vhrdtech/kicad-library/README.md

VHRD KiCad library
---

VHRD's own KiCad parts: the symbols and footprints behind VHRD's boards, three project templates, and `kilib`, a
small CLI that sets up and checks the library. The symbols, footprints and templates are free to reuse (see
"Licence" below); 3D models and third-party parts live outside this repo.

## Layout

Symbols live one per file in `symbols/VHRD_<KiCad library>.kicad_symdir` (KiCad 10's own layout), footprints in
`footprints/VHRD_<KiCad library>.pretty`: each library is named `VHRD_` plus the stock KiCad library it would
belong to, e.g. `VHRD_Connector_Molex` or `VHRD_Package_DFN_QFN`. Every part, whoever drew it first, is sorted the same
way; there is no separate vendor library (the private `VHRD_Vendor` one was folded in on 7 Nov 2026). KiCad's stock
footprints and symbols that a board uses are copied into the `VHRD_*` library of the same name (`VHRD_Resistor_SMD`,
`VHRD_Transistor_BJT`), so a KiCad update never changes them unannounced; `kilib stock diff` shows what upstream
changed since. No symbol of the library names a stock footprint or library: KiCad's stock libraries
need not be installed (`kilib check --only VHRD_`).

## Configuration

The library has two parts, each found through a KiCad path variable:

- `VHRD_LIBRARY_DIR`: this checkout, with `symbols/VHRD_*.kicad_symdir` and `footprints/VHRD_*.pretty`.
- `VHRD_3DMODEL_DIR`: the 3D models, in `own/` and `vendor/`. They are not part of this repo.

`kilib setup --map migrate/2026-11.toml --models-dir DIR` writes the library rows and the variables
into this PC's KiCad config (see below). `KICAD_USER_TEMPLATE_DIR` points at `templates/`, so File, New Project from
Template offers "Vhrd Default", IO30 and Hammond-1455C801. Each template embeds its drawing sheet.

Without `kilib setup`, set the two variables and the library rows by hand: in KiCad's "Configure Paths", point
`VHRD_LIBRARY_DIR` at this checkout and `VHRD_3DMODEL_DIR` at the 3D models' folder. Then add a row per library in "Manage
Symbol Libraries" / "Manage Footprint Libraries": name it after the folder, type KiCad, and point it at
`${VHRD_LIBRARY_DIR}/symbols/<name>.kicad_symdir`, and the
same under `footprints/<name>.pretty` for footprints.

## Checking boards: kilib

`tools/kilib` is a small Rust CLI (MIT) that knows how KiCad finds libraries. `just install` builds it and puts
`kilib` on PATH.

- `kilib check PATH...` reads every `.kicad_sch`, `.kicad_pcb`, `.kicad_sym` and `.kicad_mod` under the paths and
  checks that each symbol (`lib_id`), `Footprint` field, footprint and 3D model resolves on this PC. It uses the
  global `sym-lib-table` and `fp-lib-table` and the "Configure Paths" variables of the KiCad config folder
  (`KICAD_CONFIG_HOME`, else `~/.config/kicad`, the newest version), each project's own tables, `${KIPRJMOD}`, the
  environment (which wins, as in KiCad) and the older `KICAD6..9_3DMODEL_DIR` falling back to the newest set. It exits
  1 with the list of what does not resolve; `--json` gives the same as JSON. `--config-dir`, `--sym-lib-table`,
  `--fp-lib-table` and `--var NAME=VALUE` check against another PC's setup. `--only VHRD_` also fails on anything
  from a library whose name does not start with the prefix: a symbol, footprint or `Footprint` field, a schematic's
  embedded symbols (`lib_symbols`) and the library part of `ki_fp_filters`, so a board that still needs KiCad's stock
  libraries shows.
- `just check-boards` runs it on the hw checkout beside this one (or `VHRD_BOARDS_DIR`) and skips with a note where
  there is none.
- `kilib setup --dry-run` shows what `kilib setup` would write into this PC's KiCad config. The library rows go
  through `${VHRD_LIBRARY_DIR}` (this checkout) and `${VHRD_VENDOR_LIBRARY_DIR}` (the private vendor library,
  `--vendor-dir`). They come from a rename map's `[libraries.symbol]` and `[libraries.footprint]` tables (`--map
  migrate/2026-11.toml`), or else from the library folders found. They replace every `vhrd_*` and `VHRD_*` row. The
  variables are `VHRD_LIBRARY_DIR`, `VHRD_VENDOR_LIBRARY_DIR` and `VHRD_3DMODEL_DIR` (`--models-dir`), each only when
  given, plus `VHRD_TEMPLATE_DIR` and `KICAD_USER_TEMPLATE_DIR` for the drawing sheets. Every other row and setting
  stays as it is. It refuses while KiCad runs.
- `kilib migrate --map migrate/2026-11.toml PATH...` moves boards to a new library layout. It rewrites only the
  strings the map matches, and every other byte stays as it was: symbol ids (`lib_id`, `lib_name` and the schematic's
  `lib_symbols` cache), `Footprint` fields, `ki_fp_filters` entries, footprint ids, `${VHRD_3DMODEL_DIR}` model paths
  (and absolute paths into a `kicad-library/3dmodels` folder), and the old `vhrd_*` rows of a project's
  `sym-lib-table` and `fp-lib-table`, which become the rows of the new libraries. An id is looked up in `[symbol]` /
  `[footprint]` first, then its old library in `[symbol_lib]` / `[footprint_lib]`. `[filter_lib]` renames the library part of
  `ki_fp_filters` patterns (`"Connector*" = "VHRD_Connector*"`). `[per_package."Lib:Generic"]` moves a placed
  generic symbol to its per-package symbol by the footprint it is placed with (below); the schematic's `lib_symbols`
  cache gets a copy of the generic under the new name, with the footprint in `Footprint` and `ki_fp_filters`. It prints a unified diff (`git
  apply` takes it inside the folder given); `--write` applies it and `--stat` shows only the summary. A footprint the
  map dropped (`""`) that a board still uses, or two cached symbols that would get one name, is an error: it exits 1
  and writes nothing. Names the map does not know are listed and left as they are. A second run changes nothing.
- `kilib per-package --map migrate/2026-11-packages.toml [BOARD...]` makes per-package symbols. A generic symbol
  (`VHRD_Device:R`) leaves `Footprint` empty, so what is keyed by the library symbol (a footprint review, a BOM line)
  cannot cover it; each package it is placed with gets a symbol of its own (`VHRD_Device:R_0402`), derived from the
  generic in its library (`extends`), with `Footprint` and `ki_fp_filters` set to the footprint. The map's
  `[per_package]` tables name them. Those the checkout lacks are listed (exit 1) or written with `--write`; those
  there are checked. With boards, it lists the generic symbols their schematics place, by footprint, with the map's
  symbol or "not in the map", and their references. Then `kilib migrate --map migrate/2026-11-packages.toml BOARD`
  moves the board onto them. The generic symbols stay for new designs.
- `kilib restructure --map migrate/2026-11.toml --vendor-dir DIR` moves this checkout's own symbols and footprints
  into the map's new libraries. Each `symbols/<old>.kicad_sym` becomes one `.kicad_sym` per symbol in
  `symbols/<New>.kicad_symdir`, as KiCad 10's own libraries are laid out (a `/` in a name is `{slash}` in the file
  name; a derived symbol goes to its parent's library). Footprints move to `footprints/<New>.pretty`. Libraries under
  `${VHRD_VENDOR_LIBRARY_DIR}` go to `DIR`. The text of each symbol and footprint stays as it was, except what
  `migrate` rewrites in it (model paths, `Footprint` fields). The old files are removed once the new ones are written.
  `--dry-run` lists every move.
- `kilib designators [PATH...]` keeps each footprint's designator on its own layer only (default: this
  checkout's `footprints/`; `kilib fab-designators` is its old name). F.Fab and B.Fab carry the drawing alone
  (outline, pin-1 and polarity marks, inner lines), no text. A real part's designator goes to `Ref.Des.F` (User.23;
  `Ref.Des.B`, User.24, for a bottom-side footprint); test points, net ties (net ties, spark gaps, solder jumpers)
  and mechanical or graphic footprints (mounting holes, fiducials, logos) use their own layers `Ref.Test`, `Ref.Tie`
  and `Ref.Mech`, the class decided from the footprint's library and name and the designator's prefix (TP; NT, E,
  JP; H, FID). The `Reference` property goes there, visible and unlocked (a mechanical one hidden, where it was);
  `${REFERENCE}` texts on the silkscreen, the fab layer and the designator's layer go. The text's ink, measured in
  KiCad's stroke font with its strokes, sits centred on the body: the fab outline, else the courtyard. It may run
  over the pads, since KiCad draws the selected layers on top of them, while text outside the body would run into
  the neighbouring parts. A library footprint is sized for the longest designator of its kind (`R1004`, `C1001`,
  `TP526`, `JP104`, `U1004`). 0.02 mm stays free between the text's strokes and every line of the fab drawing of the
  same side (outline, polarity and pin-1 marks, diode symbols, inner lines), so the two read together. It gets the
  largest size from 1 mm down to 0.2 mm that fits on the centre, level or turned to read top to bottom. Where neither fits, it moves to
  the largest free spot inside the body nearest the centre. The smallest parts (0201, 01005, SOD-523) may go down to
  0.15 mm, and the report lists them as "tiny". Where nothing fits at all it stays on the centre at 0.2 mm, and the
  report lists the footprint as "no clean fit". The text's stroke is 15 % of its size, at least 0.025 mm. Every line
  on F.Fab and B.Fab gets a 0.05 mm stroke. A footprint that already follows these rules is left alone. It lists
  what would change, with how many designators move, get resized and turn, and the sizes given, and exits 1;
  `--write` writes it. Boards take the new footprints through pcbnew's "Update Footprints from Library". A real
  part's `Value` property goes to `Value.F` (User.17; `Value.B`, User.18, on the back), shown and unlocked, centred
  and fitted the same way for the longest typical value of its kind (`100K`, `100nF`, `4.7uH`, `BAS16TW`,
  `TPS54202`). The designator is no obstacle to it: Ref.Des and Value are both centred, so they are separate layers
  shown one at a time. The Value of a test point, net tie or mechanical footprint stays hidden on the fab layer,
  where it was.
- `kilib designators --board BOARD.kicad_pcb` fits each placed footprint's own designator the same way, so `R7`
  gets larger text than `R1004` would, and each real part's Value on `Value.F`/`Value.B` for its own text (`10K`).
  It touches only footprints whose Reference (and Value) is already on its layer (as the library puts it), and of
  those only the two properties' position, angle, size and thickness; the angle is written so the text reads left to right or top to bottom, as the editor shows it from
  its side (0° or 270° on the front, 0° or 90° on the back, a part's rotation included; see "Text direction" below). A `Layout_Critical` or `Layout_Important` note that is set gets the same on `Crit`/`Imp`, fitted to its own
  text beside the body inside the courtyard, along an edge or turned to read top to bottom at an end (see `layout` below), down to 0.05 mm (a short note reads fine much smaller
  than a designator) before it is reported with no clean fit; on a real part a set note that sits elsewhere or
  hidden (Update PCB from Schematic puts a field the footprint lacked hidden on the fab layer) is moved to its
  layer, shown. Each pin number of a part placed at a quarter turn (`Pins.F`/`Pins.B`, written by `lint --rule pins`) is
  turned by a half turn where needed so it reads left to right or top to bottom, its ink where it was, so the library's
  clearances hold; numbers at another angle, and those of parts on the back, are listed and left. `--write` writes the
  board.
- Text direction: every text kilib places (designators on `Ref.Des`/`Ref.Test`/`Ref.Tie`, Values, layout notes, pin
  numbers) reads left to right or top to bottom, never upside down or bottom to top, as the PCB editor shows it from
  the text's side. KiCad stores a text's angle as it is on the board and kilib writes `(unlocked yes)`, so the editor
  does not turn it back upright. On the front a text is at 0° (left to right) or 270° (top to bottom); on the back,
  mirrored, at 0° or 90°, seen with KiCad's default left-to-right board flip. A part's rotation adds to its texts'
  angle, so `kilib designators --board` writes each text's angle as the rotation plus its own, normalised to those
  two. The rule is in `kilib::reading`, used by all of them.
- `kilib layers BOARD.kicad_pcb...` names the user layers the library uses in a board's layer table, front and back
  pairs so KiCad flips a bottom-side footprint's text to the back one: User.9/10 `Ref.Test.F`/`Ref.Test.B` (test
  points), User.11/12 `Ref.Tie.F`/`Ref.Tie.B` (net ties, spark gaps, solder jumpers), User.13/14
  `Ref.Mech.F`/`Ref.Mech.B` (mounting holes, fiducials, logos; designator hidden), User.15/16 `Rooms.F`/`Rooms.B`
  (hand-drawn outlines of the circuit blocks), User.17/18 `Value.F`/`Value.B` (each real part's Value), User.19/20
  `Pins.F`/`Pins.B` (pin numbers), User.21/22 `Centroid.F`/`Centroid.B` (a cross on each placed footprint's origin),
  User.23/24 `Ref.Des.F`/`Ref.Des.B` (the designators of real parts), User.25/26 `Crit.F`/`Crit.B` and User.27/28
  `Imp.F`/`Imp.B` (a real part's layout-priority notes, see "Layout priority"), User.5/6 `Body.F`/`Body.B` (a
  part's full top view, the outline of its 3D model: the table body of the parts `kilib footprint chip` makes, the
  STEP model's top view of the others, drawn by hw's `tools/footprint_tools`; test points, net ties and mechanical
  footprints have none), User.7/8 `Xray.F`/`Xray.B` (every edge of the 3D model seen from above, hidden ones
  included: leads, terminations, bottom and exposed pads under the body, the pin-1 notch; the Pins presets show it,
  so pin numbers read against where the pins are), User.29/30 `Pin1.F`/`Pin1.B` (a dot or, on a polar two-pin part,
  a bar on pin 1's own pad, shown with the body, which has no pin-1 mark of its own; `kilib lint --rule pin1-body`).
  KiCad pairs user layers only by number (User.5 flips to
  User.6, never to User.7), so each pair is an odd number and the next. KiCad's own `Dwgs.User` and `Cmts.User`
  are named `Dimensions` and `Fab.Notes`. Bodies drawn before the Body pair existed (footprint drawings on User.2,
  then named `Body.F`, which KiCad did not flip) move to `Body.F` or `Body.B` by the footprint's side, and User.2
  loses the name; the board's own drawings on User.2 stay. A board still in KiCad 8's layer numbering is refused: open and save it in KiCad 10 first. The
  templates have them; a board made before needs them once, with
  `kilib layers --write` or by hand in Board Setup > Board Editor Layers (add the user layers, name them, set
  their type to front or back). A number the board already uses under another name is left alone and reported.
  Only the layer table and the layer of those old bodies change.
- `kilib presets PROJECT.kicad_pro...` writes the PCB Editor's layer presets of `generate/layer-presets.toml` into
  a project's `board.layer_presets`: `Layout.F`/`B` (F.Cu/B.Cu, F.Fab/B.Fab, Crit, Imp, Ref.Des, Courtyard,
  Edge.Cuts; pads, vias and ratsnest shown), `Floorplan.F`/`B`/`FB` (Courtyard, Ref.Des, Crit, Imp, Body, Pin1, Ref.Test, Ref.Tie, Edge.Cuts), `Assembly.Ref.F`/`B` and `Assembly.Value.F`/`B` (Body, Pin1, Ref.Des or Value, Edge.Cuts; pads shown), `Pins.F`/`B` (Pins, Fab, Xray, Edge.Cuts; pads shown) and `Silk.F`/`B` (SilkS, Mask, Paste, Cu, Edge.Cuts), each `B`
  the back counterpart, viewed from below. A preset already in the project under the same name is replaced; the
  project's other presets are kept, in their place. The sibling board (same name, `.kicad_pcb`) is checked for the
  user layers the presets name; a board that lacks one is told to run `kilib layers --write` first. Only
  `board.layer_presets` changes, byte for byte; the three templates have them. Without `--write` it lists what
  would change and exits 1 when anything would.
- `kilib lint [PATH...]` checks footprints against the library rules (default: this checkout's `footprints/`;
  `--rule` picks some of them) and lists, per footprint, what each fix changes and what is left for a person
  (`--left` only that, `--json` as JSON). It exits 1 while a fix is not written; `--write` writes them. The designator
  belongs to `designators`: run it after `--write`, since a new chamfer or courtyard can move it. The rules:
  - `pin1`: a part with three or more pins, and a polar two-pin part (diode, LED, battery, polarised capacitor; pin 1
    is the cathode or the plus), marks pin 1 on the fab layer, and on the silkscreen where it draws one. The pads
    often fit the part turned half or a quarter round; for each such turn the drawing must show a mark (a dot, a
    filled shape, a chamfered corner, a diode's cathode bar, a `1` or `+`) by pin 1 and not by the pad the turn takes
    it to. A part is never mirrored, so a SOIC's notch counts. The fix chamfers the pin-1 corner of a rectangular
    fab outline (1 mm, at most a quarter of the shorter side) and puts a filled triangle pointing at pin 1 on the
    silkscreen, outside the body and 0.15 mm clear of the pads. Marks that are missing elsewhere, ambiguous or by
    the wrong pad are reported. A part that wants no pin-1 mark loses the ones it has: a three-pin part whose pads
    already tell pin 1 apart (no turn the pads allow lands pin 1 on another pad: SOT-23, SOT-323, SOT-723), a
    footprint tagged `symmetric`, and a part that works the same placed half a turn round. That is one whose pads,
    turned half round about the origin or the pads' centre, each land on a pad of the same kind and size, and where
    every symbol whose `Footprint` field names it keeps its circuit: pins of one name are one node, and so are the
    pins of one group in `generate/connected-pins.toml` (pins a part joins inside that its symbol names apart); the
    turn moves no node, or swaps the only two it moves of a resistor, capacitor, inductor, ferrite bead, crystal,
    fuse or switch (a 4-pad crystal, the PTS815 tact switch, a DPDT slide switch). A footprint no symbol uses keeps
    its marks. The fix takes off each mark with no twin half a turn round or mirrored (dots, filled or small closed
    shapes, a `1` or `+`; a chamfered corner is squared again) on the fab layer and the silkscreen, and the 3D
    model's pin-1 dimple on Xray.F/B (a lone circle up to 0.5 mm). The outline stays. A keyed connector, switch or
    mechanical part (library `Connector*`, `Button_Switch*`, `Mechanical`) wants no mark either: the body fits only
    one way, and the pinout needs the datasheet anyway (a USB-C receptacle, an RJ45 jack, a D-sub). Keyed means no
    quarter, half or three-quarter turn about the origin or the pads' centre lands every pad, mounting pads and
    holes included, on a pad of the same kind, shape, size and side while the fab body stays where it was. On these
    the fix also fills in a notch cut into the fab outline and takes off a short silkscreen line standing alone by
    pin 1 (KiCad's RJ45 marks). The exception is a row that pin 1 helps to count: the pads numbered 1 to N, N at
    least 4, one size (pin 1's shape may differ), evenly pitched in one row numbered in order, or in a straight
    double row (odd and even across, or one row after the other); mounting pads do not count. Such a connector (FFC,
    board-to-board, pin header) keeps its marks and gets the Pin1 dot; a staggered row (RJ45, D-sub) and named pins
    (USB-C's A1 to B12) are no counting row. Any other part whose pads tell pin 1 apart (a DFN, a module) keeps its
    fab and silkscreen marks, which match the chip's own dot.
  - `pin1-body`: a polar two-pin part (diode, LED, battery, polarised capacitor) gets a bar on `Pin1.F` (User.29;
    `Pin1.B`, User.30) across the cathode or plus pad's centre, square to the part's axis, as long as the pad
    reaches across it, 0.15 to 0.25 mm thick (by part size). A part of three or more pins gets a filled dot instead,
    0.3 mm across on a small part up to 0.8 mm on a big one (a tenth of the body's shorter side, under 0.9 times the
    distance to the nearest other pad), centred on pin 1 — unless the pads alone already tell pin 1 apart (no turn
    the pads allow, `pin1`'s own turns, lands pin 1 on another pad: an asymmetric SOT-23, SOT-323, SOT-89, SOT-223)
    or the part works the same turned half round or is a keyed connector (`pin1` above), which gets no mark either
    (a keyed connector with a row that pin 1 helps to count gets the dot); a symmetric part (QFN, QFP, SOIC, SOT-23-6, SOT-363, a connector with a symmetric pad
    row) keeps the dot. Either mark sits exactly on pin 1's pad (its anchor, the same point for every shape of a
    multi-shape pad): no search for a free spot, no check that it clears another pad. No mark on non-polar two-pin
    parts, test points, net ties and mechanical footprints. The fix replaces anything else on the layer.
  - `attrs`: test points, net ties, spark gaps, jumpers, logos and mounting holes are excluded from the BOM and the
    position files, with no SMD or through-hole type (net ties and logos may have no courtyard); fiducials are SMD
    and excluded from the BOM only; a part is SMD when all its copper pads are, through-hole when one is. `board_only`
    is not set, since boards place these from the schematic. Mechanical footprints (screws, spacers, the enclosure,
    panel features) and parts kept out of the BOM are only reported.
  - `courtyard`: on F.CrtYd (B.CrtYd for a bottom-side footprint), closed, at least 0.25 mm from every pad and from
    the fab drawing, 0.1 mm for 0201, 0402 and 0603 passives (IPC-7351 nominal). The fix draws a missing one as a
    rectangle on a 0.01 mm grid, 0.05 mm wide, and grows one that is a single rectangle; other shapes are reported.
  - `models`: every part has a 3D model under `${VHRD_3DMODEL_DIR}` or `${KICAD10_3DMODEL_DIR}`, and the file exists
    (where the variables are set: KiCad's config, the environment, `--var NAME=DIR`; `--no-model-files` skips the
    files). The fix moves stock models from older KiCad variables to `${KICAD10_3DMODEL_DIR}` (`.wrl` to `.step`).
  - `silk`: lines are 0.12 mm (filled marks keep their stroke); no line reaches onto a pad's solder mask opening (the
    pad's mask expansion, else the footprint's, else 0); no text but pin-1 marks. The fix sets the widths and cuts
    lines, and the sides of rectangles and polygons, round the pads. Arcs and curves over a pad, and texts, are
    reported. Logos and other artwork are left alone.
  - `ref-outline`: a test point draws its pad's outline on its designator layer `Ref.Test` (User.9 / User.10): a
    circle 0.05 mm outside a round pad, else a rectangle 0.05 mm round it. A net tie, spark gap or solder jumper draws
    a rectangle 0.05 mm round its pads on `Ref.Tie` (User.11 / User.12). Lines are 0.05 mm, and the drawing replaces
    anything else on that layer. Mechanical footprints draw nothing on `Ref.Mech`. `designators` then fits the
    designator to this drawing as to a fab outline, and puts it beside the drawing (0.3 mm, else 0.2 mm, nearest)
    where nothing fits inside.
  - `pins`: pin numbers on `Pins.F` (User.19; `Pins.B`, User.20, on the back): every pin of a connector; pin 1 and
    every 5th (every 10th past 40 pins) of another part with three or more pins; pin 1 only where the pins are not
    numbered with digits (a BGA's `A1`); none on two-pin parts, test points, net ties, logos and holes, and none for
    a pad on the copper of one already numbered (USB-C's `B12` on `A1`). Each is a stroke text inside the part, at
    its pad's inner end: inside the fab outline (else the courtyard), toward the body's middle, 0.1 mm clear of every
    pad and hole and a glyph's height from the other numbers; a pad wholly outside the body has its number pulled in
    to the body's edge. Text reads left to right, or top to bottom where level does not fit (on the back level only);
    never upside down or bottom to top. Next to a pad in line, a number stands only where it is nearer its own pad
    than the other (a third as near, for the next pin of the row). A number with no room inside, or a footprint with
    neither fab outline nor courtyard, keeps the number beside its pad, outside and level, and is reported
    (`left`). A footprint gets one size for all its numbers, of 0.5 to 0.2 mm the one with the most numbers inside,
    the largest of those; one that fits nowhere is reported. The fix replaces anything else on the layer.
  - `centroid`: a cross on `Centroid.F` (User.21; `Centroid.B`, User.22) at every part's and fiducial's origin, the
    point the position file gives: two 0.5 mm lines, 0.05 mm wide. Show the layer over the board to check the
    placement data. The fix replaces anything else on the layer.
  - `layout`: every real part has the properties `Layout_Critical` on `Crit.F` (User.25; `Crit.B`, User.26, on the
    back) and `Layout_Important` on `Imp.F` (User.27; `Imp.B`, User.28), visible and unlocked, fitted for the note
    `U1001.48` (down to 0.05 mm, a short note reads fine much smaller than a designator) inside the real
    courtyard beside the body: level along a longer edge, or turned to read top to bottom at a shorter one,
    whichever gives the larger text (a passive's long edges are thin, its ends have room); ties keep the longer pair
    (top/bottom for a courtyard at least as wide as tall, else left/right). Critical takes the best placement,
    Important the opposite side where it fits, clear of the designator's own ink and, for Important, of Critical,
    so they never overlap even though both show together on the Floorplan preset. Where the footprint draws no
    courtyard, or the body already fills it, a note falls back to the centre instead, reported. Test points, net
    ties, mechanical and graphic footprints have neither. The fix adds them or puts them back in place and removes
    a stray one; a note set in the library is
    reported, as the note belongs to the schematic.
- `kilib layout-fields [PATH...]` adds the empty, hidden symbol fields `Layout_Critical` and `Layout_Important`
  where a symbol lacks them: to each symbol of a library file (default: this checkout's `symbols/`), and in a
  schematic to each placed symbol and its copy in the schematic's `lib_symbols`. A new field copies a hidden field of
  the same symbol (`Description`, else `Datasheet`, else `Footprint`), so it is written the way that file writes its
  fields. Power symbols and power flags get none. It lists what would change and exits 1; `--write` writes.
- `kilib stock import Lib:Name...` copies KiCad stock footprints to `footprints/VHRD_<Lib>.pretty/<Name>.kicad_mod`:
  the fixes of `kilib lint`, the designator and the Value placed by the `designators` rules, the fab lines at 0.05 mm, the 3D model at the library's copy of KiCad's model, `${VHRD_3DMODEL_DIR}/vendor/VHRD_<Lib>.3dshapes/` (the STEP file is copied there by hand), every other byte as in stock (pads). The stock folder is `--stock-dir`,
  else `KICAD10_FOOTPRINT_DIR` (environment or KiCad's "Configure Paths"), else `/usr/share/kicad/footprints`. A
  footprint the library has already is left alone. It lists what it would copy and exits 1; `--write` copies. `kilib
  stock diff` compares every `VHRD_<Lib>:<Name>` that has a stock `<Lib>:<Name>` with a fresh import of it and prints
  the unified diff (what taking in the stock footprint would change; `--stat` only lists them); it exits 1 when any
  differs. Footprints of our own that share a stock name show up there too. `migrate/2026-11-stock.toml` maps the
  imported stock ids to the copies for `kilib migrate`.
- `kilib stock import --symbols Lib:Name...` does the same for stock symbols, into
  `symbols/VHRD_<Lib>.kicad_symdir/<Name>.kicad_sym`: a derived symbol is made standalone (its parent's pins, units and
  graphics under its own name and fields), the `Footprint` field points at our copy of the footprint where
  `footprints/` has one, library parts of `ki_fp_filters` patterns get `VHRD_`, and an empty `Mpn1` and the empty
  `Layout_Critical` and `Layout_Important` fields are added. The
  stock folder is `--stock-symbol-dir`, else `KICAD10_SYMBOL_DIR`, else `/usr/share/kicad/symbols`. `kilib stock
  diff` compares the symbols too; a copy's fields and flags are ours, laid over the fresh import, so the diff shows
  what stock changed in pins, units and graphics and the fields stock has that the copy has not. A kind whose stock
  folder is not found is skipped with a note.
- `kilib model chip [NAME...]` writes the STEP models of the chip passives and power inductors in `generate/`
  (`chip-passives.toml`: chip R, C and L, body length, width, termination band and the heights each size is made in;
  `power-inductors.toml`: power-inductor bodies, bottom terminations and lands), one per size and height, as
  `${VHRD_3DMODEL_DIR}/generated/VHRD_<Lib>.3dshapes/<footprint>.step` (`--out DIR` for another folder). Each model is
  the body and its terminations as coloured solids on the board, centred on the footprint origin: an MLCC tan with
  nickel-tin ends, a resistor's white alumina with its black overcoat, ferrite or ceramic chip inductors, dark power
  inductors with their bottom electrodes. The STEP file is written by kilib itself (AP214, straight prisms as
  B-rep solids with a colour each), no CAD kernel involved. It lists what it would write and exits 1; `--write`
  writes.
- `kilib footprint chip [NAME...]` makes the footprints of the same tables, one per size and height. A chip part
  (`C_0805_2012Metric_H1.25`) is its size's base footprint (`C_0805_2012Metric`, the checkout's copy, else a fresh
  `stock import` of KiCad's IPC-7351 nominal one from `--stock-dir`) under the new name, its description naming body
  and height, its model the generated one; pads and drawing stay the base's. A power inductor
  (`L_Shielded_4.0x4.0mm_H2.0`) is drawn from its row (the maker's land, the body on the fab layer) and finished with
  the fixes of `kilib lint` and the designator and Value of `kilib designators`. Only new files are written; one
  that differs from what would be made is reported and left. It lists what it would write and exits 1; `--write`
  writes.
- Shell completion: `source <(COMPLETE=bash kilib)` (or `zsh`, `fish`).

### Layout priority

Parts that need care in layout (low-value decoupling, passives on a differential pair or in a feedback path, a
DC-DC converter's inductor) show in the PCB editor on layers of their own, without picking them out of the schematic
by hand. Two levels: critical (`Crit.F`/`Crit.B`, User.25/26) and important (`Imp.F`/`Imp.B`, User.27/28, bulk
decoupling and the like). The schematic sets a short note in the symbol's `Layout_Critical` or `Layout_Important`
field (`U101.5 VDD`, `FB U301`); Update PCB from Schematic carries it to the footprint's property of the same name,
which shows on its layer; an empty field shows nothing. Every library symbol has both fields, empty and hidden, and
every real part's footprint both properties, empty and shown, fitted beside the body inside the courtyard, along an edge or turned to read top to bottom at an end, rather than
the designator's own centre, so the Floorplan preset (courtyard, fab, Ref.Des and Crit/Imp together) reads the two
apart (`kilib layout-fields`, `kilib lint --rule layout`).

How KiCad 10 treats them, and what a board made before needs:

1. Update PCB from Schematic sets only the text of a footprint field the footprint has: its layer, position and size
   stay as the library put them. An empty symbol field empties the footprint's text. This needs "Update footprint
   fields from symbols" ticked (the default).
2. A field the footprint lacks is created hidden on F.Fab (B.Fab on the back) at the footprint's origin, and "Update
   Footprints from Library" with its default options keeps it there. So update the footprints from the library
   before the first Update PCB from Schematic; `kilib designators --board BOARD --write` moves a set note that went
   to the fab layer.
3. A footprint field the symbol lacks is left alone, unless "Remove footprint fields not found in symbols" is
   ticked.
4. DRC `footprint_symbol_field_mismatch` (a warning, also run by `kicad-cli pcb drc --schematic-parity`) reports a
   footprint that lacks a field its symbol has, empty or not, and a text that differs (one per footprint). A
   footprint field the symbol lacks is not reported. `lib_footprint_mismatch` ignores fields.
5. ERC `lib_symbol_mismatch` reports every placed symbol whose copy in the schematic lacks the fields the library
   now has. "Update Symbols from Library" adds them (its defaults keep a note that is set), and so does `kilib
   layout-fields --write SCHEMATIC_DIR`.

So a board made before the fields needs, in this order: Update Symbols from Library (or `kilib layout-fields`), Update
Footprints from Library, then Update PCB from Schematic. Until both sides have them, the parity DRC warns about
`Layout_Critical` on every footprint.

### Migrating an older board

```sh
kilib migrate --map migrate/2026-11.toml path/to/board            # look at the diff
kilib migrate --map migrate/2026-11.toml --write path/to/board    # apply it
kilib check path/to/board                                         # everything resolves
```

## Licence

The symbols, footprints and templates are CC-BY-SA 4.0 with KiCad's library exception — designs that use them stay
yours; see [LICENSE.md](LICENSE.md). `tools/kilib` is MIT; see [tools/kilib/LICENSE](tools/kilib/LICENSE).

## KiKit

Install KiKit for panelization support: [Installation](https://yaqwsx.github.io/KiKit/latest/installation/intro)

Install just to create shortcuts for various commands like: `just panelize`:
[Just](https://github.com/casey/just#installation)

[Panelization Examples](https://yaqwsx.github.io/KiKit/latest/panelization/examples/)
[Panelization Docs](https://yaqwsx.github.io/KiKit/latest/panelization/cli/)

### Arch

`sudo pacman -S python-kikit`
