vhrdtech/kicad-library/templates/Hammond-1455C801/meta/pcb.jpg

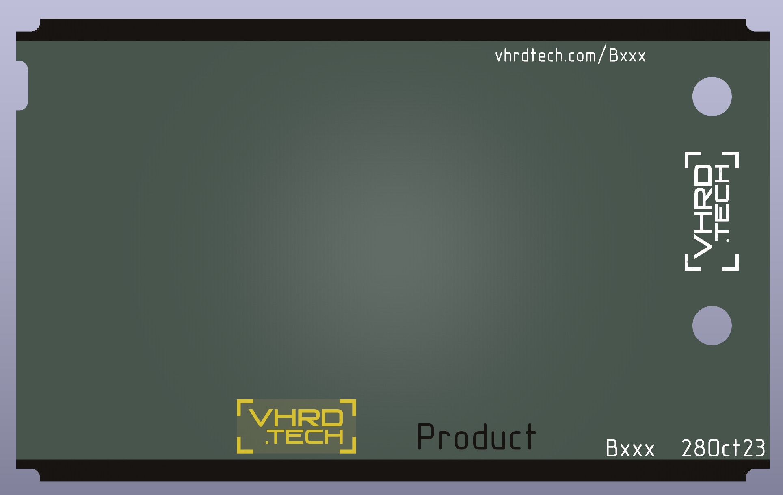
templates/Hammond-1455C801/meta/pcb.jpg
