vhrdtech/kicad-library/3dmodels/boards/vb125c1_button_board.step

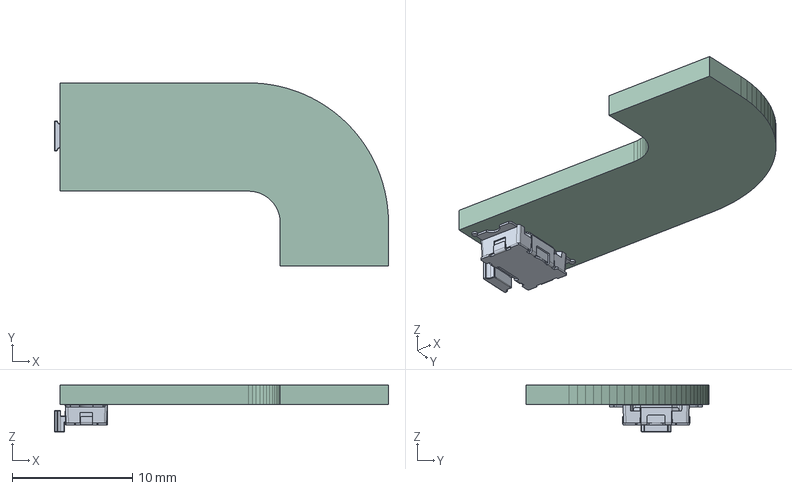
[picture p2: CAD file, 2023-08-31]
3dmodels/boards/vb125c1_button_board.step
27.8 x 15.2 x 3.90 mm
PCB
