vhrdtech/kicad-library/3dmodels/capacitors/CAPC5728.step

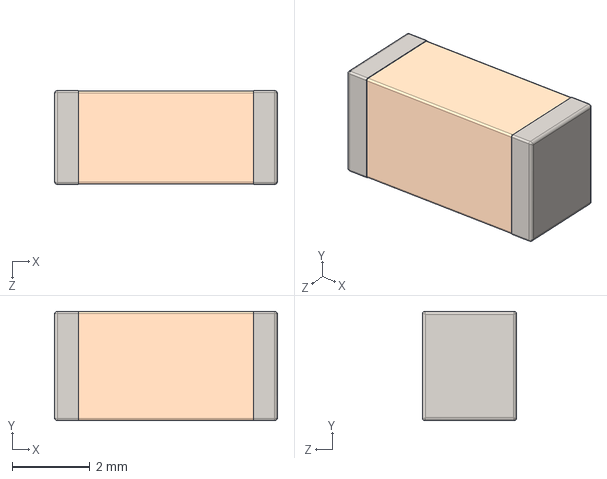
[picture p3: CAD file, 2023-10-09]
3dmodels/capacitors/CAPC5728.step
5.75 x 2.82 x 2.42 mm
