vhrdtech/kicad-library/3dmodels/connectors/amphenol/ID09P33E4GV00LF.STEP

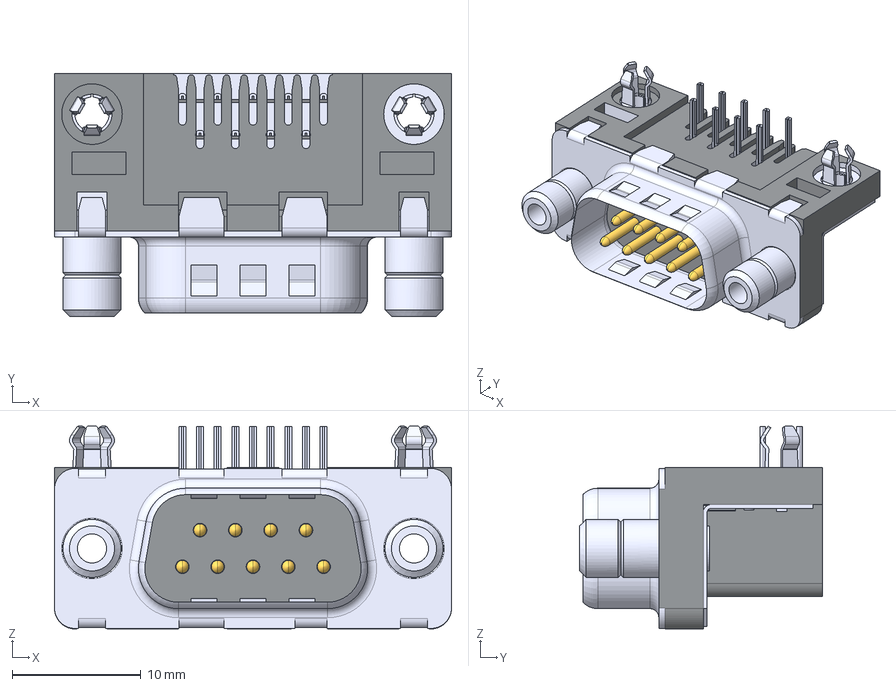
[picture p4: CAD file, 2025-11-09]
3dmodels/connectors/amphenol/ID09P33E4GV00LF.STEP
30.8 x 18.9 x 15.8 mm
