vhrdtech/kicad-library/3dmodels/connectors/battery/CR1632.stp

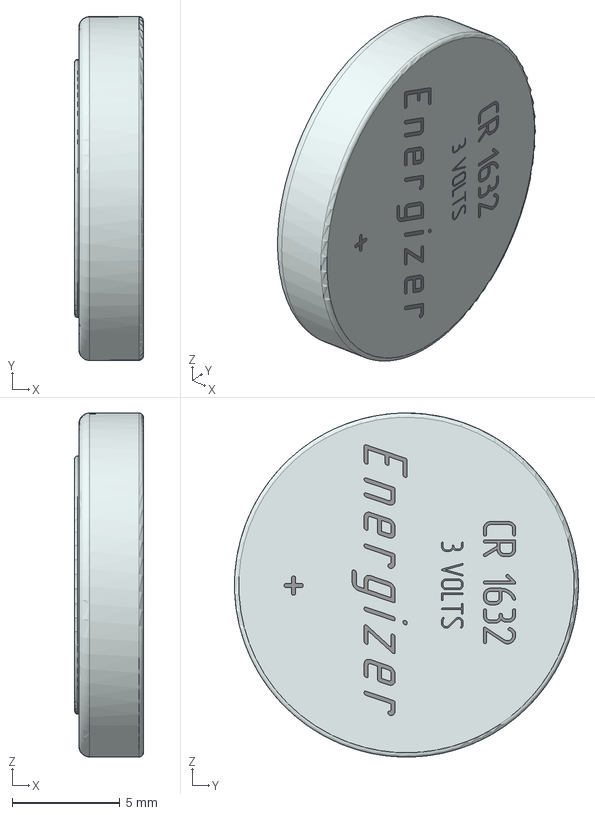
[picture p5: CAD file, 2024-12-04]
3dmodels/connectors/battery/CR1632.stp
3.20 x 16.0 x 16.0 mm
Undefined x 25
