vhrdtech/kicad-library/3dmodels/connectors/DX07P024AJ1R1500.STEP

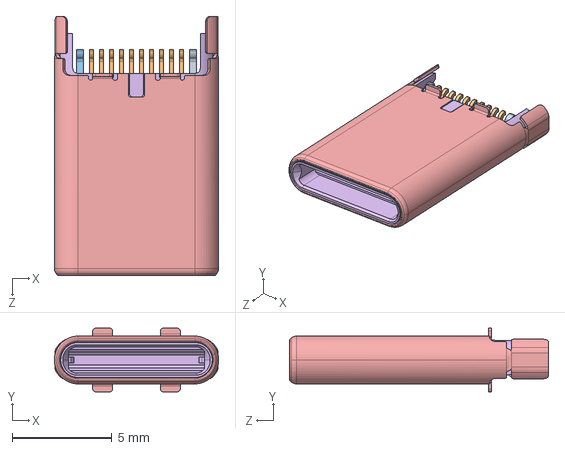
[picture p6: CAD file, 2024-07-14]
3dmodels/connectors/DX07P024AJ1R1500.STEP
8.25 x 3.20 x 13.0 mm
