vhrdtech/kicad-library/3dmodels/connectors/gct/FFC2B35-30-G.step

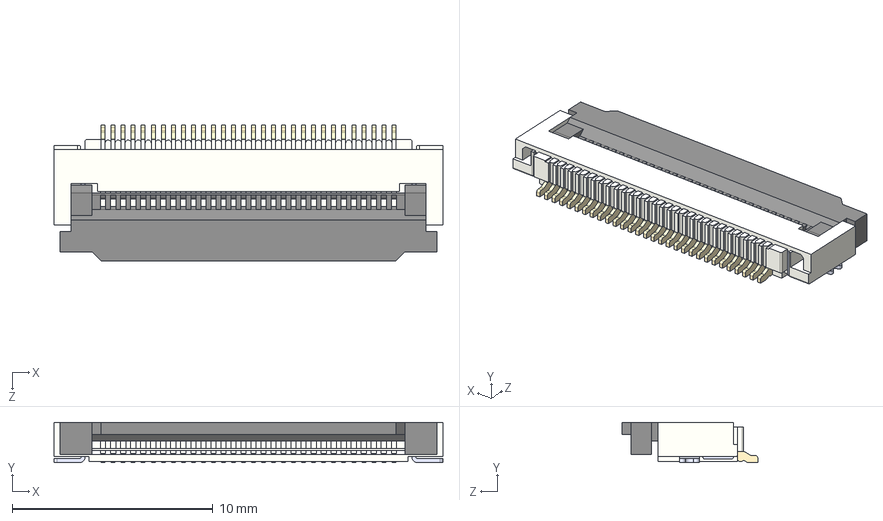
[picture p7: CAD file, 2026-07-28]
3dmodels/connectors/gct/FFC2B35-30-G.step
19.4 x 2.00 x 6.76 mm
