vhrdtech/kicad-library/3dmodels/connectors/globtek/plug-usbc-241smt-th-4bc2ls.stp

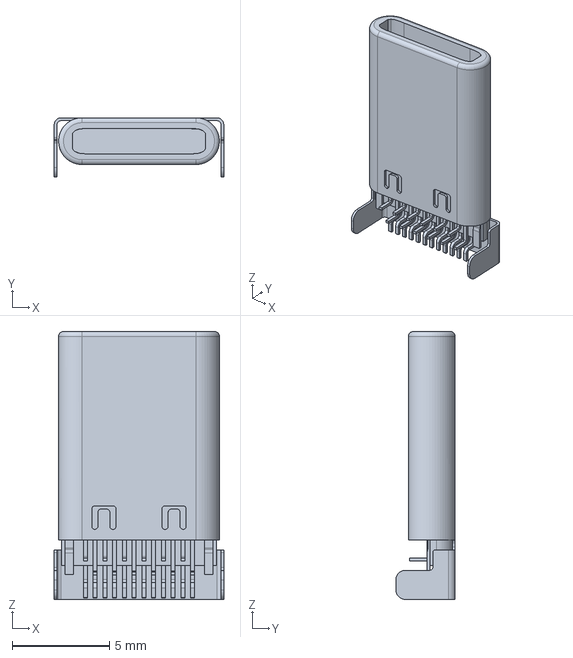
[picture p8: CAD file, 2025-11-09]
3dmodels/connectors/globtek/plug-usbc-241smt-th-4bc2ls.stp
8.70 x 3.05 x 13.8 mm
