vhrdtech/kicad-library/3dmodels/connectors/hirose/FH28K-60S-0.5SH.STEP

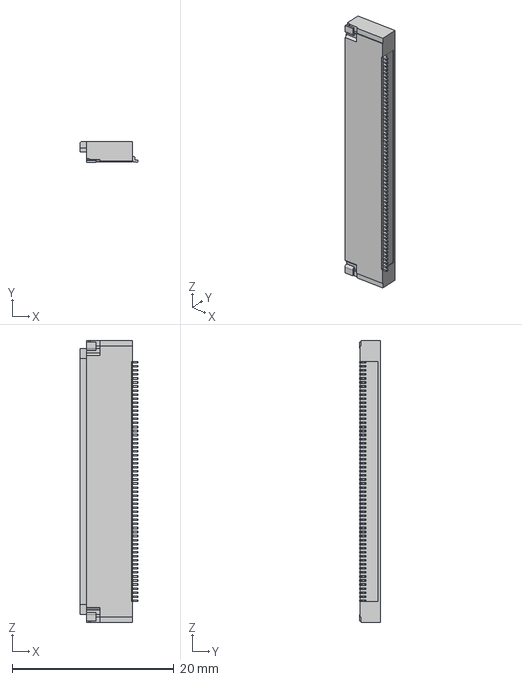
[picture p9: CAD file, 2026-01-28]
3dmodels/connectors/hirose/FH28K-60S-0.5SH.STEP
7.20 x 2.55 x 34.9 mm
