vhrdtech/kicad-library/3dmodels/connectors/mill_max/855-22-006-30-004101.STEP

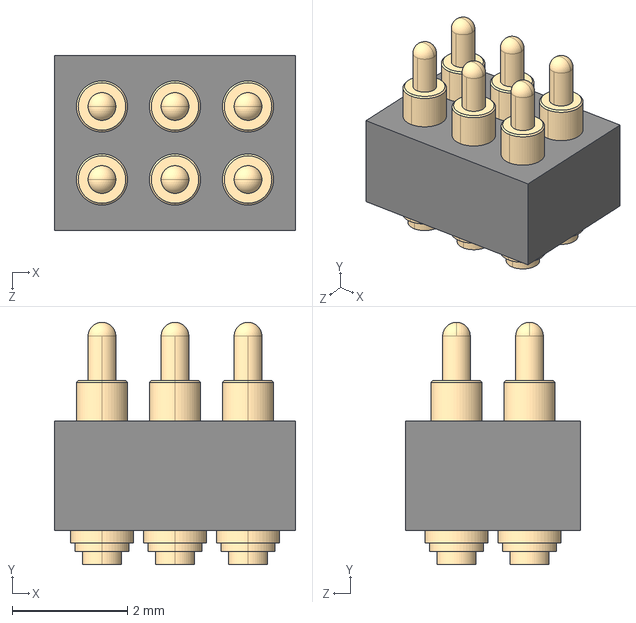
[picture p10: CAD file, 2026-07-24]
3dmodels/connectors/mill_max/855-22-006-30-004101.STEP
4.19 x 4.22 x 3.05 mm
