vhrdtech/kicad-library/3dmodels/connectors/samtec/QTH-030-02-F-D-A.step

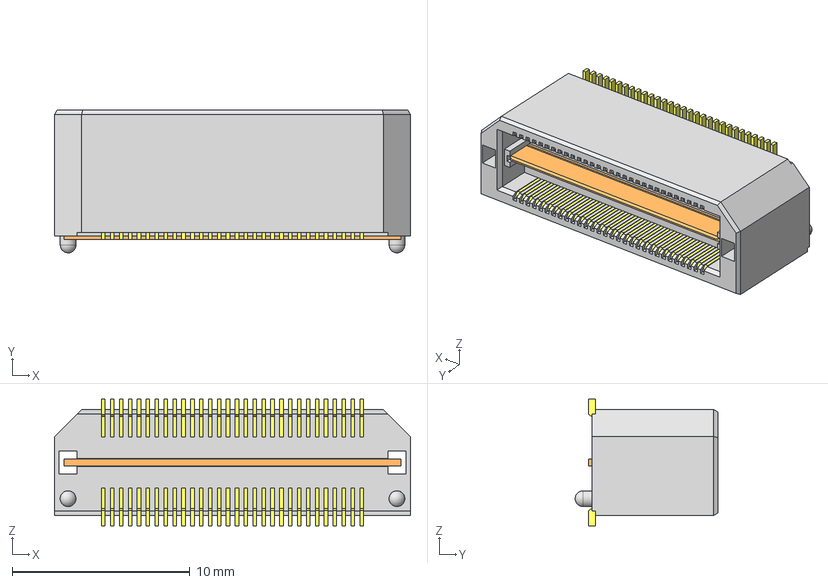
[picture p11: CAD file, 2023-06-01]
3dmodels/connectors/samtec/QTH-030-02-F-D-A.step
20.0 x 8.03 x 7.11 mm
T-1G1-02_imp
T-1S59-02(-030-02-D)_pin
TQTH-030-02-F-D-A_terminal
