vhrdtech/kicad-library/3dmodels/connectors/sullins/PPPC152LJBN-RC.STEP

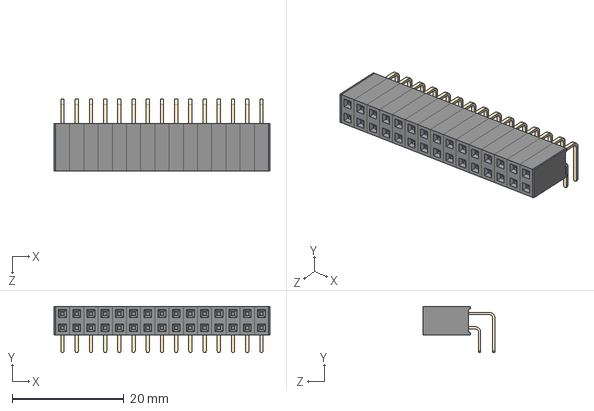
[picture p12: CAD file, 2026-07-27]
3dmodels/connectors/sullins/PPPC152LJBN-RC.STEP
38.6 x 8.23 x 12.8 mm
PPPC022LJBN-RC_C15
Pin - Gold x 15
