vhrdtech/kicad-library/3dmodels/connectors/te/1-1734264-1.step

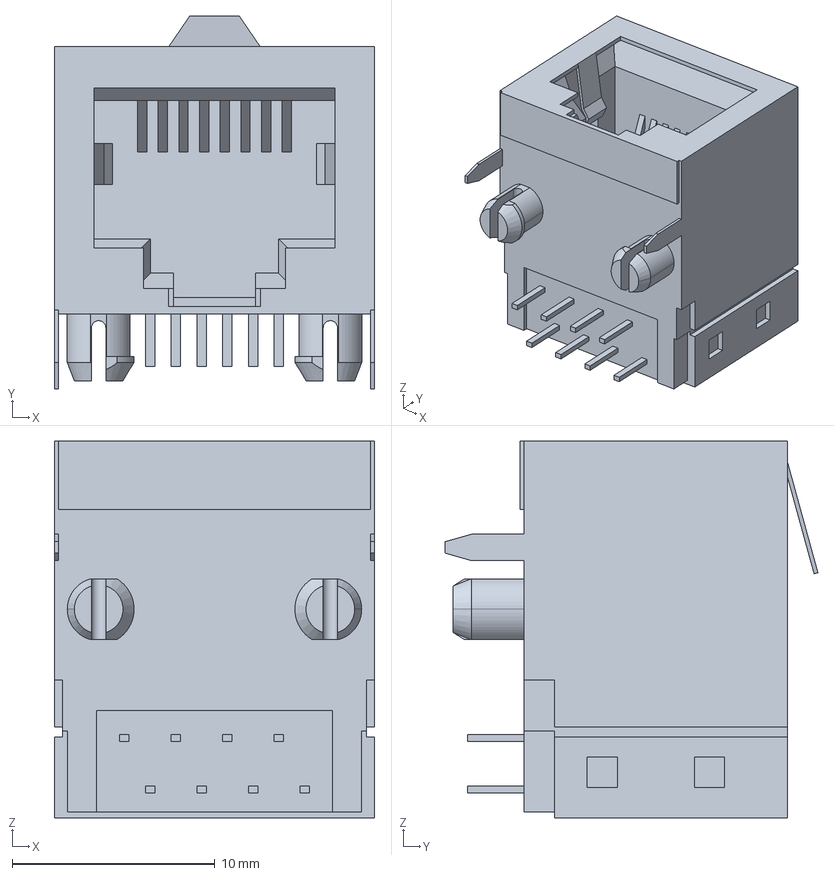
[picture p13: CAD file, 2024-12-04]
3dmodels/connectors/te/1-1734264-1.step
15.8 x 18.4 x 18.6 mm
