vhrdtech/kicad-library/3dmodels/connectors/wurth/Wurth_610112249121.stp

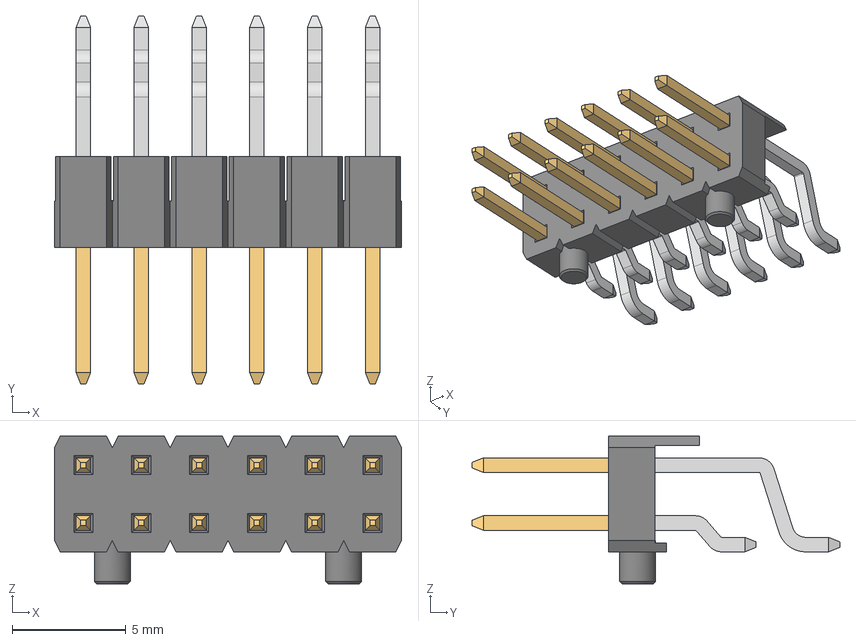
[picture p14: CAD file, 2024-07-14]
3dmodels/connectors/wurth/Wurth_610112249121.stp
15.2 x 16.2 x 6.48 mm
6100xx249121_PIN LONGUE x 6
6100xx249121_PIN COURTE x 6
