vhrdtech/kicad-library/3dmodels/crystal/ASE.STEP

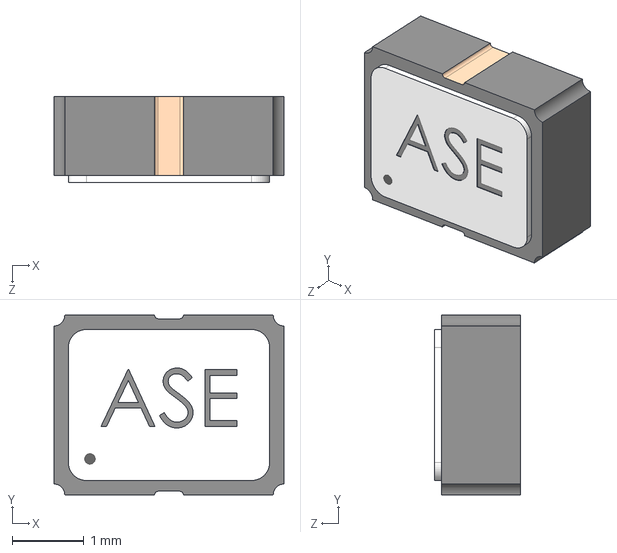
[picture p15: CAD file, 2023-06-16]
3dmodels/crystal/ASE.STEP
3.20 x 2.50 x 1.20 mm
