vhrdtech/kicad-library/3dmodels/displays/DM-OLED042-647.STEP

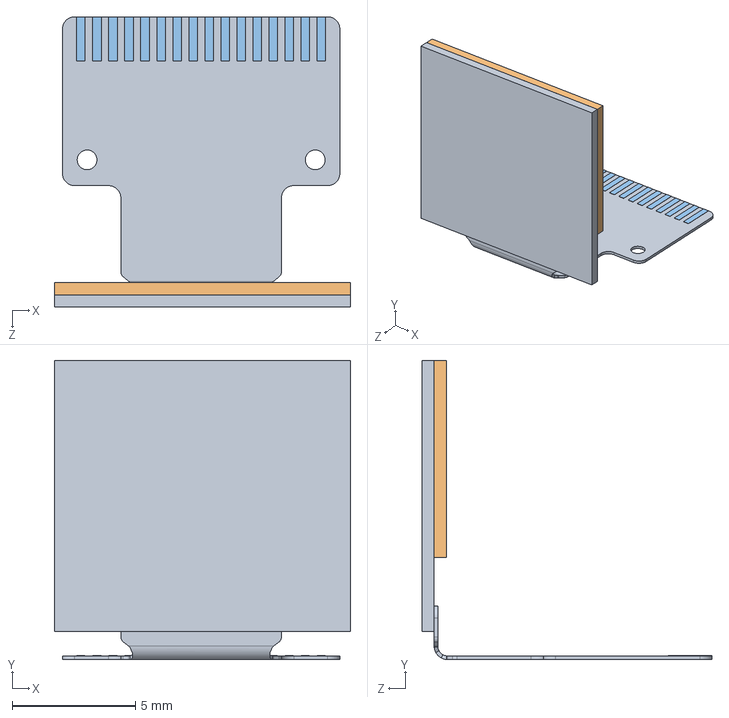
[picture p16: CAD file, 2023-05-22]
3dmodels/displays/DM-OLED042-647.STEP
12.0 x 12.1 x 11.8 mm
