vhrdtech/kicad-library/3dmodels/electromechanical/button/PTS815SJK250.STEP

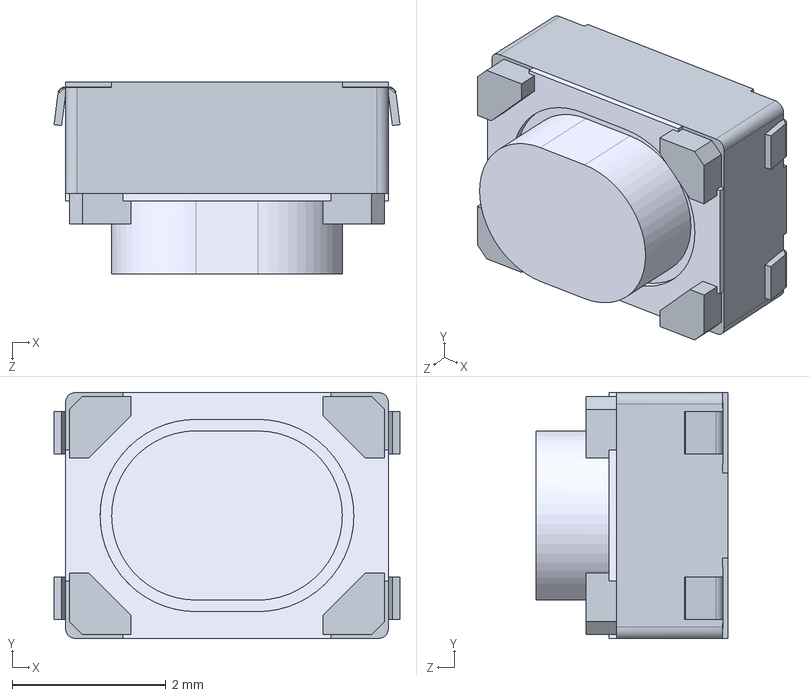
[picture p17: CAD file, 2026-01-14]
3dmodels/electromechanical/button/PTS815SJK250.STEP
4.50 x 3.20 x 2.50 mm
1_PTS815SJK250SMTRLFS(2)_PTS815SJK250SMTRLFS_____ _____________
1-0_PTS815SJK250SMTRLFS(2)_PTS815SJK250SMTRLFS_____ _____________
1-1_PTS815SJK250SMTRLFS(2)_PTS815SJK250SMTRLFS_____ _____________
