vhrdtech/kicad-library/3dmodels/ic/TI RSE0010A UQFN-10.step

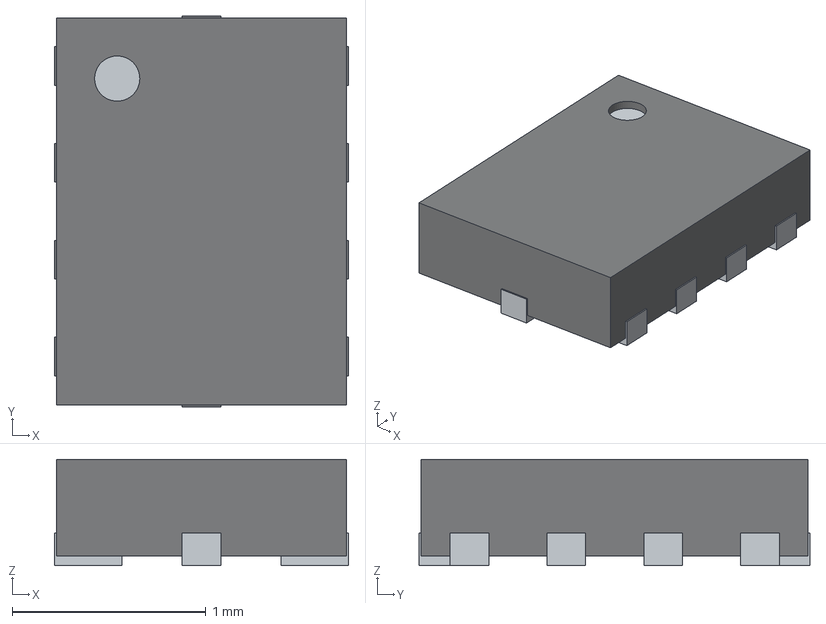
[picture p18: CAD file, 2026-08-12]
3dmodels/ic/TI RSE0010A UQFN-10.step
1.52 x 2.02 x 0.55 mm
