vhrdtech/kicad-library/3dmodels/inductors/IND0806.step

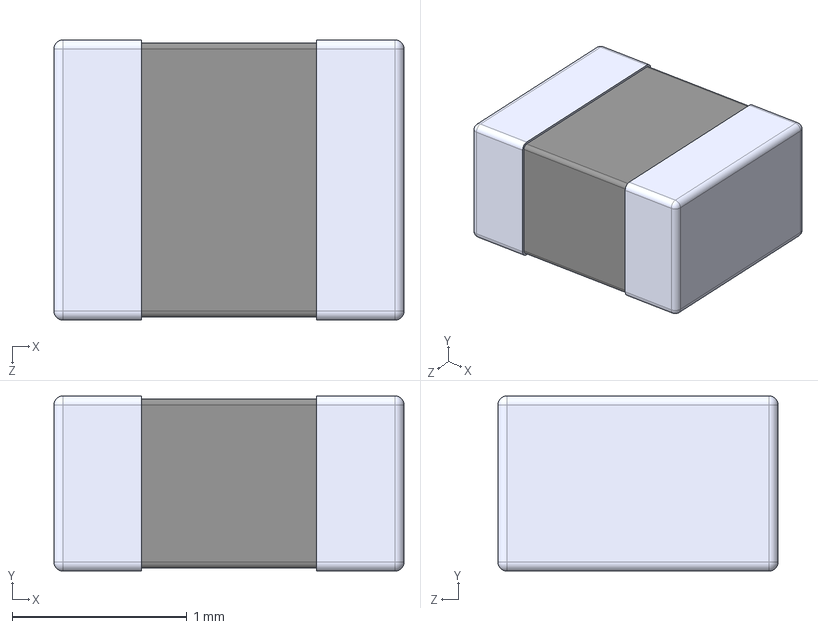
[picture p19: CAD file, 2023-10-09]
3dmodels/inductors/IND0806.step
2.00 x 1.00 x 1.60 mm
