vhrdtech/kicad-library/3dmodels/led/SLP3-200-100-F.step

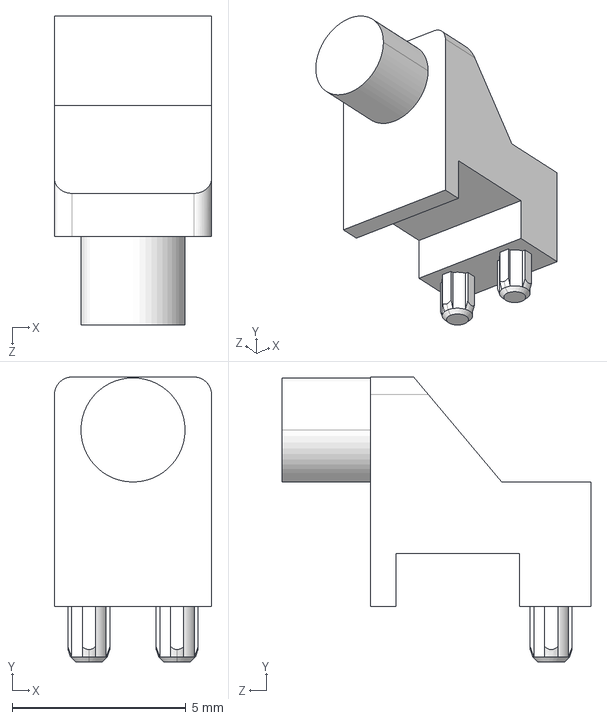
[picture p20: CAD file, 2024-12-04]
3dmodels/led/SLP3-200-100-F.step
4.52 x 8.20 x 8.89 mm
