vhrdtech/kicad-library/3dmodels/mech/Rod 1.0x7.1.step

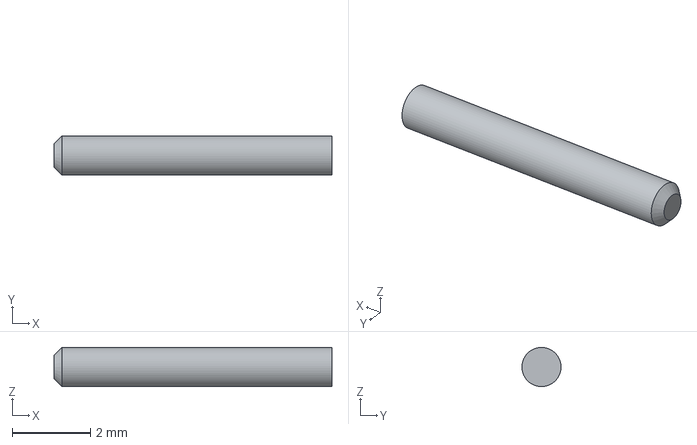
[picture p21: CAD file, 2026-07-24]
3dmodels/mech/Rod 1.0x7.1.step
7.10 x 0.999 x 1 mm
