vhrdtech/kicad-library/3dmodels/modules/power/MIE1W0505BGLVH-3R-Z.STEP

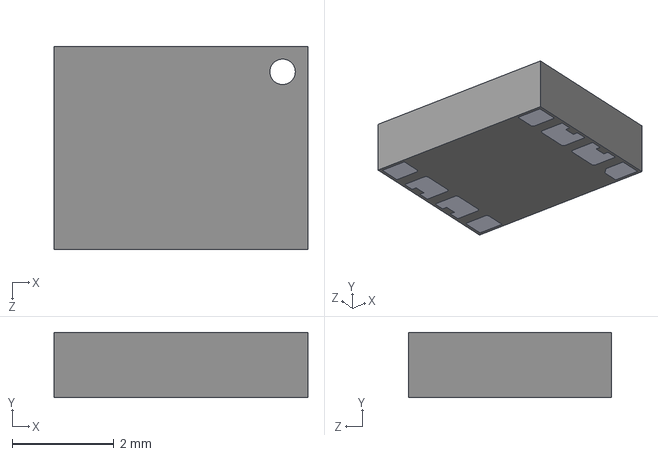
[picture p22: CAD file, 2025-11-09]
3dmodels/modules/power/MIE1W0505BGLVH-3R-Z.STEP
5.00 x 1.28 x 4.00 mm
