vhrdtech/kicad-library/3dmodels/sot/SOT-883.step

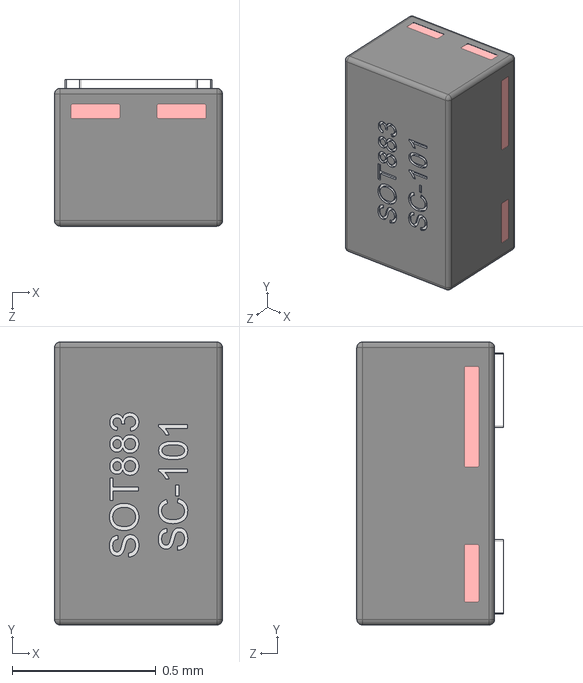
[picture p23: CAD file, 2026-07-17]
3dmodels/sot/SOT-883.step
0.585 x 0.985 x 0.51 mm
