vhrdtech/kicad-library/3dmodels/switches/CHS-02TB.STEP

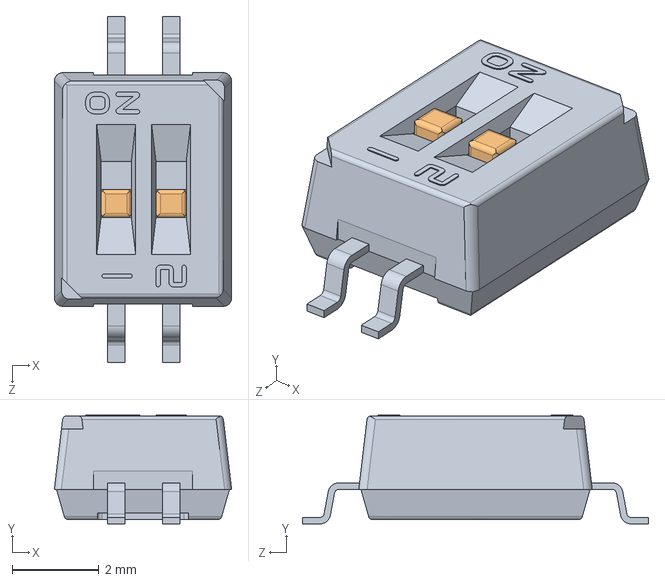
[picture p24: CAD file, 2024-12-04]
3dmodels/switches/CHS-02TB.STEP
4.10 x 2.52 x 8.00 mm
CHS-02-G-body
CHS-slider x 2
