vhrdtech/kicad-library/3dmodels/ti/10UQFN_1_50x2_00x0_5_0_5mm_pitch.STEP

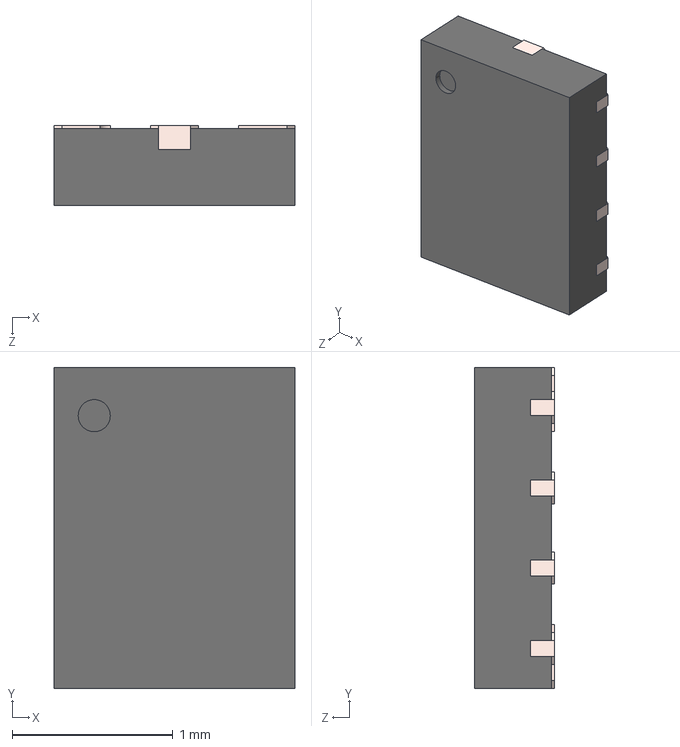
[picture p25: CAD file, 2024-12-04]
3dmodels/ti/10UQFN_1_50x2_00x0_5_0_5mm_pitch.STEP
1.50 x 2.00 x 0.5 mm
