vhrdtech/kicad-library/3dmodels/vhrd_mcu_stm_h7/LQFP-100_STM.STEP

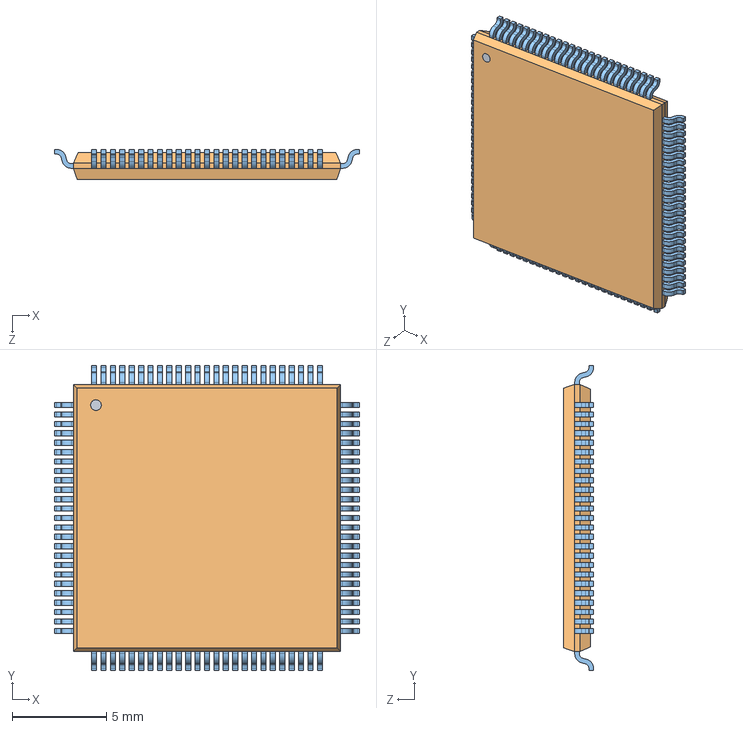
[picture p26: CAD file, 2024-12-04]
3dmodels/vhrd_mcu_stm_h7/LQFP-100_STM.STEP
16.2 x 16.2 x 1.60 mm
