vhrdtech/kicad-library/3dmodels/vhrd_module_power/B0505MT-1WR4.STEP

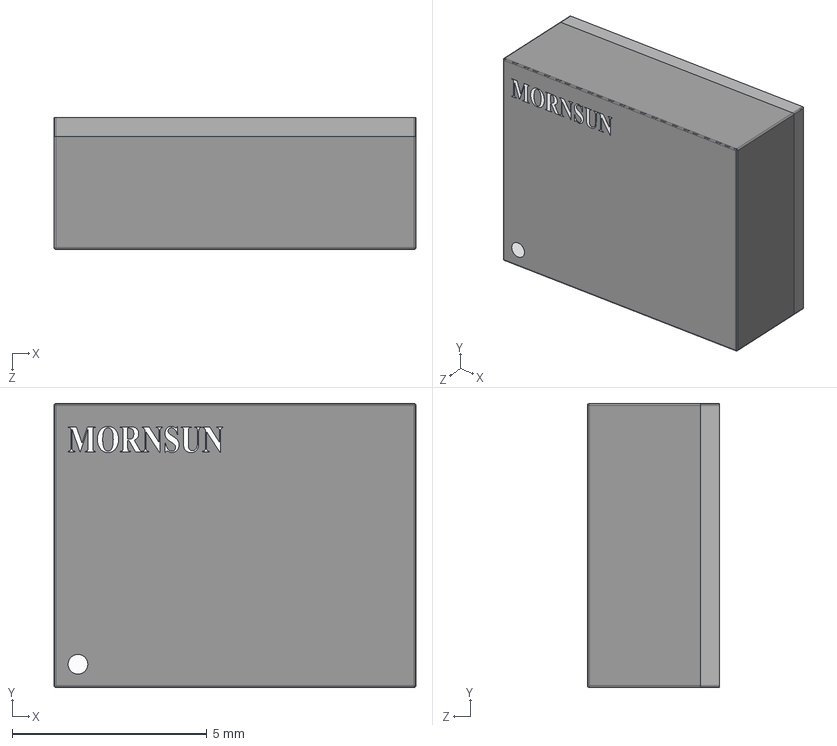
[picture p27: CAD file, 2023-03-29]
3dmodels/vhrd_module_power/B0505MT-1WR4.STEP
9.30 x 7.30 x 3.40 mm
base^IC_MORNSUN_B0505MT-1WR4_eec_Designator3_Copy (3) of PCB1(2)_PCB1
top^IC_MORNSUN_B0505MT-1WR4_eec_Designator3_Copy (3) of PCB1(2)_PCB1
terminal^IC_MORNSUN_B0505MT-1WR4_eec_Designator3_Copy (3) of PCB1(2)_PCB1
logo^IC_MORNSUN_B0505MT-1WR4_eec_Designator3_Copy (3) of PCB1(2)_PCB1
