vhrdtech/kicad-library/3dmodels/vhrd_opto_isolator/SON_1-1-F3-AX_REN.step

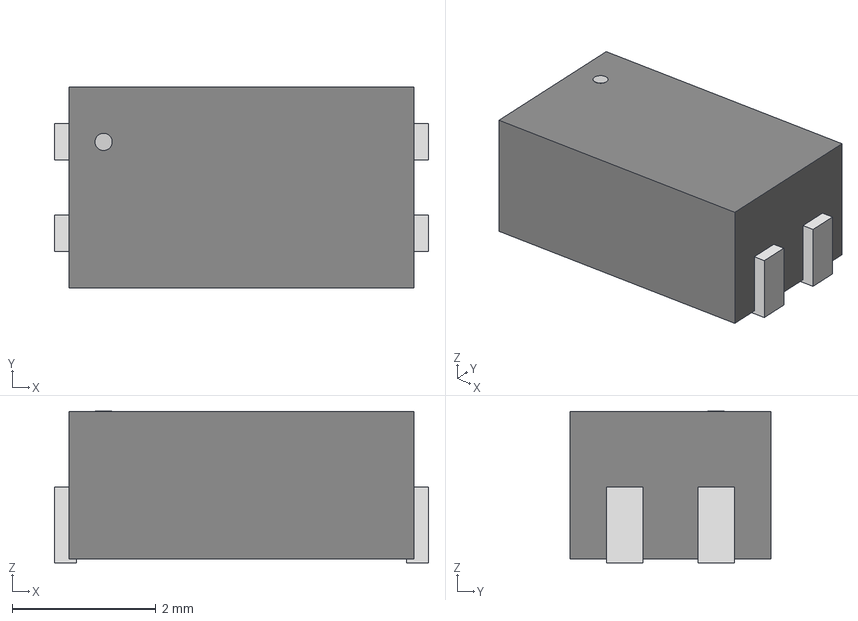
[picture p28: CAD file, 2023-04-13]
3dmodels/vhrd_opto_isolator/SON_1-1-F3-AX_REN.step
5.21 x 2.79 x 2.11 mm
