vhrdtech/kicad-library/3dmodels/vhrd_package_generic/DFN-12-3x3-0.5.step

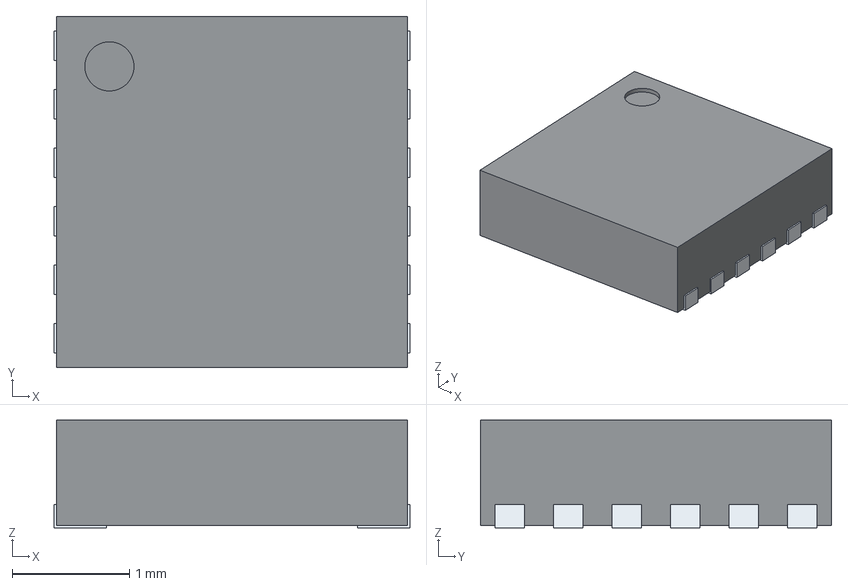
[picture p29: CAD file, 2025-11-09]
3dmodels/vhrd_package_generic/DFN-12-3x3-0.5.step
3.04 x 3.00 x 0.92 mm
