vhrdtech/kicad-library/3dmodels/vhrd_passive_diode/PowerDI-5.STEP

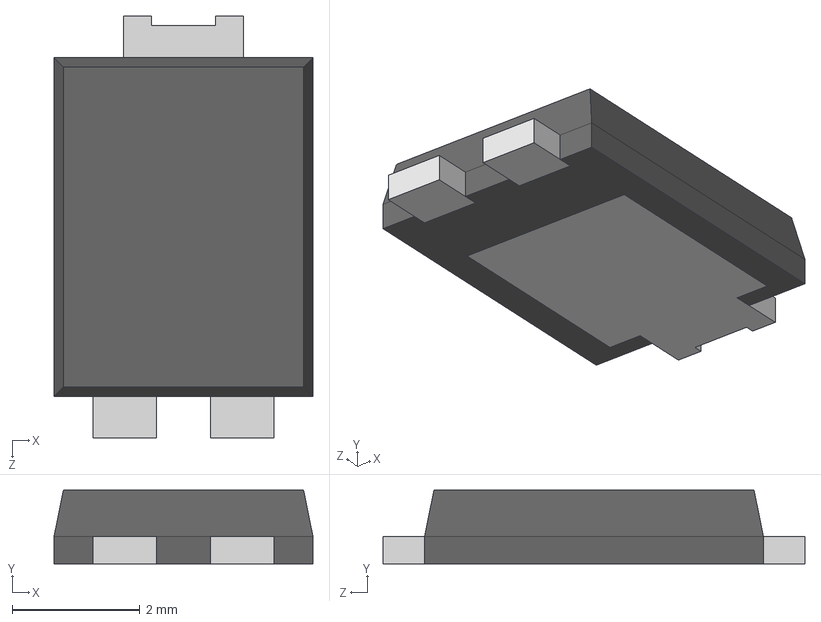
[picture p30: CAD file, 2023-10-11]
3dmodels/vhrd_passive_diode/PowerDI-5.STEP
4.05 x 1.15 x 6.60 mm
