vhrdtech/kicad-library/3dmodels/vhrd_passive_tvs/SC-74.step

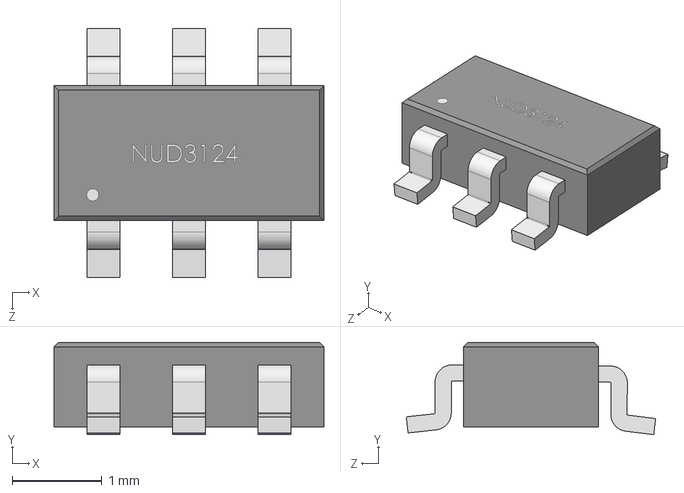
[picture p31: CAD file, 2025-11-09]
3dmodels/vhrd_passive_tvs/SC-74.step
3.00 x 1.03 x 2.77 mm
