vhrdtech/kicad-library/3dmodels/vhrd_relay/CPC1966B_IXYS.step

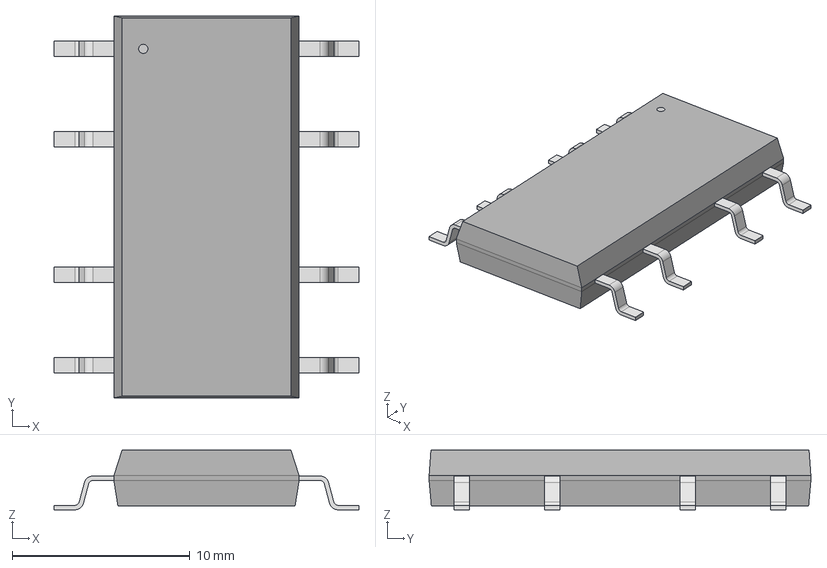
[picture p32: CAD file, 2023-11-05]
3dmodels/vhrd_relay/CPC1966B_IXYS.step
17.1 x 21.5 x 3.35 mm
