vhrdtech/kicad-library/3dmodels/connectors/battery/3013.step

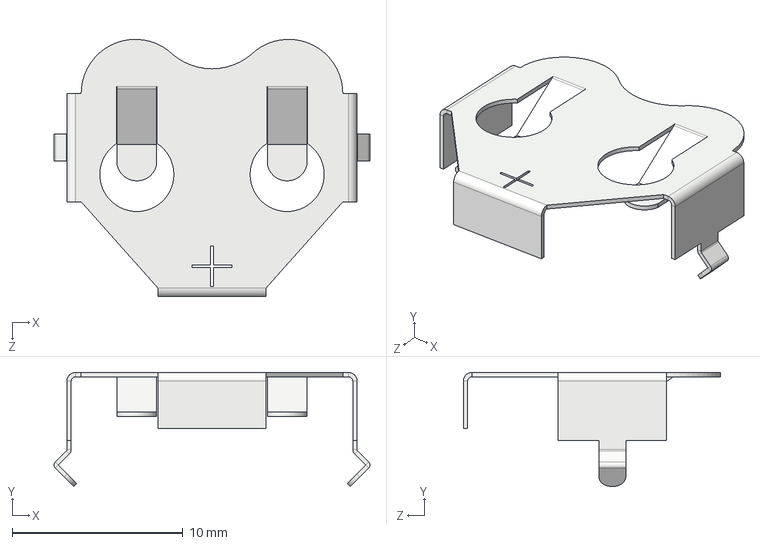
[picture p33: CAD file, 2024-12-04]
3dmodels/connectors/battery/3013.step
18.5 x 6.69 x 15.1 mm
