vhrdtech/kicad-library/3dmodels/connectors/gct/MEM2061-01-188-00-A_REVA.step

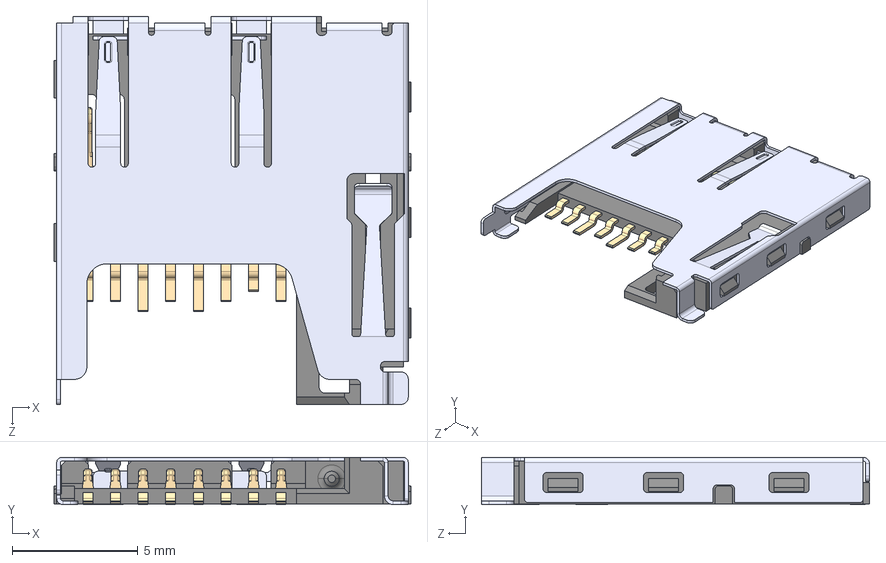
[picture p34: CAD file, 2023-04-18]
3dmodels/connectors/gct/MEM2061-01-188-00-A_REVA.step
14.2 x 1.88 x 15.4 mm
