vhrdtech/kicad-library/3dmodels/connectors/hirose/TF31-16S-0.5SH.stp

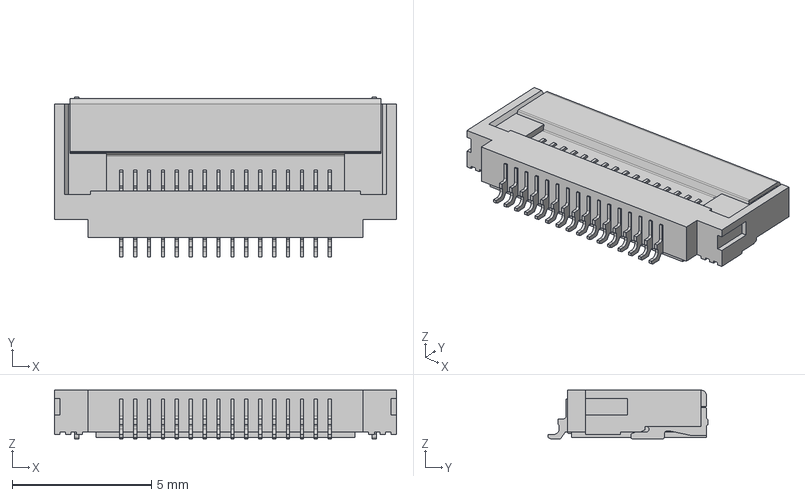
[picture p35: CAD file, 2023-11-30]
3dmodels/connectors/hirose/TF31-16S-0.5SH.stp
12.3 x 5.75 x 1.75 mm
