vhrdtech/kicad-library/3dmodels/connectors/te/c-2337019-1-a2-3d.stp

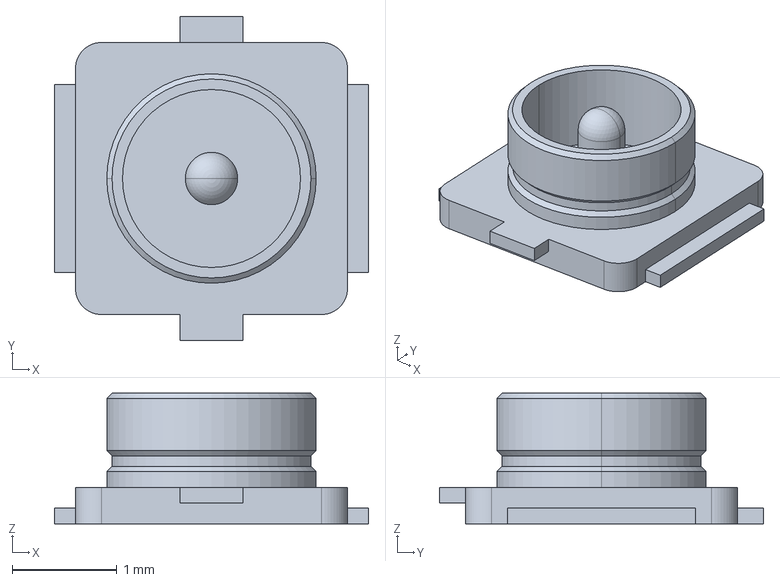
[picture p36: CAD file, 2024-12-04]
3dmodels/connectors/te/c-2337019-1-a2-3d.stp
3.00 x 3.10 x 1.25 mm
