vhrdtech/kicad-library/3dmodels/crystal/ECX-.327-CDX-1293.STEP

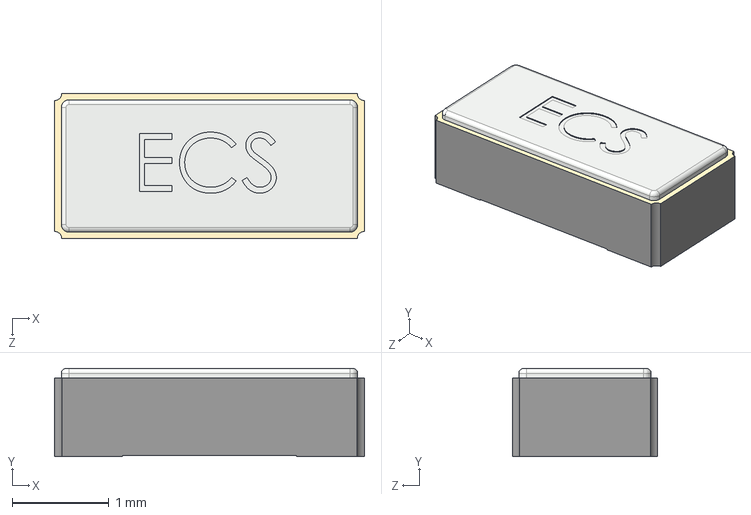
[picture p37: CAD file, 2023-03-29]
3dmodels/crystal/ECX-.327-CDX-1293.STEP
3.20 x 0.91 x 1.50 mm
