vhrdtech/kicad-library/3dmodels/electromechanical/button/CS1102V3.85F100.stp

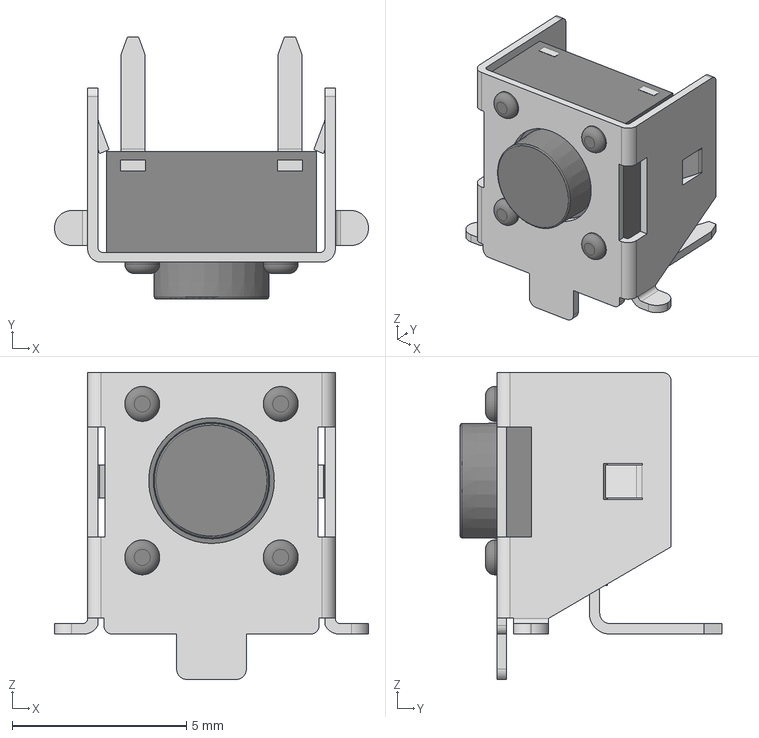
[picture p38: CAD file, 2025-11-09]
3dmodels/electromechanical/button/CS1102V3.85F100.stp
9.00 x 7.50 x 8.80 mm
