vhrdtech/kicad-library/3dmodels/electromechanical/mill-max-0986-0-15-20-76-14-11-0.STEP

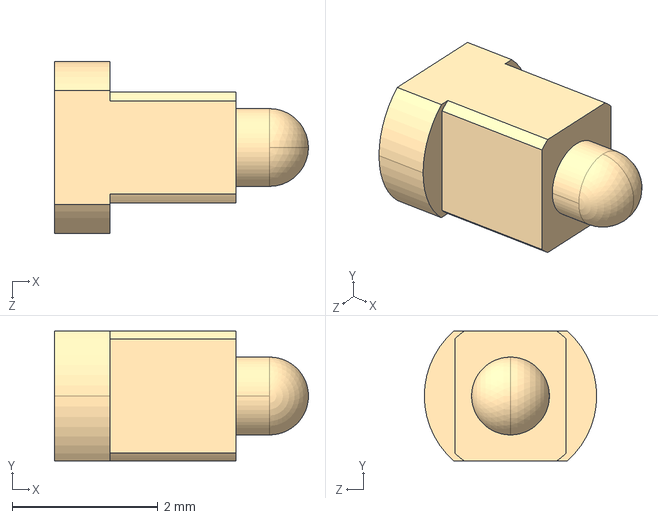
[picture p39: CAD file, 2025-11-09]
3dmodels/electromechanical/mill-max-0986-0-15-20-76-14-11-0.STEP
3.48 x 1.78 x 2.36 mm
