vhrdtech/kicad-library/3dmodels/ic/Diodes QFN2020-12.step

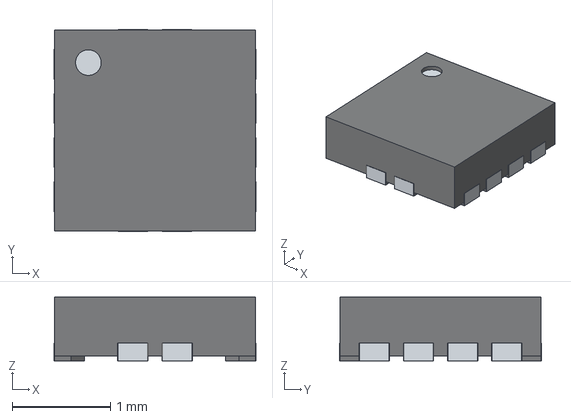
[picture p40: CAD file, 2026-08-12]
3dmodels/ic/Diodes QFN2020-12.step
2.06 x 2.06 x 0.65 mm
