vhrdtech/kicad-library/3dmodels/inductors/L_COUPLED_3225.STEP

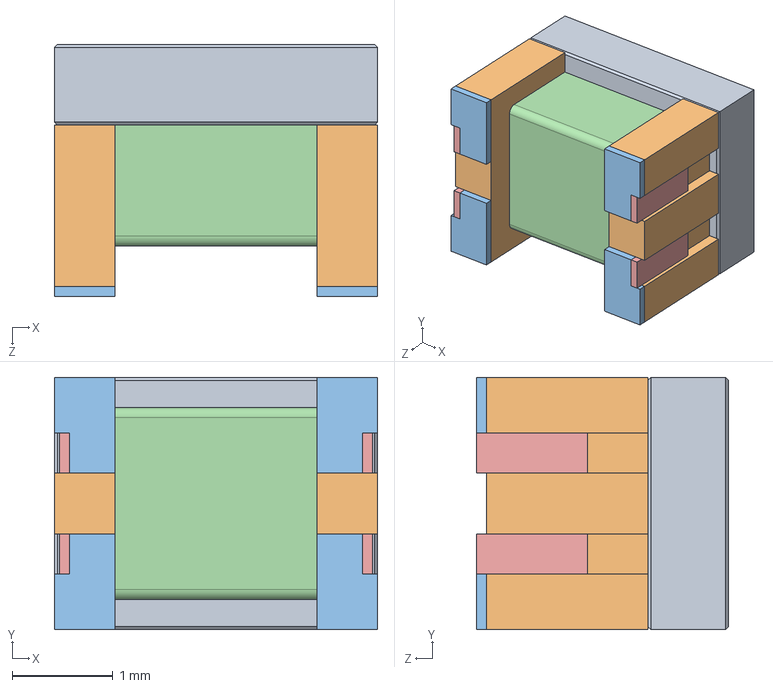
[picture p41: CAD file, 2023-08-31]
3dmodels/inductors/L_COUPLED_3225.STEP
3.20 x 2.50 x 2.50 mm
