vhrdtech/kicad-library/3dmodels/led/B38G3RGB-10D0003H2U1930.step

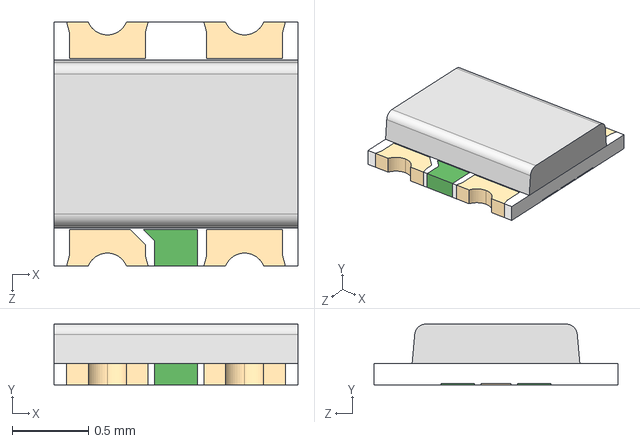
[picture p42: CAD file, 2024-12-04]
3dmodels/led/B38G3RGB-10D0003H2U1930.step
1.60 x 0.4 x 1.60 mm
