vhrdtech/kicad-library/3dmodels/mech/Rod 0.8x7.1.step

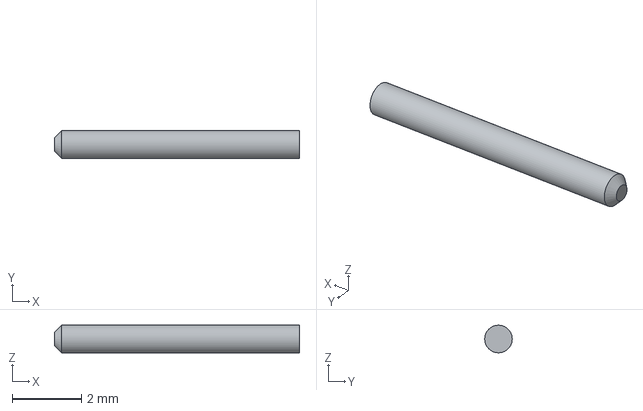
[picture p43: CAD file, 2026-07-24]
3dmodels/mech/Rod 0.8x7.1.step
7.10 x 0.799 x 0.8 mm
