vhrdtech/kicad-library/3dmodels/modules/power/B05xxMT-1WR4.STEP

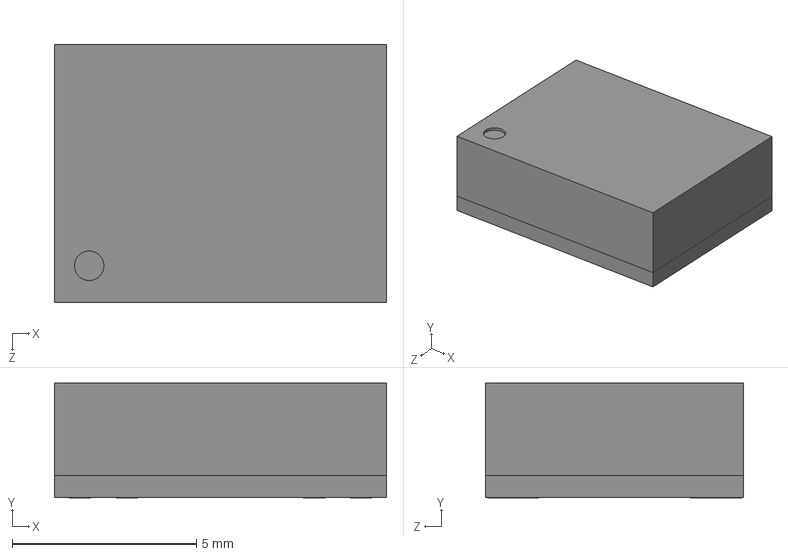
[picture p44: CAD file, 2023-03-22]
3dmodels/modules/power/B05xxMT-1WR4.STEP
9.00 x 3.11 x 7.00 mm
EXTRUDED-21930.stp
PRT0002.stp
USER_LIBRARY-0603_SMD_CAPACITOR.stp
PRT0003.stp
PRT0001.stp
0-1.stp x 8
