vhrdtech/kicad-library/3dmodels/sot/SOT-723-3.step

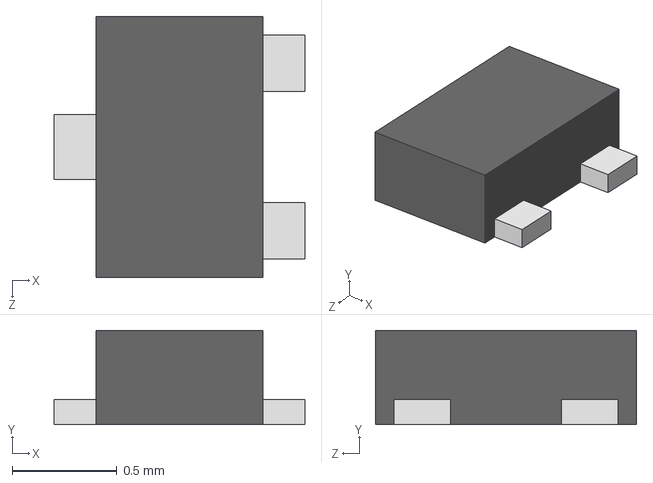
[picture p45: CAD file, 2026-04-30]
3dmodels/sot/SOT-723-3.step
1.20 x 0.45 x 1.25 mm
