vhrdtech/kicad-library/3dmodels/switches/CL-SB-12B-01T.STEP

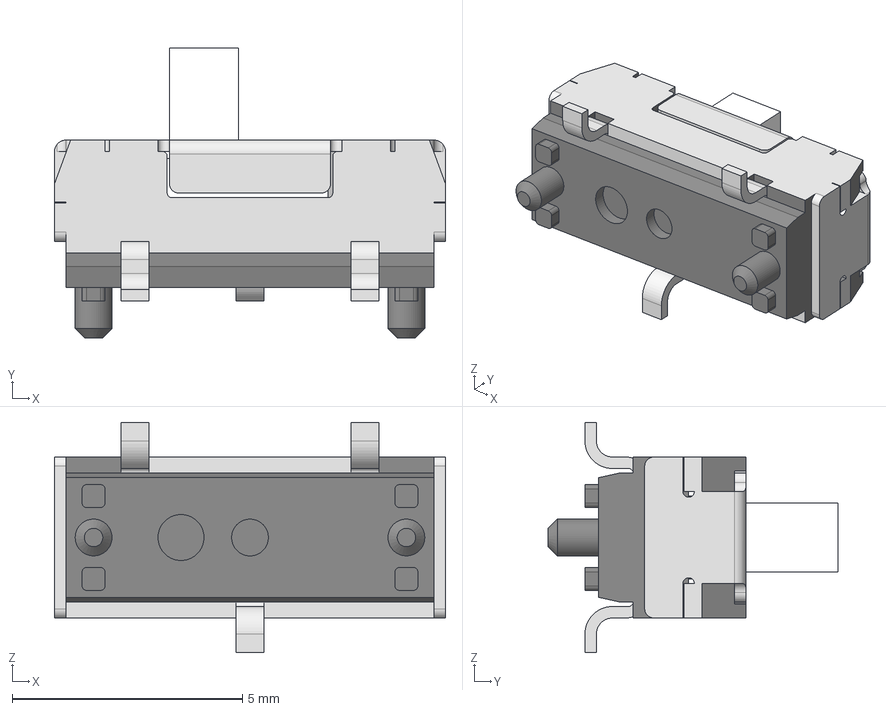
[picture p46: CAD file, 2024-07-14]
3dmodels/switches/CL-SB-12B-01T.STEP
8.50 x 6.30 x 5.00 mm
12B-01_c
2Top setting_s
