vhrdtech/kicad-library/3dmodels/ti/DDF0008A.stp

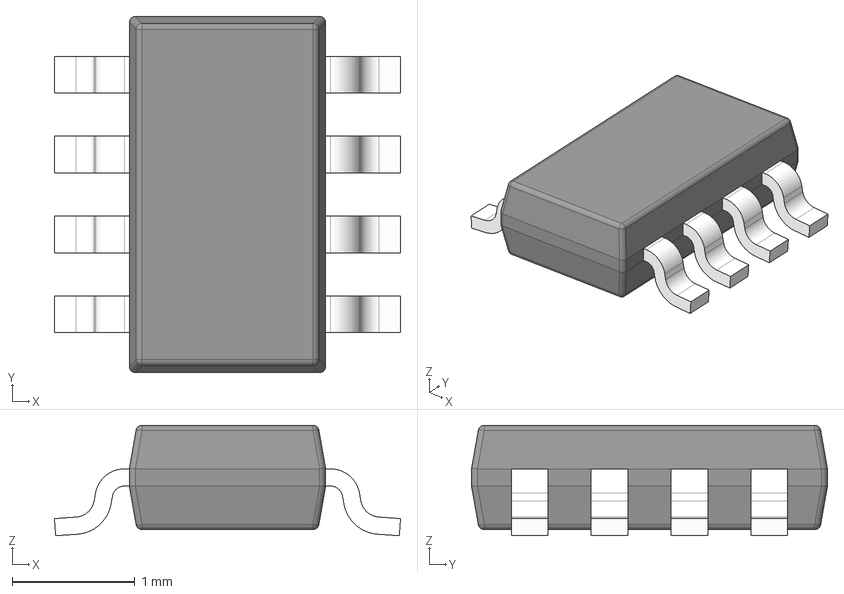
[picture p47: CAD file, 2023-11-30]
3dmodels/ti/DDF0008A.stp
2.82 x 2.90 x 0.9 mm
BODY-SO
LEAD-SO x 8
PIN1-ID
