vhrdtech/kicad-library/3dmodels/vhrd_package_generic/DFN-10-3x3-0.5.STEP

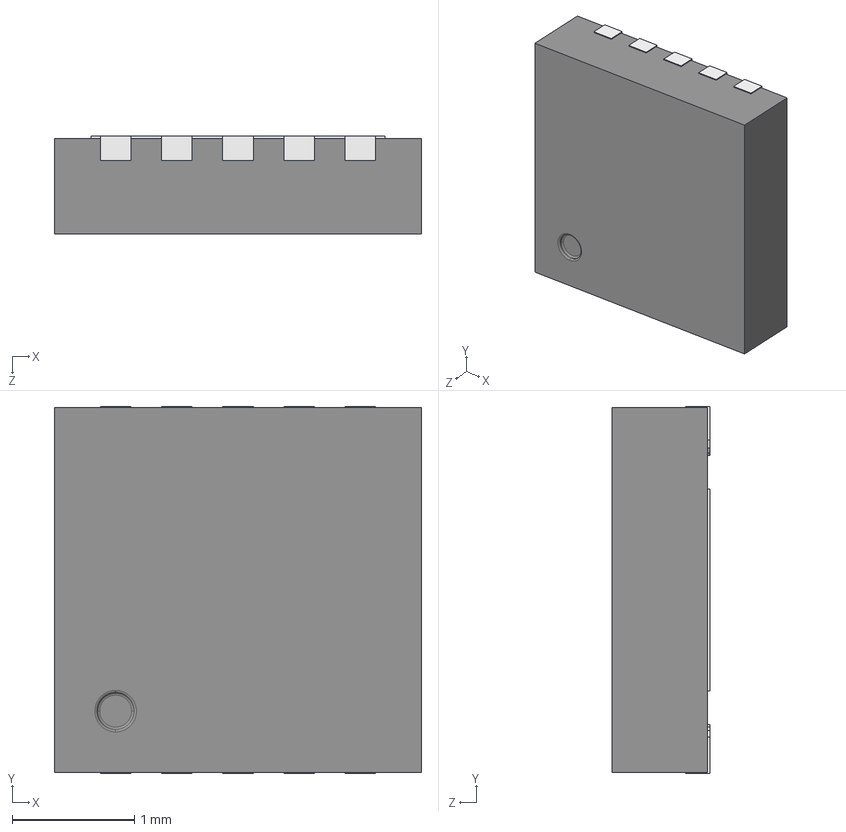
[picture p48: CAD file, 2025-11-09]
3dmodels/vhrd_package_generic/DFN-10-3x3-0.5.STEP
3.00 x 3.00 x 0.8 mm
DFN_10011
