vhrdtech/kicad-library/3dmodels/vhrd_passive_diode/DFN1110D-3_(SOT8015).step

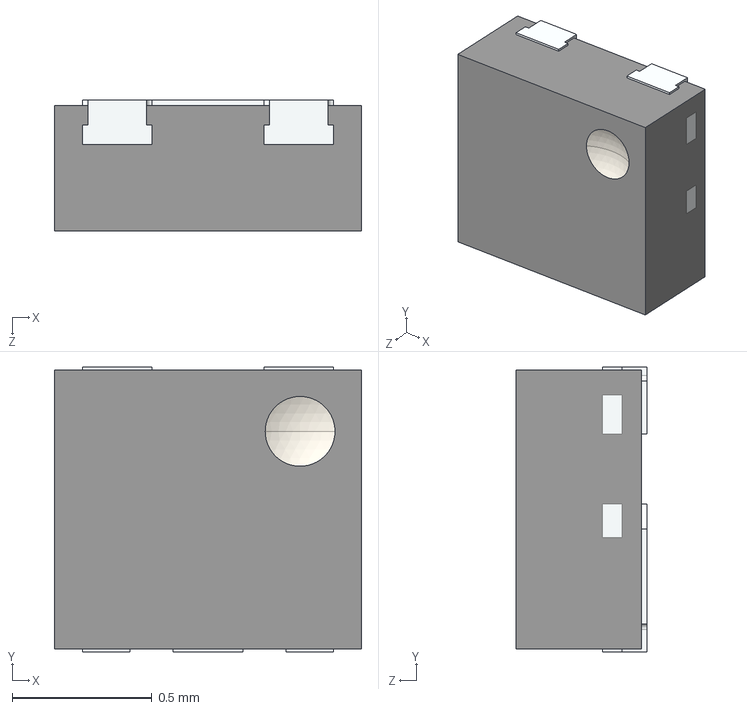
[picture p49: CAD file, 2023-10-09]
3dmodels/vhrd_passive_diode/DFN1110D-3_(SOT8015).step
1.10 x 1.02 x 0.47 mm
