vhrdtech/kicad-library/3dmodels/vhrd_passive_tvs/D5V0P4UR6SO-7.step

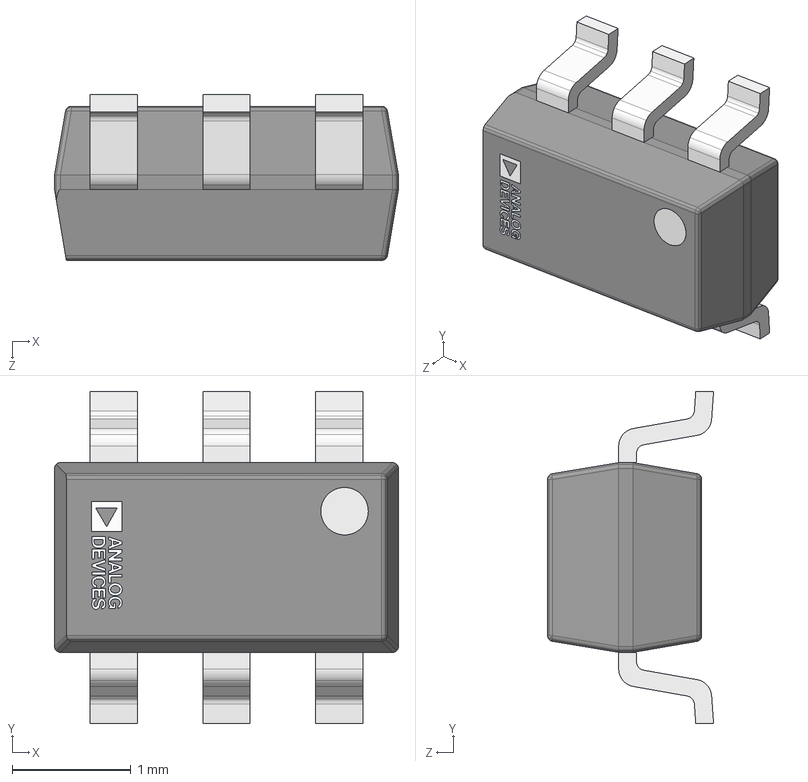
[picture p50: CAD file, 2023-03-29]
3dmodels/vhrd_passive_tvs/D5V0P4UR6SO-7.step
2.90 x 2.80 x 1.40 mm
IC_BODY^Diode_Diodes_Inc_D5V0P4UR6SO-7_eec_Designator5_D5V0P4UR6SO-7(2)_D5V0P4UR6SO-7
IC_LEG^Diode_Diodes_Inc_D5V0P4UR6SO-7_eec_Designator5_D5V0P4UR6SO-7(2)_D5V0P4UR6SO-7 x 3
circle^Diode_Diodes_Inc_D5V0P4UR6SO-7_eec_Designator5_D5V0P4UR6SO-7(2)_D5V0P4UR6SO-7
Analog Devices^Diode_Diodes_Inc_D5V0P4UR6SO-7_eec_Designator5_D5V0P4UR6SO-7(2)_D5V0P4UR6SO-7
IC_LEG_MIR2^Diode_Diodes_Inc_D5V0P4UR6SO-7_eec_Designator5_D5V0P4UR6SO-7(2)_D5V0P4UR6SO-7 x 3
