vhrdtech/kicad-library/3dmodels/vhrd_relay/EE2-4.5TNUH-L.step

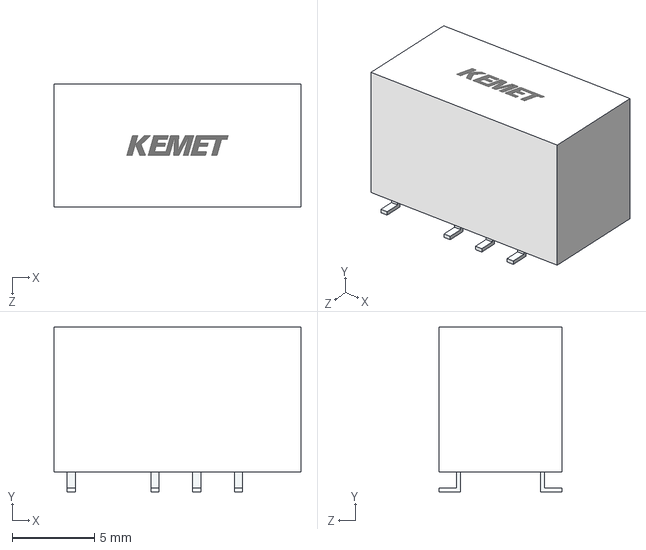
[picture p51: CAD file, 2023-04-16]
3dmodels/vhrd_relay/EE2-4.5TNUH-L.step
15.0 x 10.0 x 7.50 mm
