vhrdtech/kicad-library/3dmodels/vhrd_transformer/EP10 - PA1134NL.STEP

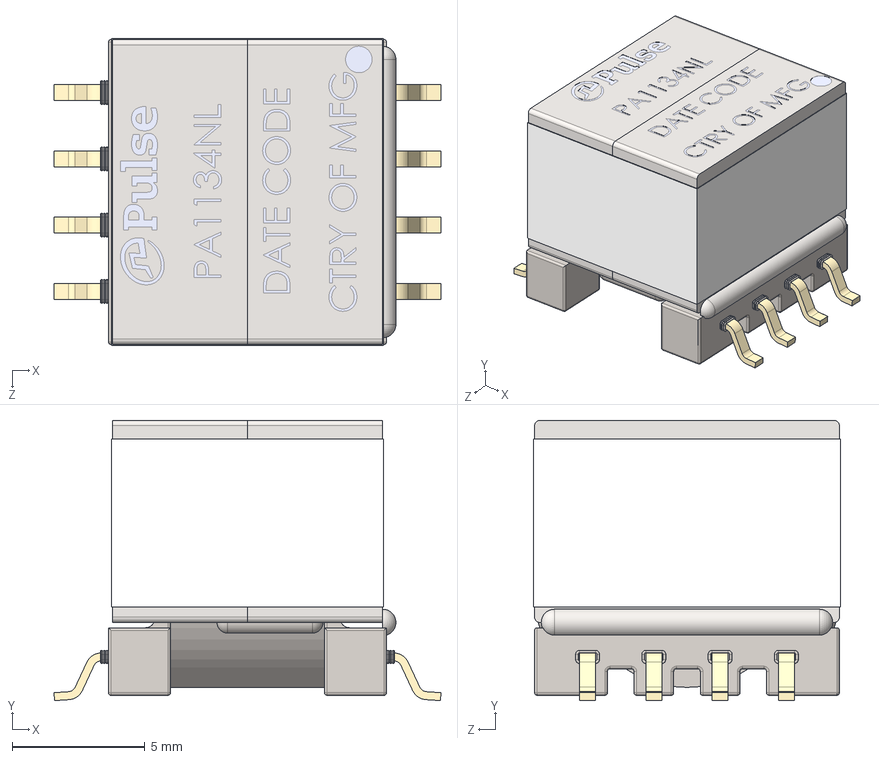
[picture p52: CAD file, 2023-04-13]
3dmodels/vhrd_transformer/EP10 - PA1134NL.STEP
14.6 x 10.6 x 11.6 mm
042-2006.XXX EP10SM 8P^EP10 - PA1134NL.STEP
032-3183.XXX EP10CORE_Part Number^EP10 - PA1134NL.STEP
032-3183.XXX EP10CORE_CTRY AND DATE CODE^EP10 - PA1134NL.STEP
EP10 Bobbin Wire_Wire^EP10 - PA1134NL.STEP
EP10 Core Tape^EP10 - PA1134NL.STEP
EP10 Core to Bobbin Epoxy_Core to Core^EP10 - PA1134NL.STEP
Terminal Wire_30AWG 0.30 X 0.60.STEP x 24
EP10 Core to Bobbin Epoxy_EP10 Core to Core^EP10 - PA1134NL.STEP x 2
