vhrdtech/kicad-library/3dmodels/connectors/amphenol/L77SDE09SA4CH.step

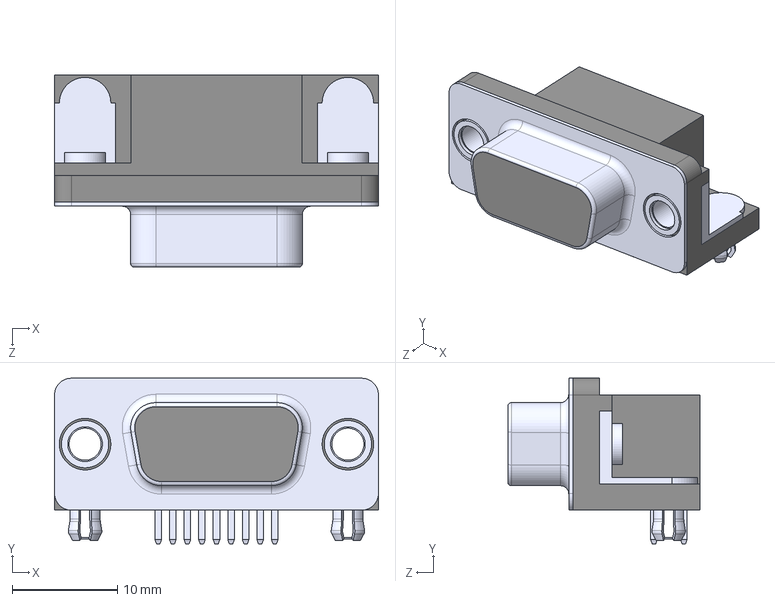
[picture p53: CAD file, 2024-12-04]
3dmodels/connectors/amphenol/L77SDE09SA4CH.step
30.8 x 15.8 x 18.3 mm
