vhrdtech/kicad-library/3dmodels/connectors/battery/BAT-HLD-001-THM.STEP

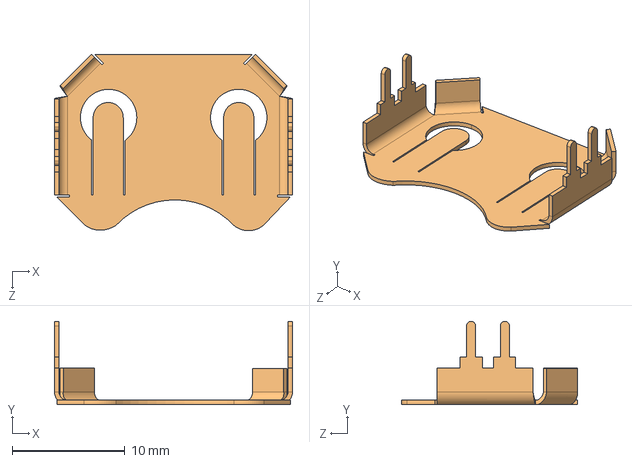
[picture p54: CAD file, 2023-03-29]
3dmodels/connectors/battery/BAT-HLD-001-THM.STEP
21.1 x 7.39 x 15.6 mm
