vhrdtech/kicad-library/3dmodels/connectors/te/1-1775333-6.STEP

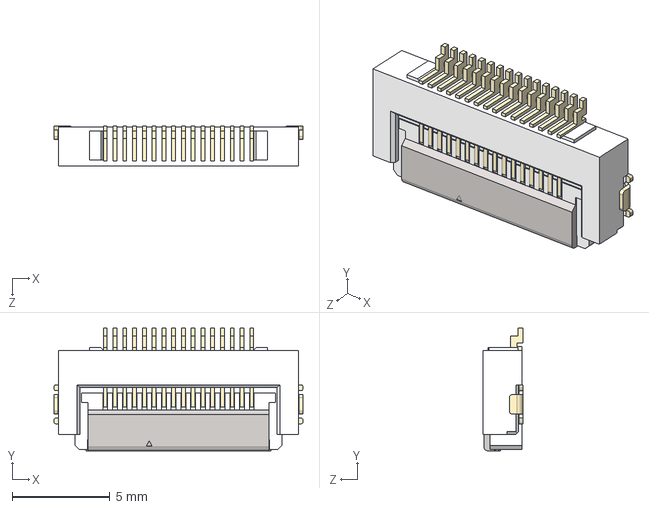
[picture p56: CAD file, 2023-06-01]
3dmodels/connectors/te/1-1775333-6.STEP
12.8 x 6.28 x 2.05 mm
