vhrdtech/kicad-library/3dmodels/electromechanical/button/CS1102V5.85F260.stp

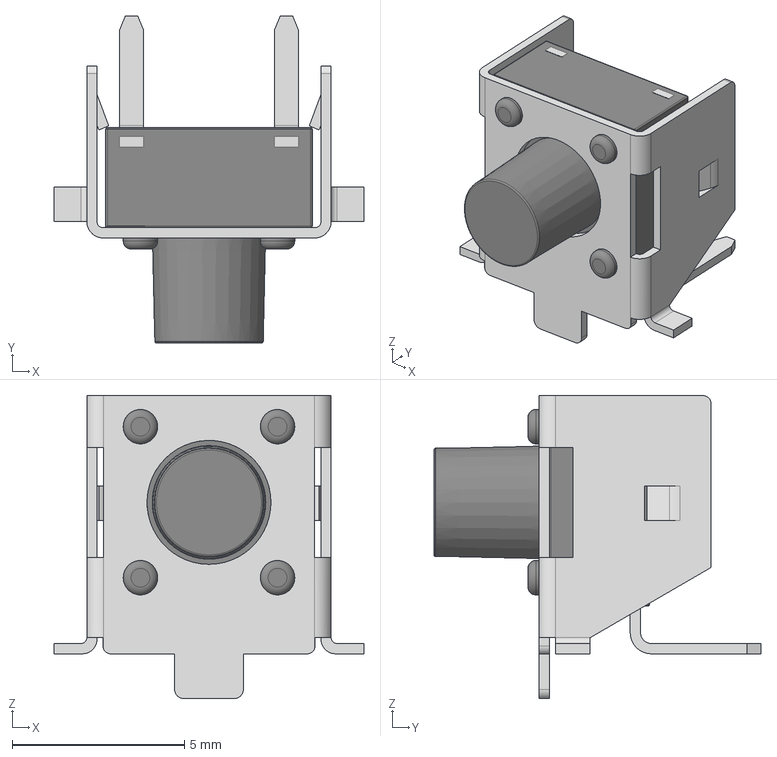
[picture p57: CAD file, 2025-11-09]
3dmodels/electromechanical/button/CS1102V5.85F260.stp
9.00 x 9.50 x 8.81 mm
