vhrdtech/kicad-library/3dmodels/electromechanical/mill-max-0986-1-15-20-75-14-11-0.STEP

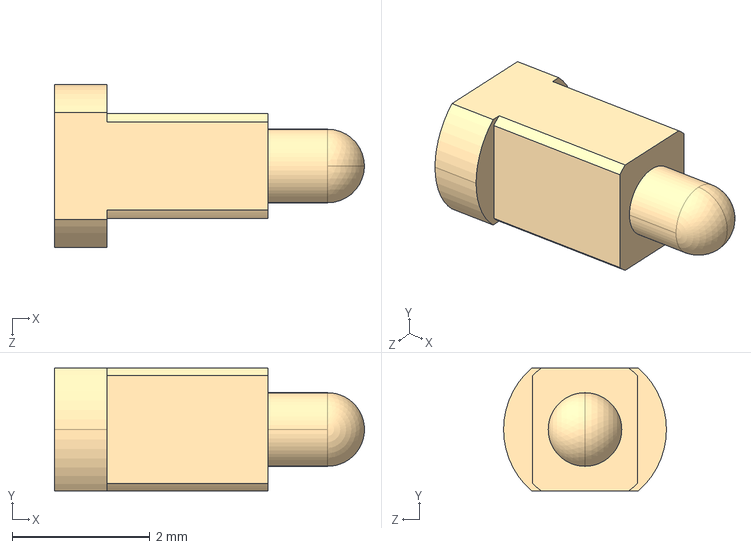
[picture p58: CAD file, 2025-11-09]
3dmodels/electromechanical/mill-max-0986-1-15-20-75-14-11-0.STEP
4.50 x 1.78 x 2.36 mm
