vhrdtech/kicad-library/3dmodels/ic/X2QFN-14.step

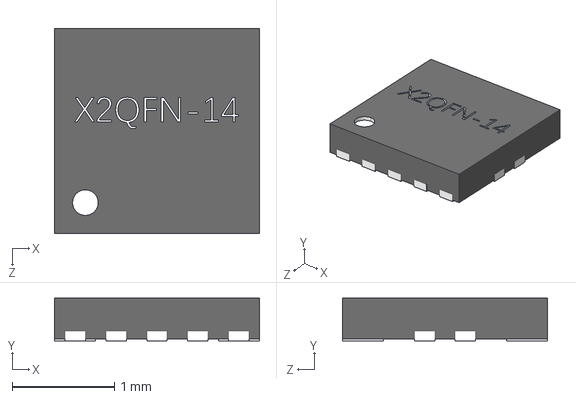
[picture p59: CAD file, 2026-07-15]
3dmodels/ic/X2QFN-14.step
2.00 x 0.42 x 2.00 mm
