vhrdtech/kicad-library/3dmodels/inductors/LMLP07A7.STEP

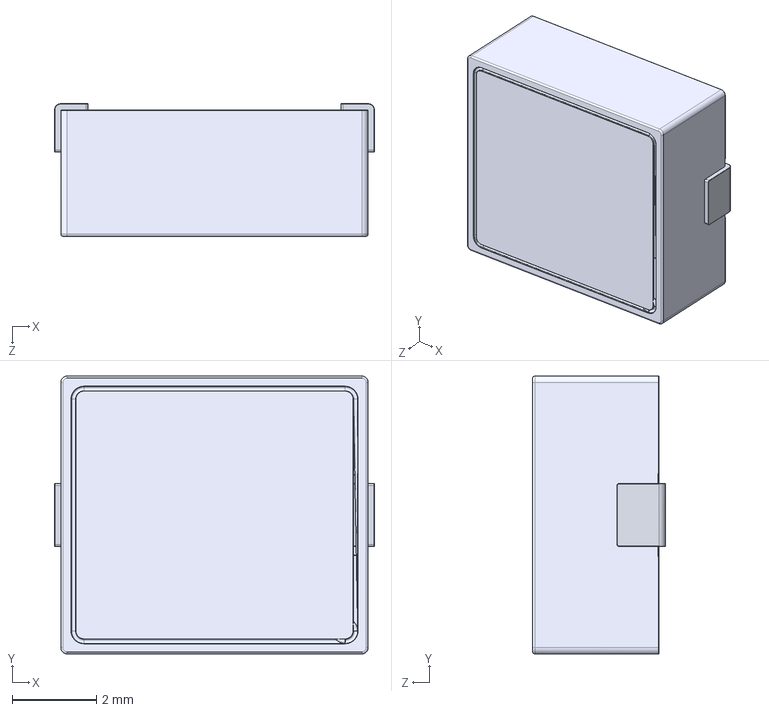
[picture p60: CAD file, 2023-04-21]
3dmodels/inductors/LMLP07A7.STEP
7.60 x 6.60 x 3.15 mm
