vhrdtech/kicad-library/3dmodels/sot/SOT-416.step

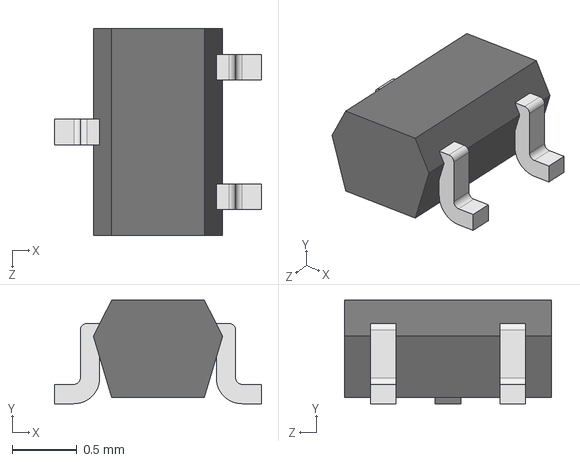
[picture p61: CAD file, 2023-10-09]
3dmodels/sot/SOT-416.step
1.60 x 0.8 x 1.60 mm
