vhrdtech/kicad-library/3dmodels/switches/CHS-01TB.STEP

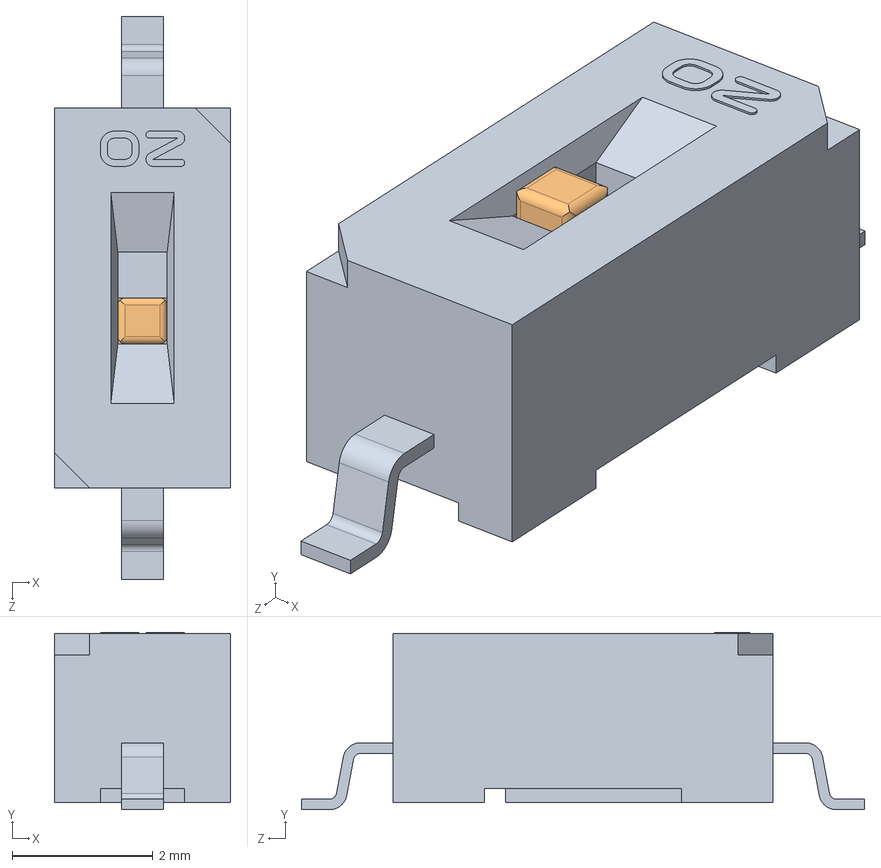
[picture p62: CAD file, 2024-07-14]
3dmodels/switches/CHS-01TB.STEP
2.50 x 2.52 x 8.00 mm
CHS-01-G-body
CHS-slider
