vhrdtech/kicad-library/3dmodels/ti/TSSOP8_PW0008A.stp

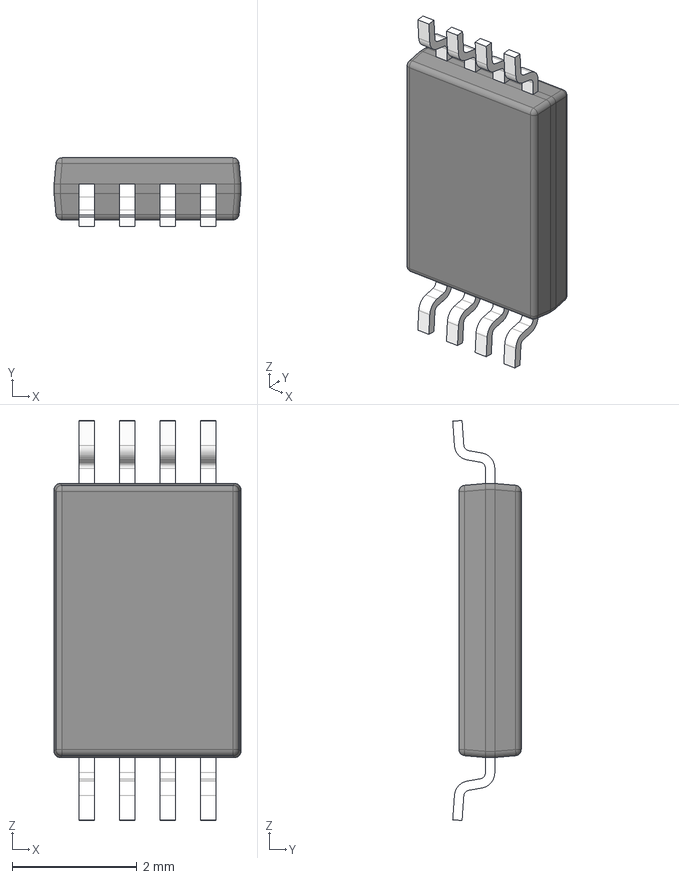
[picture p63: CAD file, 2023-10-09]
3dmodels/ti/TSSOP8_PW0008A.stp
3.00 x 1.10 x 6.42 mm
BODY-SO
LEAD-SO x 8
PIN1-ID
