vhrdtech/kicad-library/3dmodels/vhrd_package_generic/RI-8-1_ADI.step

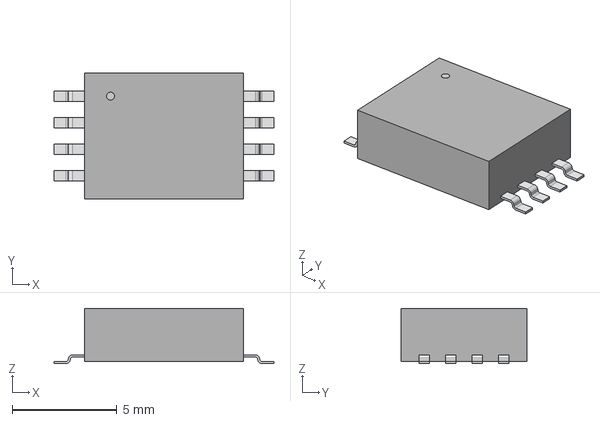
[picture p64: CAD file, 2023-04-17]
3dmodels/vhrd_package_generic/RI-8-1_ADI.step
10.5 x 6.05 x 2.64 mm
