vhrdtech/kicad-library/3dmodels/vhrd_passive_diode/HDS10M-13.step

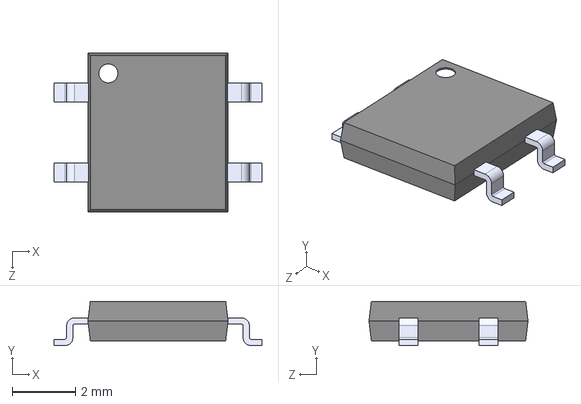
[picture p65: CAD file, 2023-04-13]
3dmodels/vhrd_passive_diode/HDS10M-13.step
6.60 x 1.40 x 5.05 mm
