vhrdtech/kicad-library/3dmodels/connectors/amphenol/L77SDE09S.STEP

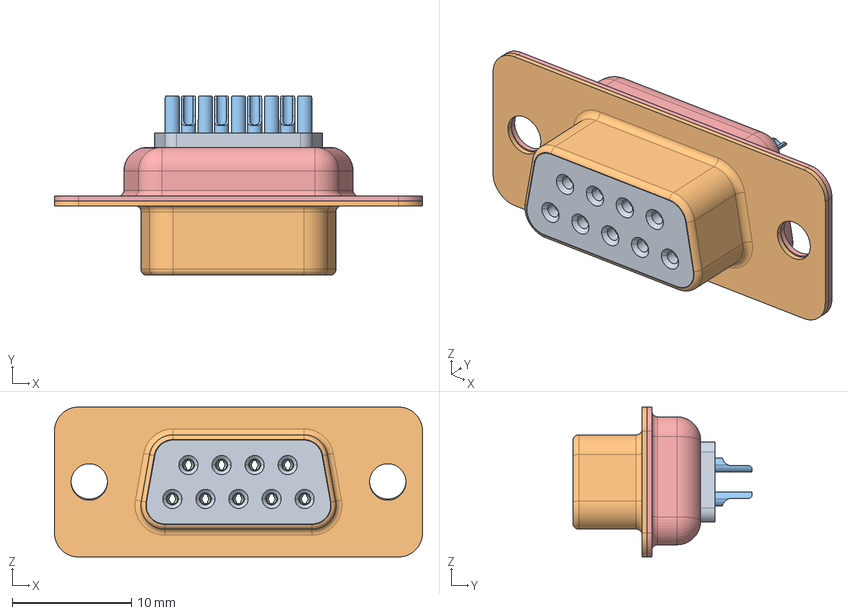
[picture p66: CAD file, 2024-07-14]
3dmodels/connectors/amphenol/L77SDE09S.STEP
30.8 x 15.0 x 12.6 mm
100-09HOUSING
100-09FEMALE-FRONTSHELL
104-FEMALE-TERMINAL-SHORT x 9
100-09FEMALE-BACKSHELL5555
