vhrdtech/kicad-library/3dmodels/connectors/hirose/TF31-8S-0.5SH.stp

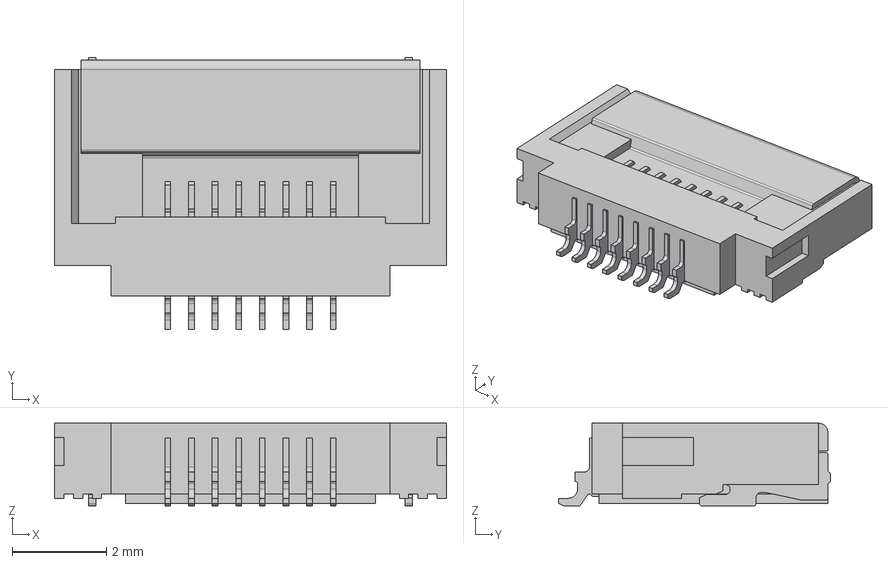
[picture p67: CAD file, 2023-11-30]
3dmodels/connectors/hirose/TF31-8S-0.5SH.stp
8.30 x 5.75 x 1.75 mm
