vhrdtech/kicad-library/3dmodels/electromechanical/button/KSS331.STEP

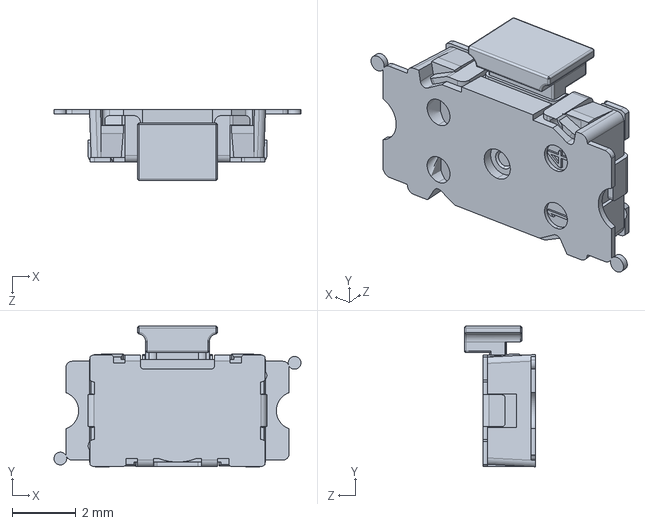
[picture p68: CAD file, 2023-04-18]
3dmodels/electromechanical/button/KSS331.STEP
7.74 x 4.41 x 2.23 mm
