vhrdtech/kicad-library/3dmodels/ic/SOT-762-1 (DHVQFN14).step

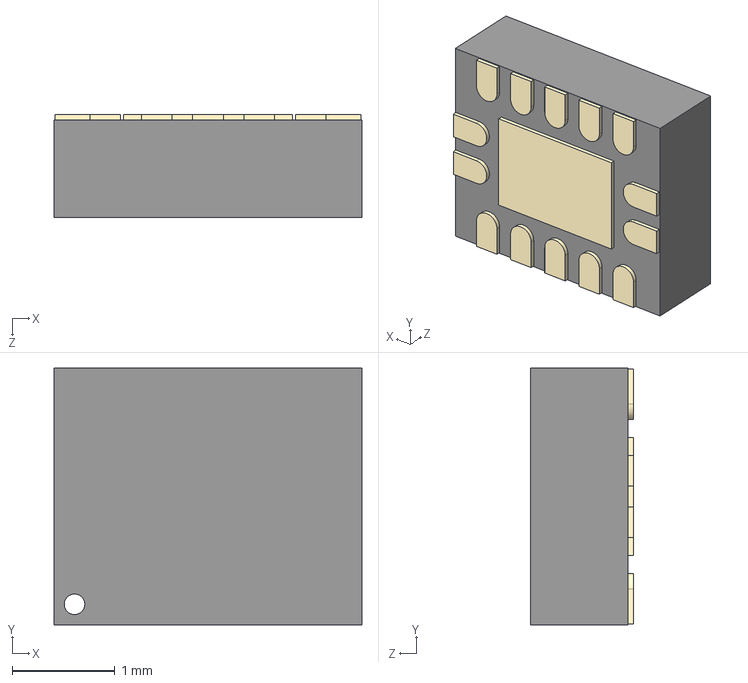
[picture p69: CAD file, 2026-07-15]
3dmodels/ic/SOT-762-1 (DHVQFN14).step
3.00 x 2.50 x 1.00 mm
