vhrdtech/kicad-library/3dmodels/mech/M1.2x6.step

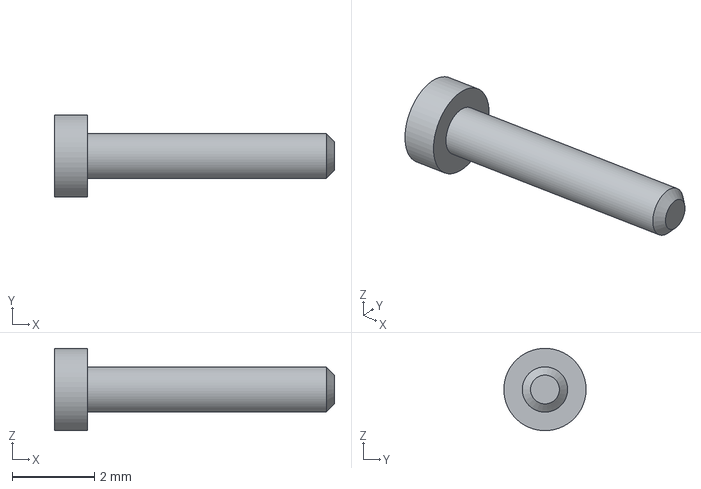
[picture p70: CAD file, 2026-07-24]
3dmodels/mech/M1.2x6.step
6.80 x 2.00 x 2.00 mm
