vhrdtech/kicad-library/3dmodels/switches/CL-SB-22B-01T.STEP

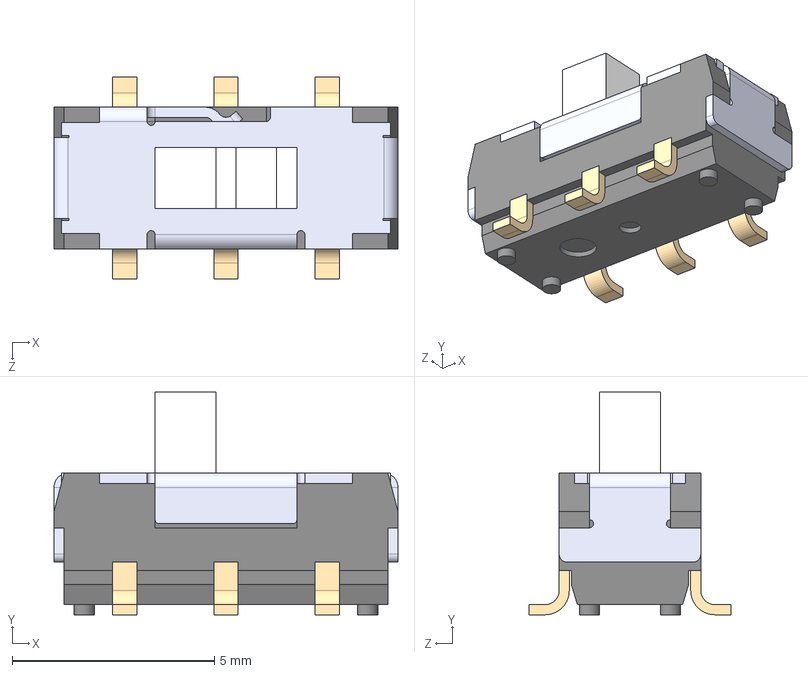
[picture p71: CAD file, 2024-07-14]
3dmodels/switches/CL-SB-22B-01T.STEP
8.50 x 5.50 x 5.00 mm
