vhrdtech/kicad-library/3dmodels/ti/RSW0010A.stp

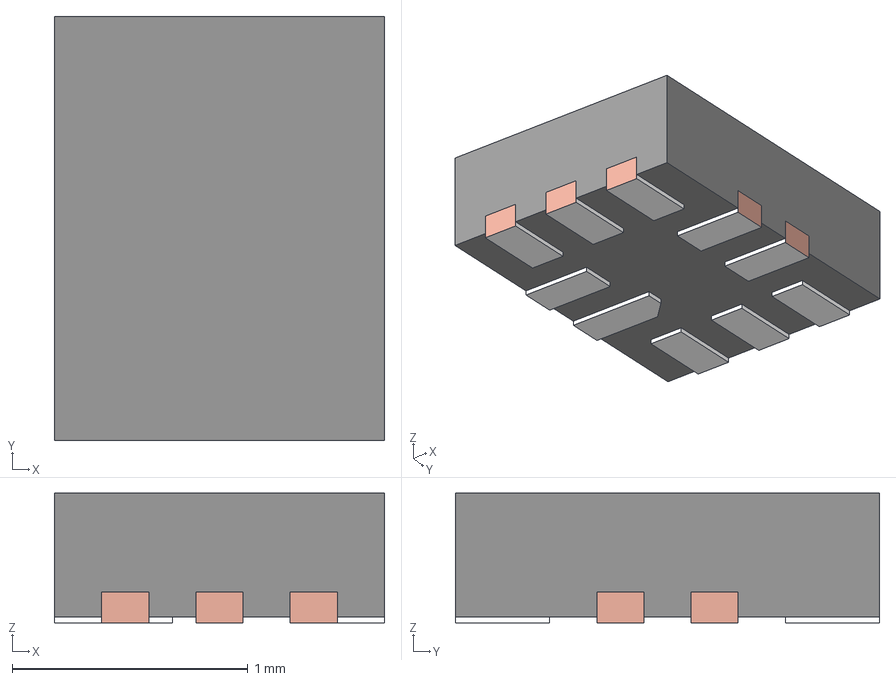
[picture p72: CAD file, 2023-10-09]
3dmodels/ti/RSW0010A.stp
1.40 x 1.80 x 0.55 mm
FRAME
