vhrdtech/kicad-library/3dmodels/vhrd_package_generic/SO8L_TOS.step

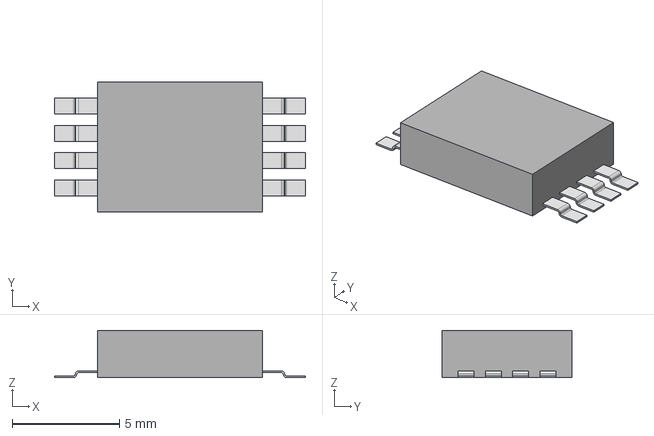
[picture p73: CAD file, 2023-04-16]
3dmodels/vhrd_package_generic/SO8L_TOS.step
11.7 x 6.05 x 2.21 mm
