vhrdtech/kicad-library/3dmodels/connectors/amphenol/sD09P33E4GL00LF.stp

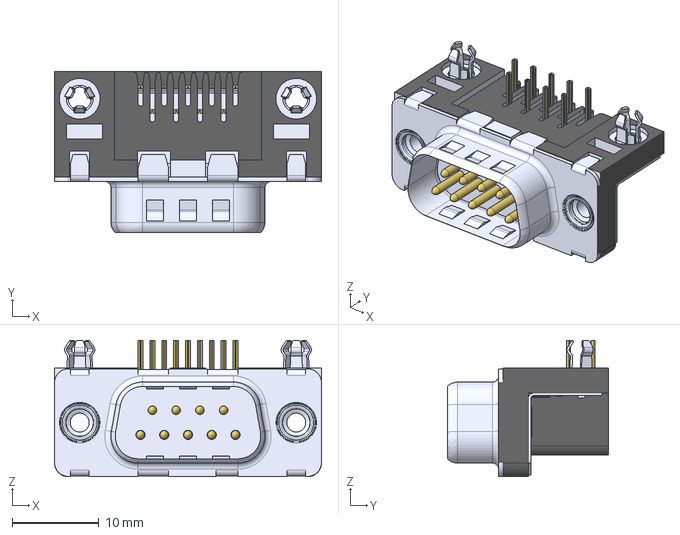
[picture p74: CAD file, 2023-10-11]
3dmodels/connectors/amphenol/sD09P33E4GL00LF.stp
30.8 x 18.6 x 15.8 mm
