vhrdtech/kicad-library/3dmodels/connectors/hirose/BM50U-4DP.stp

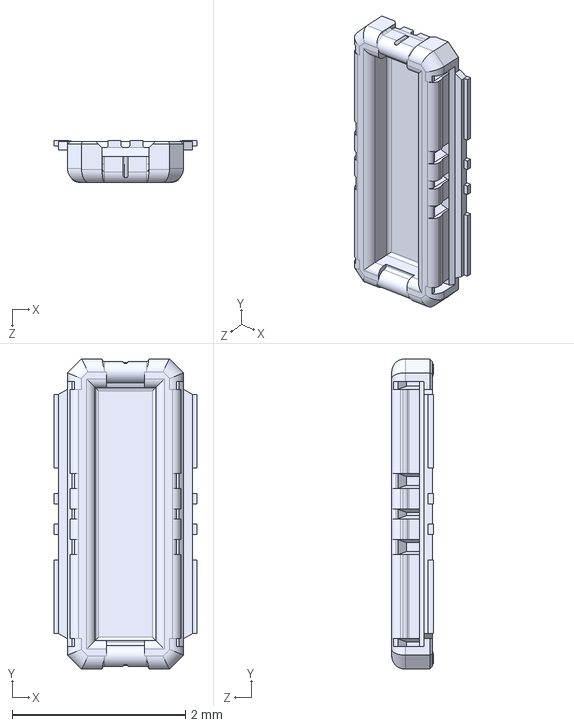
[picture p75: CAD file, 2023-11-05]
3dmodels/connectors/hirose/BM50U-4DP.stp
1.65 x 3.58 x 0.48 mm
