vhrdtech/kicad-library/3dmodels/ic/QFN80_10x10_RP2354B.step

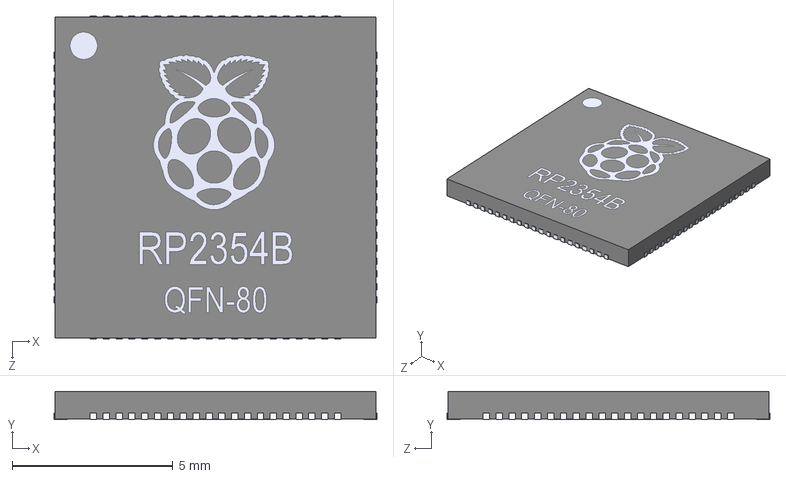
[picture p76: CAD file, 2026-07-15]
3dmodels/ic/QFN80_10x10_RP2354B.step
10.1 x 0.875 x 10.1 mm
