vhrdtech/kicad-library/3dmodels/mech/M1.2x7.step

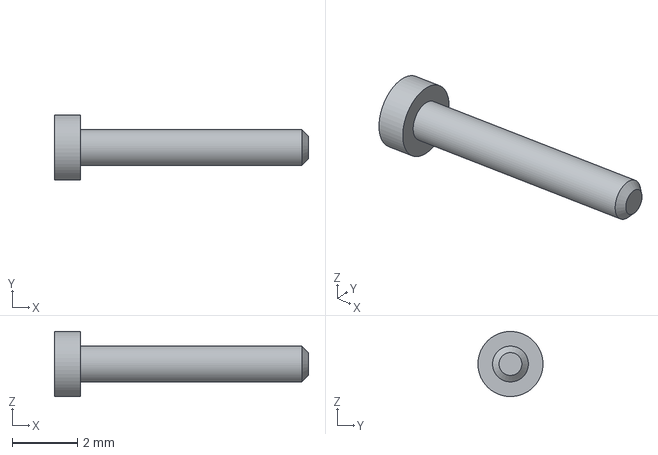
[picture p77: CAD file, 2026-07-24]
3dmodels/mech/M1.2x7.step
7.80 x 2.00 x 2.00 mm
