vhrdtech/kicad-library/3dmodels/switches/KAE01SGGT.STEP

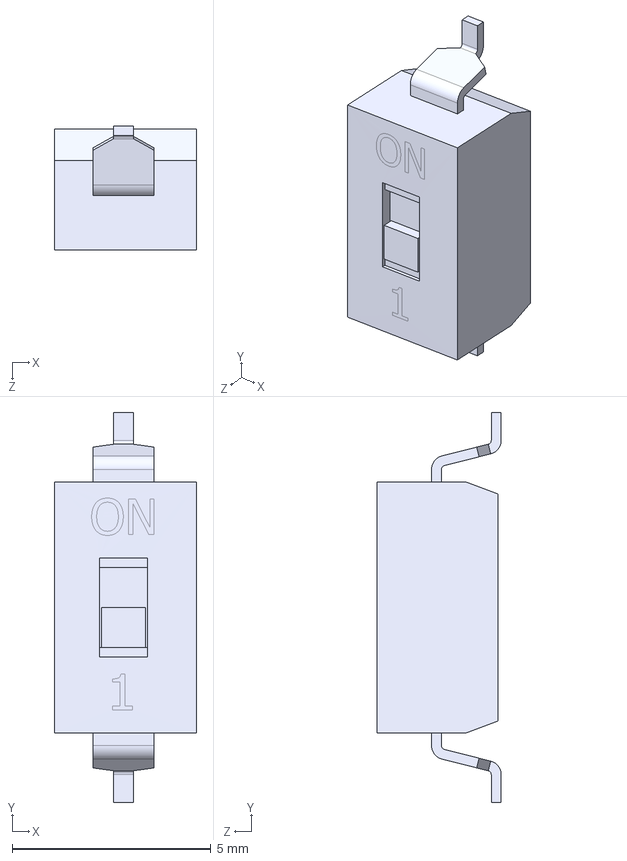
[picture p78: CAD file, 2024-04-27]
3dmodels/switches/KAE01SGGT.STEP
3.58 x 9.80 x 3.13 mm
