vhrdtech/kicad-library/3dmodels/connectors/hirose/BM50U-4DS.stp

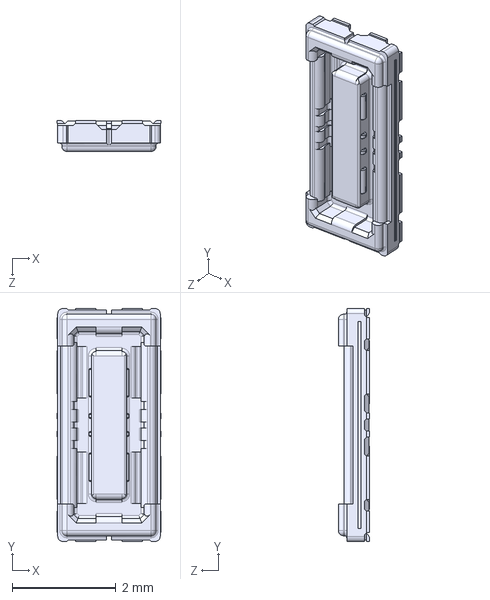
[picture p79: CAD file, 2023-11-05]
3dmodels/connectors/hirose/BM50U-4DS.stp
2.00 x 4.50 x 0.6 mm
