vhrdtech/kicad-library/3dmodels/ic/BQB0016A.stp

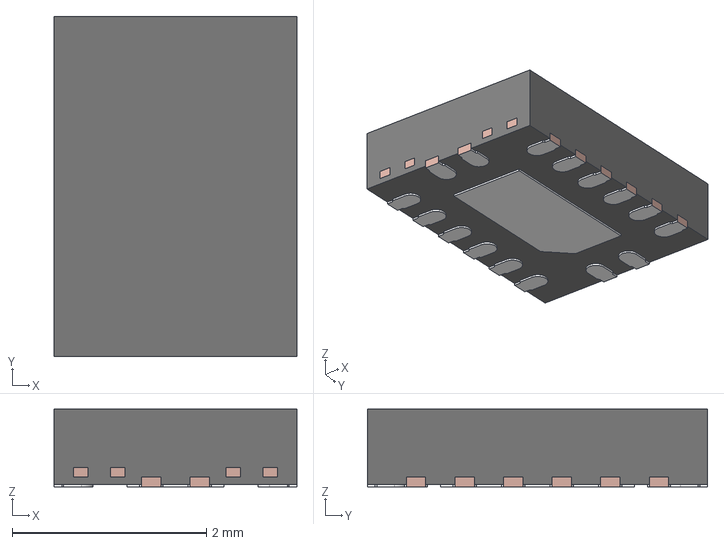
[picture p80: CAD file, 2026-01-28]
3dmodels/ic/BQB0016A.stp
2.50 x 3.50 x 0.8 mm
BQB0016A_FRAME
BQB0016A_MOLD
