vhrdtech/kicad-library/3dmodels/ic/RHL0024A.STEP

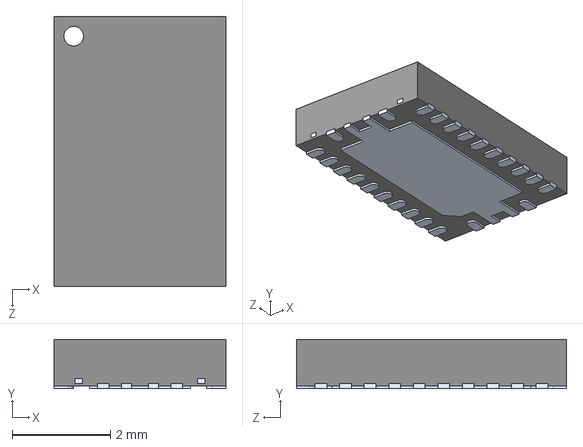
[picture p81: CAD file, 2026-01-28]
3dmodels/ic/RHL0024A.STEP
3.50 x 1.00 x 5.50 mm
