vhrdtech/kicad-library/3dmodels/ic/UQFN20.step

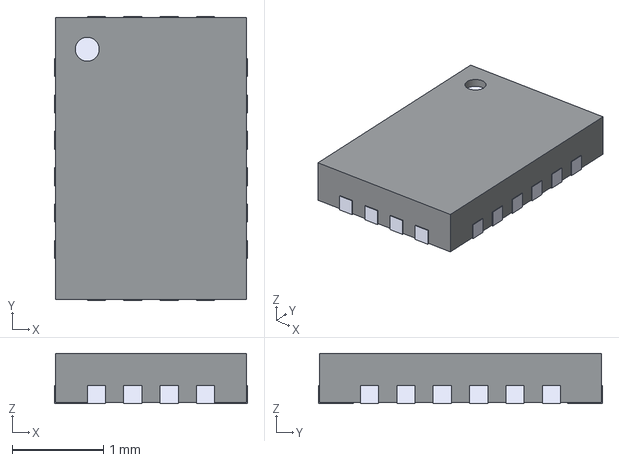
[picture p82: CAD file, 2025-11-09]
3dmodels/ic/UQFN20.step
2.12 x 3.12 x 0.55 mm
