vhrdtech/kicad-library/3dmodels/ic/SQFN_48.step

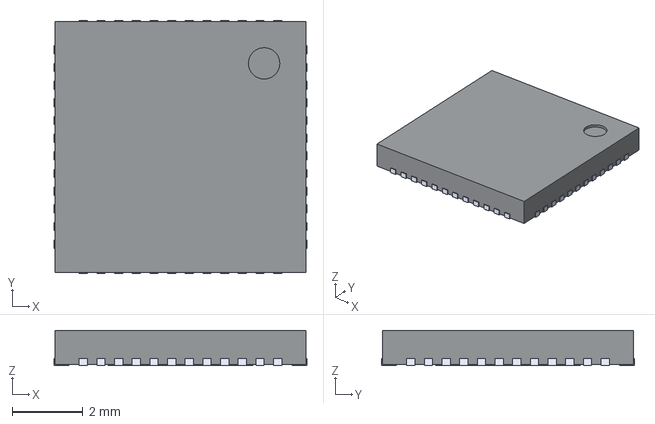
[picture p83: CAD file, 2025-11-09]
3dmodels/ic/SQFN_48.step
7.16 x 7.16 x 1.00 mm
