vhrdtech/kicad-library/(list of files, cad)

Other CAD files:
3dmodels/connectors/amphenol/20021321-00008T4LF.STEP
3dmodels/connectors/kyocera/009155005852006.stp
3dmodels/connectors/molex/1054301204.STEP
3dmodels/connectors/molex/1054311204.step
3dmodels/connectors/molex/5040500491_picolock_4p.STEP
3dmodels/connectors/molex/5047540700.stp
3dmodels/connectors/molex/5047541100.stp
3dmodels/connectors/molex/5050661422.stp
3dmodels/electromechanical/709155001615004.stp
3dmodels/mech/Just Screw It Spacer SLA.step
3dmodels/mech/Just Screw It Spacer.step
3dmodels/switches/CHS-01TB.SLDPRT
3dmodels/switches/KAE01SGGT.SLDPRT
3dmodels/vhrd_mcu_stm_h7/LQFP-100_STM.SLDPRT
3dmodels/vhrd_mcu_stm_h7/LQFP-100_STM_.SLDPRT
3dmodels/vhrd_transformer/750315125.STEP
