vhrdtech/kicad-library/tools/kilib/crates/kilib/src/lint/pins.rs

//! Pin numbers on Pins.F (User.19; Pins.B, User.20, on the back), so a fab or assembly print can show which pad is
//! which on demand:
//!
//! - a connector: every pin;
//! - another part with three or more pins: pin 1 and every 5th (5, 10, 15...), every 10th past [`DENSE`] pins;
//!   pins not numbered with digits (a BGA's A1) only pin 1;
//! - two-pin parts, test points, net ties, logos, holes: none;
//! - a pad on the copper of a pad already numbered (USB-C's B12 on A1): none of its own.
//!
//! Each number is a stroke text inside the part, at its pad's inner end: inside the fab outline (else the
//! courtyard), [`GAP`] clear of every pad and hole and a glyph's height from the other numbers, on a side of the pad with no other pad
//! in line within [`OPEN`] (never squeezed between two pads), toward the body's middle; a pad wholly outside the
//! body has its number pulled in to the body's edge. Text reads left to right (0°), or top to bottom ([`crate::reading`]: 270°,
//! 90° on the back) where that fits and level does not; never upside down or bottom to top. A number that has no room inside stays beside
//! its pad, outside, level, and is reported (a connector whose body is mostly pads; a footprint with neither fab
//! outline nor courtyard). The footprint gets one size for all its numbers: of [`SIZES`] the one with the most
//! numbers inside, the largest among those; a number that fits nowhere is left out and reported. On the back the
//! text is mirrored. The layer belongs to this rule: whatever else is there is replaced.
//!
//! On a board a placed part's rotation turns its texts: [`board`] turns each number by the half turn that makes it read
//! left to right or top to bottom, keeping the ink where it is, so spacing stays as the library made it.

use super::{Class, Input, Outcome, delete, insert};
use crate::fab::{self, BodyFrom, thickness};
use crate::footprint::{Pt, Rect, fmt, turner};
use crate::layers::{PINS, side_of};
use crate::migrate::Edit;
use crate::reading::{reading, vertical};
use crate::sexpr::{self, Node};
use crate::stroke::{Ink, ink};

/// The sizes tried, largest first.
pub const SIZES: [f64; 6] = [0.5, 0.4, 0.35, 0.3, 0.25, 0.2];
/// Room kept between a number's ink and any pad or other number.
pub const GAP: f64 = 0.1;
/// A side of a pad with another pad in line closer than this is not open.
pub const OPEN: f64 = 2.0;
/// Past this many pins a part gets every 10th number instead of every 5th.
pub const DENSE: usize = 40;

/// One number as it should be written: the text, its anchor, angle and size, and whether it sits inside the body.
#[derive(Debug, Clone, PartialEq)]
struct Wanted {
    text: String,
    at: Pt,
    angle: f64,
    size: f64,
    inside: bool,
}

/// A connector: from its library or its name.
fn connector(lib: &str, name: &str) -> bool {
    let n = name.to_ascii_lowercase();
    lib.contains("Connector")
        || ["conn", "pinheader", "pinsocket", "header", "socket", "usb", "rj45", "terminal"]
            .iter()
            .any(|k| n.contains(k))
}

/// The pad numbers that get a label, each with the first pad of that number, in the order of the file.
fn labelled<'a>(i: &'a Input) -> Vec<(&'a str, Rect)> {
    let mut seen: Vec<&str> = Vec::new();
    let mut pads = Vec::new();
    for p in i.fp.copper_pads() {
        if p.number.is_empty() || seen.contains(&p.number.as_str()) {
            continue;
        }
        seen.push(&p.number);
        // A pad on the copper of one already numbered (USB-C's B12 on A1) shares its number's place.
        let b = p.outline.bbox();
        if pads.iter().any(|(_, q): &(&str, Rect)| overlaps(q, &b)) {
            continue;
        }
        pads.push((p.number.as_str(), b));
    }
    if pads.len() < 3 {
        return Vec::new();
    }
    if connector(i.lib, &i.fp.name) {
        return pads;
    }
    let every = if pads.len() > DENSE { 10 } else { 5 };
    let numeric = pads.iter().all(|(n, _)| n.parse::<u32>().is_ok());
    pads.into_iter()
        .filter(|(n, _)| match n.parse::<u32>() {
            Ok(k) if numeric => k == 1 || k % every == 0,
            _ => *n == "1" || *n == "A1",
        })
        .collect()
}

fn overlaps(a: &Rect, b: &Rect) -> bool {
    a.x0 < b.x1 && b.x0 < a.x1 && a.y0 < b.y1 && b.y0 < a.y1
}

/// Where numbers may go: the pads (all, holes included), the middle of the pads and the body they go inside, if
/// the footprint has a fab outline or courtyard.
struct Layout<'a> {
    pads: &'a [Rect],
    middle: Pt,
    body: Option<Rect>,
}

/// One way to write a number: anchor, angle, the ink it covers, and whether that is inside the body.
struct Cand {
    at: Pt,
    angle: f64,
    rect: Rect,
    inside: bool,
}

fn within(body: &Rect, r: &Rect) -> bool {
    const EPS: f64 = 1e-3;
    r.x0 >= body.x0 - EPS && r.x1 <= body.x1 + EPS && r.y0 >= body.y0 - EPS && r.y1 <= body.y1 + EPS
}

/// Every way to write a number for `pad`, best first: inside the body (each side of the pad, level before top to
/// bottom), then beside the pad, outside, level.
fn candidates(pad: &Rect, lay: &Layout, base: &Ink, back: bool) -> Vec<Cand> {
    let (cx, cy) = pad.center();
    let towards = lay.body.map_or(lay.middle, |b| b.center());
    // From the middle to the pad: a side facing along it points away from the middle.
    let (dx, dy) = (cx - towards.0, cy - towards.1);
    let dirs: [Pt; 4] = [(1.0, 0.0), (-1.0, 0.0), (0.0, 1.0), (0.0, -1.0)];
    // The other pads in line with this one on side `k`, with the gap to each and whether it is a peer (about the
    // pad's own width across).
    let in_line = |k: usize| -> Vec<(f64, bool)> {
        let (ux, _) = dirs[k];
        let cross = if ux != 0.0 { pad.h() } else { pad.w() };
        lay.pads
            .iter()
            .filter(|p| *p != pad)
            .filter_map(|p| {
                let across = if ux != 0.0 { p.y0 < pad.y1 && pad.y0 < p.y1 } else { p.x0 < pad.x1 && pad.x0 < p.x1 };
                let gap = match k {
                    0 => p.x0 - pad.x1,
                    1 => pad.x0 - p.x1,
                    2 => p.y0 - pad.y1,
                    _ => pad.y0 - p.y1,
                };
                let theirs = if ux != 0.0 { p.h() } else { p.w() };
                (across && gap > -1e-9).then_some((gap, theirs < cross * 2.0 && theirs > cross * 0.5))
            })
            .collect()
    };
    // The pad's end along its long side.
    let long = |k: usize| {
        let (ux, uy) = dirs[k];
        if pad.w() > pad.h() * 1.2 {
            ux != 0.0
        } else if pad.h() > pad.w() * 1.2 {
            uy != 0.0
        } else {
            false
        }
    };
    // A side is open when no other pad lies in line with this one that way within [`OPEN`]: a number between
    // two pads would read as either's.
    let open = |k: usize| in_line(k).iter().all(|&(gap, _)| gap >= OPEN);
    // Inside the body a number may stand toward a pad that is in line, if it is nearer its own pad: its far end
    // within a half of the gap to another pad (a third, to a peer across the pad's short side: the next pin of the row).
    let near = |k: usize, e: f64| {
        let factor = |peer: bool| if peer && !long(k) { 3.0 } else { 2.0 };
        in_line(k).iter().all(|&(gap, peer)| gap >= factor(peer) * (GAP + e))
    };
    let away = |k: usize| dirs[k].0 * dx + dirs[k].1 * dy;
    let cmp = |a: &f64, b: &f64| a.partial_cmp(b).unwrap_or(std::cmp::Ordering::Equal);
    let mut inner: Vec<usize> = (0..4).collect();
    // Open sides first, the pad's inner end first among them, then toward the middle; on a tie, right before left,
    // below before above.
    inner.sort_by(|&a, &b| {
        (open(b), long(b) && away(b) < 0.0)
            .cmp(&(open(a), long(a) && away(a) < 0.0))
            .then(cmp(&away(a), &away(b)))
            .then(a.cmp(&b))
    });
    let mut outer: Vec<usize> = (0..4).collect();
    outer.sort_by(|&a, &b| {
        (open(b), long(b) && away(b) > 0.0)
            .cmp(&(open(a), long(a) && away(a) > 0.0))
            .then(cmp(&away(b), &away(a)))
            .then(a.cmp(&b))
    });
    // Left to right first, then top to bottom ([`crate::reading`]).
    let angles = [0.0, vertical(back)];
    let mut out = Vec::new();
    let mut add = |k: usize, angle: f64, pull: bool| {
        let ink = base.turned(angle);
        let (w, h) = (ink.width(), ink.height());
        let mut c = match k {
            0 => (pad.x1 + GAP + w / 2.0, cy),
            1 => (pad.x0 - GAP - w / 2.0, cy),
            2 => (cx, pad.y1 + GAP + h / 2.0),
            _ => (cx, pad.y0 - GAP - h / 2.0),
        };
        if let (true, Some(b)) = (pull, lay.body) {
            // A pad wholly outside the body: its number goes in to the body's edge.
            match k {
                0 => c.0 = c.0.max(b.x0 + w / 2.0),
                1 => c.0 = c.0.min(b.x1 - w / 2.0),
                2 => c.1 = c.1.max(b.y0 + h / 2.0),
                _ => c.1 = c.1.min(b.y1 - h / 2.0),
            }
        }
        let (ax, ay) = ink.centre();
        let at = (r3(c.0 - ax), r3(c.1 - ay));
        let rect = ink_rect(&ink, at);
        // Only what the inside pass made counts as inside; the outside pass is the last resort, on any side.
        let inside = pull && lay.body.is_some_and(|b| within(&b, &rect));
        out.push(Cand { at, angle, rect, inside });
    };
    if lay.body.is_some() {
        for &k in &inner {
            for a in angles {
                let e = if dirs[k].0 != 0.0 { base.turned(a).width() } else { base.turned(a).height() };
                if near(k, e) {
                    add(k, a, true);
                }
            }
        }
    }
    for &k in &outer {
        add(k, 0.0, false);
    }
    // Inside ones first, in the order made; the rest keep theirs.
    out.sort_by_key(|c| !c.inside);
    out
}

fn ink_rect(i: &Ink, at: Pt) -> Rect {
    Rect { x0: at.0 + i.x0, y0: at.1 + i.y0, x1: at.0 + i.x1, y1: at.1 + i.y1 }
}

/// Every label placed at `size`, or the numbers that do not fit.
fn place(labels: &[(&str, Rect)], lay: &Layout, size: f64, back: bool) -> Result<Vec<Wanted>, Vec<String>> {
    let mut placed: Vec<Rect> = Vec::new();
    let mut out = Vec::new();
    let mut missing = Vec::new();
    for (text, pad) in labels {
        let Some(base) = ink(text, size, size, thickness(size)) else { continue };
        let base = if back { base.mirrored() } else { base };
        let found = candidates(pad, lay, &base, back).into_iter().find(|c| {
            // The anchor is rounded to 0.001 mm: the gap may come out that much short.
            let grown = c.rect.expand(GAP - 1e-3);
            // Numbers keep a glyph's height from each other, so two never read as one ("1" and "5" as "15").
            let apart = c.rect.expand(size.max(GAP) - 1e-3);
            !lay.pads.iter().any(|p| overlaps(&grown, p)) && !placed.iter().any(|q| overlaps(&apart, q))
        });
        match found {
            Some(c) => {
                placed.push(c.rect);
                out.push(Wanted { text: text.to_string(), at: c.at, angle: c.angle, size, inside: c.inside });
            }
            None => missing.push(text.to_string()),
        }
    }
    if missing.is_empty() { Ok(out) } else { Err(missing) }
}

fn r3(v: f64) -> f64 {
    let r = (v * 1000.0).round() / 1000.0;
    if r == 0.0 { 0.0 } else { r }
}

/// The box numbers go inside: the fab outline's, else the courtyard's; `None` where the footprint draws neither.
fn body(i: &Input) -> Option<Rect> {
    let root = sexpr::parse(i.text).ok()?;
    let shape = fab::read_node(&root, &format!("{}:{}", i.lib, i.fp.name), false).shape?;
    let r = shape.region;
    matches!(shape.body_from, BodyFrom::Fab | BodyFrom::Courtyard).then_some(Rect {
        x0: r.x0,
        y0: r.y0,
        x1: r.x1,
        y1: r.y1,
    })
}

/// The numbers to write, and those that fit nowhere even at the smallest size.
fn wanted(i: &Input) -> (Vec<Wanted>, Vec<String>) {
    let labels = labelled(i);
    if labels.is_empty() {
        return (Vec::new(), Vec::new());
    }
    // Holes without copper are in the way too.
    let pads: Vec<Rect> = i.fp.pads.iter().map(|p| p.outline.bbox()).collect();
    let middle = i.fp.pads_box().map_or((0.0, 0.0), |b| b.center());
    let lay = Layout { pads: &pads, middle, body: body(i) };
    // The size with the most numbers inside the body, the largest of those.
    let mut best: Option<(usize, Vec<Wanted>)> = None;
    for &size in &SIZES {
        if let Ok(w) = place(&labels, &lay, size, i.fp.back) {
            let inside = w.iter().filter(|x| x.inside).count();
            if best.as_ref().is_none_or(|(n, _)| inside > *n) {
                best = Some((inside, w));
            }
        }
    }
    if let Some((_, w)) = best {
        return (w, Vec::new());
    }
    // At the smallest size: those that fit, in order, the rest reported.
    let size = SIZES[SIZES.len() - 1];
    let mut out = Vec::new();
    let mut missing = Vec::new();
    for l in &labels {
        let mut with =
            labels.iter().filter(|x| out.iter().any(|w: &Wanted| w.text == x.0)).copied().collect::<Vec<_>>();
        with.push(*l);
        match place(&with, &lay, size, i.fp.back) {
            Ok(w) => out = w,
            Err(_) => missing.push(l.0.to_string()),
        }
    }
    (out, missing)
}

fn render(w: &Wanted, layer: &str, back: bool) -> String {
    let mirror = if back { "\t\t\t(justify mirror)\n" } else { "" };
    format!(
        "\t(fp_text user {}\n\t\t(at {} {} {})\n\t\t(unlocked yes)\n\t\t(layer {})\n\t\t(effects\n\t\t\t(font\n\t\t\t\t(size {s} {s})\n\t\t\t\t(thickness {})\n\t\t\t)\n{mirror}\t\t)\n\t)\n",
        sexpr::quote(&w.text),
        fmt(w.at.0),
        fmt(w.at.1),
        fmt(w.angle),
        sexpr::quote(layer),
        fmt(thickness(w.size)),
        s = fmt(w.size),
    )
}

pub fn run(i: &Input) -> Outcome {
    let mut out = Outcome::default();
    let layer = side_of(PINS, i.fp.back);
    let (want, missing) = if i.class == Class::Part { wanted(i) } else { (Vec::new(), Vec::new()) };
    let have: Vec<_> = i.fp.texts.iter().filter(|t| t.layer == layer).collect();
    let same = have.len() == want.len()
        && want.iter().all(|w| {
            have.iter().any(|t| {
                t.text == w.text
                    && (t.at.0 - w.at.0).abs() < 1e-4
                    && (t.at.1 - w.at.1).abs() < 1e-4
                    && (t.angle - w.angle).abs() < 1e-4
                    && (t.size - w.size).abs() < 1e-6
            })
        });
    if !missing.is_empty() {
        out.left(format!("{layer}: no room beside the pads for {}", missing.join(", ")));
    }
    let outside: Vec<&str> = want.iter().filter(|w| !w.inside).map(|w| w.text.as_str()).collect();
    if !outside.is_empty() {
        out.left(format!(
            "{layer}: {} of {} pin numbers outside the body, no room inside: {}",
            outside.len(),
            want.len(),
            outside.join(", ")
        ));
    }
    if same {
        return out;
    }
    let had = if have.is_empty() { String::new() } else { format!(" (replacing {})", have.len()) };
    if want.is_empty() {
        out.fixed(format!("{layer}: no pin numbers for this footprint{had}"));
    } else {
        out.fixed(format!("{layer}: {} pin numbers at {} mm{had}", want.len(), fmt(want[0].size)));
    }
    for t in have {
        out.edits.push(delete(i.text, &t.span));
    }
    if !want.is_empty() {
        out.edits.push(insert(i.fp, want.iter().map(|w| render(w, layer, i.fp.back)).collect()));
    }
    out
}

/// What happens to the pin numbers of one footprint on a board.
#[derive(Debug, Clone, Default, PartialEq)]
pub struct BoardPins {
    /// Each number turned: the text, the angle it had and the angle it gets.
    pub turned: Vec<(String, f64, f64)>,
    /// Numbers that already read left to right or top to bottom.
    pub fine: usize,
    /// Numbers left alone, with the reason.
    pub skipped: Vec<String>,
}

/// Turns each pin number of a footprint placed on a board (`node`, at angle `phi`, on the back when `back`) so it
/// reads left to right or top to bottom: the file keeps a text's angle on the board, so a rotated part's numbers
/// point every way. The turn is a half turn at most, the ink's middle stays where it was (the anchor moves by the
/// difference, in the footprint's frame), so the clearance the library gave is kept.
pub fn board(node: &Node, back: bool, phi: f64) -> (BoardPins, Vec<Edit>) {
    let layer = side_of(PINS, back);
    let mut out = BoardPins::default();
    let mut edits = Vec::new();
    for t in node.children("fp_text").filter(|t| t.arg(0) == Some("user") && t.value("layer") == Some(layer)) {
        let text = t.arg(1).unwrap_or("").to_string();
        let Some(at) = t.child("at") else { continue };
        let num = |k: usize| at.items().get(k).and_then(Node::as_atom).and_then(|s| s.parse::<f64>().ok());
        let (Some(x), Some(y)) = (num(1), num(2)) else { continue };
        let angle = num(3).unwrap_or(0.0);
        let size = t
            .child("effects")
            .and_then(|e| e.child("font"))
            .and_then(|f| f.child("size"))
            .and_then(|s| s.items().get(1))
            .and_then(Node::as_atom)
            .and_then(|s| s.parse::<f64>().ok())
            .unwrap_or(1.0);
        if angle.rem_euclid(90.0).min(90.0 - angle.rem_euclid(90.0)) > 1e-3 {
            out.skipped.push(format!("{text}: at {}°", fmt(angle)));
            continue;
        }
        let target = reading(angle, back);
        if (angle - target).rem_euclid(360.0) < 1e-3 || (target - angle).rem_euclid(360.0) < 1e-3 {
            out.fine += 1;
            continue;
        }
        let Some(base) = ink(&text, size, size, thickness(size)) else { continue };
        let base = if back { base.mirrored() } else { base };
        let (old, new) = (base.turned(angle).centre(), base.turned(target).centre());
        // The ink is drawn in board directions, the anchor is in the footprint's frame.
        let (lx, ly) = turner((0.0, 0.0), -phi)((old.0 - new.0, old.1 - new.1));
        let at_new = format!("(at {} {} {})", fmt(r3(x + lx)), fmt(r3(y + ly)), fmt(target));
        edits.push(Edit { range: at.span(), text: at_new });
        out.turned.push((text, angle, target));
    }
    (out, edits)
}

#[cfg(test)]
mod tests {
    use super::super::Rule;
    use super::super::tests::{fp, run, settled};
    use crate::footprint;

    fn pads(n: usize, pitch: f64) -> String {
        (0..n)
            .map(|k| {
                let (x, y) = if k < n / 2 { (-2.5, k as f64 * pitch) } else { (2.5, (n - 1 - k) as f64 * pitch) };
                format!(
                    "(pad \"{}\" smd rect (at {x} {y}) (size 1.5 {}) (layers \"F.Cu\" \"F.Mask\"))\n",
                    k + 1,
                    pitch * 0.6
                )
            })
            .collect()
    }

    fn numbers(text: &str) -> Vec<String> {
        let f = footprint::read(text).unwrap();
        f.texts.iter().filter(|t| t.layer == "User.19").map(|t| t.text.clone()).collect()
    }

    #[test]
    fn an_ic_gets_pin_1_and_every_5th_outside_its_pads() {
        let t = fp("SOIC-16", &pads(16, 1.27));
        let (new, f) = run("VHRD_Package_SO", &t, Rule::Pins);
        let new = new.unwrap();
        assert_eq!(numbers(&new), ["1", "5", "10", "15"]);
        assert!(f.iter().any(|f| f.fixed && f.message == "User.19: 4 pin numbers at 0.5 mm"), "{f:?}");
        // No fab outline or courtyard: no body to go inside, reported.
        assert!(f.iter().any(|f| !f.fixed && f.message.contains("4 of 4 pin numbers outside the body")), "{f:?}");
        // Pin 1: its number at the pad's outer end, left of it, clear of it.
        let f = footprint::read(&new).unwrap();
        let one = f.texts.iter().find(|t| t.text == "1" && t.layer == "User.19").unwrap();
        assert!(one.at.0 < -3.25 - super::GAP && one.at.1.abs() < 0.05, "{:?}", one.at);
        settled("VHRD_Package_SO", &t, Rule::Pins);
    }

    #[test]
    fn a_dense_part_gets_every_10th_and_a_connector_every_pin() {
        let t = fp("LQFP-48", &pads(48, 0.5));
        assert_eq!(numbers(&run("VHRD_Package_QFP", &t, Rule::Pins).0.unwrap()), ["1", "10", "20", "30", "40"]);
        let t = fp(
            "PinHeader_1x04",
            &(0..4)
                .map(|k| {
                    format!(
                        "(pad \"{}\" thru_hole oval (at 0 {}) (size 1.7 1.7) (drill 1) (layers \"*.Cu\" \"*.Mask\"))\n",
                        k + 1,
                        k as f64 * 2.54
                    )
                })
                .collect::<String>(),
        );
        let new = run("VHRD_Connector_PinHeader_2.54mm", &t, Rule::Pins).0.unwrap();
        assert_eq!(numbers(&new), ["1", "2", "3", "4"]);
        // A single row: the inner numbers beside the pads, not between them; the end ones beyond the ends.
        let f = footprint::read(&new).unwrap();
        let at = |n: &str| f.texts.iter().find(|t| t.layer == "User.19" && t.text == n).unwrap().at;
        assert!(at("2").0.abs() > 0.85 && at("3").0.abs() > 0.85, "{new}");
        assert!(at("1").1 < -0.85 && at("4").1 > 3.0 * 2.54 + 0.85, "{new}");
        settled("VHRD_Connector_PinHeader_2.54mm", &t, Rule::Pins);
    }

    /// A SOIC-8 with its fab outline (4 x 5) and courtyard.
    const SOIC_BODY: &str = r#"(fp_rect (start -1.95 -0.8) (end 1.95 4.6) (stroke (width 0.05) (type solid)) (layer "F.Fab"))
(fp_rect (start -3.7 -1.1) (end 3.7 4.9) (stroke (width 0.05) (type solid)) (fill no) (layer "F.CrtYd"))
"#;

    fn spots(text: &str) -> Vec<(String, f64, f64, f64)> {
        let f = footprint::read(text).unwrap();
        f.texts.iter().filter(|t| t.layer == "User.19").map(|t| (t.text.clone(), t.at.0, t.at.1, t.angle)).collect()
    }

    #[test]
    fn numbers_go_inside_the_fab_outline_level_at_the_pads_inner_end() {
        let t = fp("SOIC-8", &format!("{SOIC_BODY}{}", pads(8, 1.27)));
        let (new, f) = run("VHRD_Package_SO", &t, Rule::Pins);
        let new = new.unwrap();
        assert!(f.iter().all(|f| f.fixed), "nothing outside: {f:?}");
        for (n, x, y, a) in spots(&new) {
            // Left pads at x -2.5 (inner edge -1.75), right pads at 2.5: the number is in the body, beside them.
            assert!(x.abs() < 1.95 && y > -0.8 && y < 4.6, "{n} at ({x}, {y}) is outside the body");
            assert!(x.abs() > 0.5, "{n} at ({x}, {y}) is not by its pad");
            assert_eq!(a, 0.0, "{n} reads left to right");
        }
        settled("VHRD_Package_SO", &t, Rule::Pins);
    }

    #[test]
    fn a_pad_wholly_outside_the_body_has_its_number_pulled_to_the_body_edge() {
        // Pads at +-2.5 are wider than the pads() default; here they sit clear of a 2 mm wide body.
        let body = r#"(fp_rect (start -1 -0.5) (end 1 4.3) (stroke (width 0.05) (type solid)) (layer "F.Fab"))
"#;
        let t = fp("SOIC-8", &format!("{body}{}", pads(8, 1.27).replace("size 1.5", "size 0.8")));
        let new = run("VHRD_Package_SO", &t, Rule::Pins).0.unwrap();
        let f = footprint::read(&new).unwrap();
        let one = f.texts.iter().find(|t| t.text == "1" && t.layer == "User.19").unwrap();
        assert!(one.at.0.abs() < 1.0, "{:?}", one.at);
    }

    #[test]
    fn a_connector_filling_its_body_keeps_what_has_no_room_outside_and_says_so() {
        let t = fp(
            "PinHeader_1x04",
            &format!(
                "(fp_rect (start -0.95 -1.5) (end 0.95 7.5) (stroke (width 0.05) (type solid)) (layer \"F.Fab\"))\n{}",
                (0..4)
                    .map(|k| format!(
                        "(pad \"{}\" thru_hole oval (at 0 {}) (size 1.7 1.7) (drill 1) (layers \"*.Cu\" \"*.Mask\"))\n",
                        k + 1,
                        k as f64 * 2.0
                    ))
                    .collect::<String>()
            ),
        );
        let (new, f) = run("VHRD_Connector_PinHeader_2.54mm", &t, Rule::Pins);
        assert!(f.iter().any(|f| !f.fixed && f.message.contains("outside the body, no room inside")), "{f:?}");
        assert_eq!(numbers(&new.unwrap()).len(), 4);
    }

    /// A part placed at `phi`, with pin number "10" (library angle 0, anchor (-2, 1)) written as KiCad keeps it on the
    /// board: its angle includes the part's.
    fn placed(phi: f64, angle: f64, layer: &str) -> String {
        format!(
            "(kicad_pcb\n\t(footprint \"VHRD_Package_SO:SOIC-8\"\n\t\t(layer \"F.Cu\")\n\t\t(at 50 40 {phi})\n\t\t(fp_text user \"10\"\n\t\t\t(at -2 1 {angle})\n\t\t\t(unlocked yes)\n\t\t\t(layer \"{layer}\")\n\t\t\t(effects\n\t\t\t\t(font\n\t\t\t\t\t(size 0.4 0.4)\n\t\t\t\t\t(thickness 0.06)\n\t\t\t\t)\n\t\t\t)\n\t\t)\n\t)\n)\n"
        )
    }

    fn board_text(board: &str) -> (f64, f64, f64) {
        let root = crate::sexpr::parse(board).unwrap();
        let fp = root.children("footprint").next().unwrap();
        let at = fp.children("fp_text").next().unwrap().child("at").unwrap();
        let n = |k: usize| at.items()[k].as_atom().unwrap().parse::<f64>().unwrap();
        (n(1), n(2), n(3))
    }

    #[test]
    fn on_a_board_a_rotated_parts_numbers_read_left_to_right_or_top_to_bottom_with_their_ink_in_place() {
        // Level on the board already: nothing to do. Turned a quarter: top to bottom, 270. Upside down: level.
        for (phi, angle, want) in
            [(0.0, 0.0, 0.0), (90.0, 90.0, 270.0), (180.0, 180.0, 0.0), (270.0, 270.0, 270.0), (90.0, 0.0, 0.0)]
        {
            let b = placed(phi, angle, "User.19");
            let plan = crate::fab::plan_board(&b).unwrap();
            let (_, _, a) = board_text(&plan.new);
            assert_eq!(a, want, "part at {phi}, text at {angle}");
            let pins = &plan.items[0].pins;
            assert_eq!(pins.turned.len() + pins.fine, 1);
            // The ink stays where it was on the board: the anchor moves only by the difference of the two boxes.
            let ink = |angle: f64, at: (f64, f64)| {
                let i = crate::stroke::ink("10", 0.4, 0.4, 0.06).unwrap().turned(angle);
                let (cx, cy) = i.centre();
                let (sin, cos) = phi.to_radians().sin_cos();
                (50.0 + at.0 * cos + at.1 * sin + cx, 40.0 - at.0 * sin + at.1 * cos + cy)
            };
            let (x, y, a0) = board_text(&b);
            let (nx, ny, a1) = board_text(&plan.new);
            let (before, after) = (ink(a0, (x, y)), ink(a1, (nx, ny)));
            assert!((before.0 - after.0).abs() < 2e-3 && (before.1 - after.1).abs() < 2e-3, "{before:?} {after:?}");
            // A second run changes nothing.
            assert_eq!(crate::fab::plan_board(&plan.new).unwrap().new, plan.new);
        }
    }

    #[test]
    fn on_a_board_a_number_on_the_back_reads_by_the_back_view() {
        // Seen from the back (KiCad's left-to-right flip) a mirrored text at 0° reads left to right and at 90° top to
        // bottom: a back part turned a quarter keeps its numbers at 90°, one turned back to level at 0°.
        let back = |phi: f64, angle: f64| placed(phi, angle, "User.20").replace("(layer \"F.Cu\")", "(layer \"B.Cu\")");
        for (phi, angle, want) in [(0.0, 0.0, 0.0), (90.0, 270.0, 90.0), (180.0, 180.0, 0.0), (90.0, 90.0, 90.0)] {
            let plan = crate::fab::plan_board(&back(phi, angle)).unwrap();
            assert_eq!(board_text(&plan.new).2, want, "back part at {phi}, text at {angle}");
        }
    }

    #[test]
    fn on_a_board_a_slanted_number_and_other_layers_are_left() {
        let slanted = crate::fab::plan_board(&placed(45.0, 45.0, "User.19")).unwrap();
        assert_eq!(slanted.new, placed(45.0, 45.0, "User.19"));
        assert_eq!(slanted.items[0].pins.skipped.len(), 1);
        let other = placed(90.0, 90.0, "User.17");
        assert_eq!(crate::fab::plan_board(&other).unwrap().new, other);
    }

    #[test]
    fn two_pin_parts_and_test_points_get_none_and_stray_numbers_go() {
        let two = "(pad \"1\" smd rect (at -1 0) (size 1 1) (layers \"F.Cu\"))\n(pad \"2\" smd rect (at 1 0) (size 1 1) (layers \"F.Cu\"))";
        assert!(run("VHRD_Resistor_SMD", &fp("R_0603", two), Rule::Pins).0.is_none());
        let stray =
            format!("{two}\n(fp_text user \"1\" (at 0 0 0) (layer \"User.19\") (effects (font (size 0.5 0.5))))");
        let (new, f) = run("VHRD_Resistor_SMD", &fp("R_0603", &stray), Rule::Pins);
        assert!(!new.unwrap().contains("User.19"));
        assert!(f[0].message.ends_with("(replacing 1)"), "{f:?}");
        let t = fp("TestPoint_3", &pads(4, 1.27));
        assert!(run("VHRD_TestPoint", &t, Rule::Pins).0.is_none());
    }

    #[test]
    fn on_the_back_numbers_are_mirrored_on_pins_b() {
        let t = fp("SOIC-8", &pads(8, 1.27).replace("\"F.Cu\"", "\"B.Cu\""))
            .replace("(layer \"F.Cu\")", "(layer \"B.Cu\")");
        let new = run("VHRD_Package_SO", &t, Rule::Pins).0.unwrap();
        assert!(new.contains("(layer \"User.20\")") && new.contains("(justify mirror)"), "{new}");
    }

    #[test]
    fn a_pad_on_numbered_copper_and_holes() {
        // B12 on A1's copper gets no number of its own; a hole beside the pads is kept clear.
        let t = fp(
            "USB_C_X",
            r#"(pad "A1" smd rect (at 0 0) (size 0.6 1.2) (layers "F.Cu"))
(pad "B12" smd rect (at 0 0) (size 0.6 1.2) (layers "F.Cu"))
(pad "A4" smd rect (at 2 0) (size 0.6 1.2) (layers "F.Cu"))
(pad "A5" smd rect (at 4 0) (size 0.6 1.2) (layers "F.Cu"))
(pad "" np_thru_hole circle (at 0 -1.4) (size 0.65 0.65) (drill 0.65) (layers "*.Cu" "*.Mask"))"#,
        );
        let new = run("VHRD_Connector_USB", &t, Rule::Pins).0.unwrap();
        assert_eq!(numbers(&new), ["A1", "A4", "A5"]);
        let f = footprint::read(&new).unwrap();
        let a1 = f.texts.iter().find(|t| t.text == "A1" && t.layer == "User.19").unwrap();
        assert!(a1.at.1 > -0.6 || a1.at.1 < -1.4 - 0.33 - super::GAP, "{:?}", a1.at);
    }
}
