vhrdtech/kicad-library/tools/kilib/crates/kilib/src/per_package.rs

//! Per-package symbols: a generic symbol (`VHRD_Device:R`, which leaves `Footprint` empty) gets one symbol per
//! package it is placed with (`VHRD_Device:R_0402`), so whatever is keyed by the library symbol (a footprint
//! review, a BOM line) covers one footprint. The rename map's `[per_package]` names them; [`plan`] makes each one
//! the map lacks in the checkout, and `kilib migrate` moves placed generic symbols onto them.
//!
//! A per-package symbol is derived from its generic (`extends`), in the generic's library: the generic's fields,
//! with `Footprint` and `ki_fp_filters` set to the footprint. Pins, units, graphics and flags (`in_bom`, ...) stay
//! the generic's; KiCad does not keep flags on a derived symbol.
//! [`survey`] lists the generic symbols boards place, by footprint, with the per-package symbol of the map.

use std::collections::BTreeMap;
use std::path::{Path, PathBuf};

use crate::map::Map;
use crate::migrate::{Edit, Severity, apply_edits};
use crate::sexpr::{self, Node};
use crate::stock::symbol::sym_path;

/// One per-package symbol of the map.
#[derive(Debug, Clone, PartialEq, Eq)]
pub struct Item {
    /// `Lib:Name` of the per-package symbol.
    pub id: String,
    pub generic: String,
    pub footprint: String,
    pub path: PathBuf,
    /// The text to write; `None` when the checkout has it already, as it should be.
    pub new: Option<String>,
}

#[derive(Debug, Clone, Default, PartialEq)]
pub struct Plan {
    pub items: Vec<Item>,
    pub notes: Vec<(Severity, String)>,
}

impl Plan {
    pub fn has_errors(&self) -> bool {
        self.notes.iter().any(|(s, _)| *s == Severity::Error)
    }

    pub fn to_write(&self) -> impl Iterator<Item = &Item> {
        self.items.iter().filter(|i| i.new.is_some())
    }
}

fn read(path: &Path) -> Result<String, String> {
    std::fs::read_to_string(path).map_err(|e| format!("{}: {e}", path.display()))
}

fn only_symbol(root: &Node) -> Result<&Node, String> {
    let mut syms = root.children("symbol");
    match (syms.next(), syms.next()) {
        (Some(s), None) => Ok(s),
        _ => Err("not one symbol in the file".into()),
    }
}

fn property<'a>(sym: &'a Node, name: &str) -> Option<&'a Node> {
    sym.children("property").find(|p| p.arg(0) == Some(name))
}

/// A symbol file's one symbol, parsed.
fn symbol_of(path: &Path) -> Result<(String, Node), String> {
    let text = read(path)?;
    let root = sexpr::parse(&text).map_err(|e| format!("{}: {e}", path.display()))?;
    only_symbol(&root).map_err(|e| format!("{}: {e}", path.display()))?;
    Ok((text, root))
}

/// Every per-package symbol of `map` in the checkout `library`: made where it is missing, checked where it is
/// there (derived from its generic, `Footprint` and `ki_fp_filters` at its footprint). The generic must leave
/// `Footprint` empty, and the footprint must be in the checkout's `footprints/`.
pub fn plan(library: &Path, map: &Map) -> Plan {
    let symbols = library.join("symbols");
    let footprints = library.join("footprints");
    let mut plan = Plan::default();
    for (generic, by_fp) in &map.per_package {
        let Some((lib, gname)) = generic.split_once(':') else { continue };
        let gpath = sym_path(&symbols, lib, gname);
        let parent = match symbol_of(&gpath) {
            Ok(p) => p,
            Err(e) => {
                plan.notes.push((Severity::Error, format!("generic {generic}: {e}")));
                continue;
            }
        };
        let (gtext, groot) = &parent;
        let gsym = only_symbol(groot).expect("checked");
        if let Some(fp) = property(gsym, "Footprint").and_then(|p| p.arg(1)).filter(|f| !f.is_empty()) {
            plan.notes.push((Severity::Error, format!("generic {generic} sets Footprint {fp}: not a generic symbol")));
            continue;
        }
        for (fp, id) in by_fp {
            let Some((fplib, fpname)) = fp.split_once(':') else { continue };
            let name = id.split_once(':').map_or(id.as_str(), |(_, n)| n);
            let path = sym_path(&symbols, lib, name);
            let fp_file = footprints.join(format!("{fplib}.pretty")).join(format!("{fpname}.kicad_mod"));
            if !fp_file.is_file() {
                plan.notes.push((Severity::Error, format!("{id}: footprint {fp} is not in footprints/")));
                continue;
            }
            let item =
                |new| Item { id: id.clone(), generic: generic.clone(), footprint: fp.clone(), path: path.clone(), new };
            if path.exists() {
                match check_existing(&path, gname, fp) {
                    Ok(()) => plan.items.push(item(None)),
                    Err(e) => plan.notes.push((Severity::Error, format!("{id}: {e}"))),
                }
            } else {
                match derived(gtext, gsym, name, fp) {
                    Ok(text) => plan.items.push(item(Some(text))),
                    Err(e) => plan.notes.push((Severity::Error, format!("{id}: {e}"))),
                }
            }
        }
    }
    plan
}

/// A per-package symbol already in the checkout: derived from `generic`, its footprint and filter at `fp`.
fn check_existing(path: &Path, generic: &str, fp: &str) -> Result<(), String> {
    let (_, root) = symbol_of(path)?;
    let sym = only_symbol(&root)?;
    let extends = sym.child("extends").and_then(|e| e.arg(0));
    if extends != Some(generic) {
        return Err(format!("{} does not extend {generic}", path.display()));
    }
    for field in ["Footprint", "ki_fp_filters"] {
        let value = property(sym, field).and_then(|p| p.arg(1)).unwrap_or_default();
        if value != fp {
            return Err(format!("{field} is {value:?}, not {fp}"));
        }
    }
    Ok(())
}
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
