vhrdtech/kicad-library/(commit log)

2023-03-22 Add PicoLock 4P. Add power symbols. Add B0505MT.
    [5040500491_picolock_4p.STEP, B05xxMT-1WR4.STEP]
2023-03-29 Add ECX-.327.
    [ECX-.327-CDX-1293.STEP]
2023-03-29 Add BAT-HLD-001-THM.
    [BAT-HLD-001-THM.STEP]
2023-03-29 Add B0505MT.
    [B0505MT-1WR4.STEP]
2023-03-29 Add D5V0P4UR6SO-7
    [D5V0P4UR6SO-7.step]
2023-04-10 Add +VIN_USB power.
2023-04-13 Add 5047540700 and 5047541100
    [5047540700.stp, 5047541100.stp]
2023-04-13 Add D09P33E4GL00LF
    [sD09P33E4GL00LF.stp]
2023-04-13 Add HDS10M
    [HDS10M-13.step]
2023-04-13 Add PS2911
    [SON_1-1-F3-AX_REN.step]
2023-04-13 Add ISO grounds.
2023-04-16 Fix 3D link.
    [EP10 - PA1134NL.STEP]
2023-04-16 Add TLP2270
    [SO8L_TOS.step]
2023-04-16 Add Kemet EE2 relay 3D model.
    [EE2-4.5TNUH-L.step]
2023-04-16 Add power symbols.
2023-04-17 Add ADM3050E
    [RI-8-1_ADI.step]
2023-04-18 Add MEM2061
    [MEM2061-01-188-00-A_REVA.step]
2023-04-18 Add KSS331
    [KSS331.STEP]
2023-04-21 Add 750315125
    [750315125.STEP]
2023-04-21 Add LMLP07A7
    [LMLP07A7.STEP]
2023-04-21 Add 2x20 connector
2023-05-22 Fix wrong links, add missing models.
    [DM-OLED042-647.STEP, sD09P33E4GL00LF.stp]
2023-05-23 Add boards lib and vb125c1 button board.
    [vb125c1_button_board.step]
2023-06-01 Add QTH-030-02-F-D-A and 1-1775333-6
    [1-1775333-6.STEP, QTH-030-02-F-D-A.step]
2023-06-15 Add LMR54410DBVR.
    [5050661422.stp]
2023-06-16 Fix silkscreen on many parts.
    [ASE.STEP]
2023-08-31 Add CAN-FD common mode choke.
    [L_COUPLED_3225.STEP, vb125c1_button_board.step]
2023-10-09 Add models
    [CAPC5728.step, DFN1110D-3_(SOT8015).step, IND0806.step, RSW0010A.stp, SOT-416.step, TSSOP8_PW0008A.stp]
2023-10-11 Add 3D models. Fix some errors. Add labels.
    [PowerDI-5.STEP, sD09P33E4GL00LF.stp]
2023-11-05 Add CPC1966B.
    [CPC1966B_IXYS.step]
2023-11-05 Add BM50
    [BM50U-4DP.stp, BM50U-4DS.stp]
2023-11-30 Hirose TF31. Fix footprints.
    [DDF0008A.stp, TF31-12S-0.5SH.stp, TF31-16S-0.5SH.stp, TF31-8S-0.5SH.stp]
2024-02-07 CANnify Micro STEP, Symbol and Footprint.
2024-04-27 Add KAE01SGGT switch
    [KAE01SGGT.SLDPRT, KAE01SGGT.STEP]
2024-07-14 Add STEP models for several parts. Merge connectors into one lib.
    [CHS-01TB.SLDPRT, CHS-01TB.STEP, CL-SB-12B-01T.STEP, CL-SB-22B-01T.STEP, DX07P024AJ1R1500.STEP, KAE01SGGT.SLDPRT, L77SDE09S.STEP, Wurth_610112249121.stp]
2024-12-04 Add STM32H7
    [LQFP-100_STM.STEP, UFBGA176+25.STEP]
2024-12-04 Add DB-9 3D models. Add L77SDE09S.
    [ID09P33E4GV00LF.STEP, L77SDE09SA4CH.step]
2024-12-04 Add C1632 battery.
    [3013.step, CR1632.stp]
2024-12-04 Add RBG LED and light pipe.
    [B38G3RGB-10D0003H2U1930.step, SLP3-200-100-F.step]
2024-12-04 Various library updates and improvements.
    [1-1734264-1.step, 1054301204.STEP, 1054311204.stp, 10UQFN_1_50x2_00x0_5_0_5mm_pitch.STEP, CHS-02TB.STEP, c-2337019-1-a2-3d.stp]
2025-06-11 Update 1054311204 footprint, colorize model.
    [1054311204.step, 1054311204.stp]
2025-11-09 feat: add Mill-Max POGO pins
    [mill-max-0986-0-15-20-76-14-11-0.STEP, mill-max-0986-1-15-20-75-14-11-0.STEP]
2025-11-09 feat: add buttons
    [709155001615004.stp, CS1102V3.85F100.stp, CS1102V5.85F260.stp]
2025-11-09 feat: add Type-C plugs
    [plug-usbc-241smt-th-4bc2ls.stp]
2025-11-09 feat: add 1.27 2x4 header 20021321-00008T4LF
    [20021321-00008T4LF.STEP]
2025-11-09 feat: add MIE1W0505BGLVH-3R-Z ISO power module
    [MIE1W0505BGLVH-3R-Z.STEP]
2025-11-09 feat: add missing 3D models
    [DFN-10-3x3-0.5.STEP, SC-74.step, SQFN_48.step, UQFN20.step]
2025-11-09 feat: add footprints
    [DFN-12-3x3-0.5.step]
2025-11-09 feat: update ID09P33E4GV00LF
    [ID09P33E4GV00LF.STEP]
2025-11-09 feat: update DFN-12-AOZ.kicad_mod
2025-11-09 feat: update SC-82AB-NCP563.kicad_mod
2025-11-09 feat: update BIVAR_SLP3-200-100-F.kicad_mod
2025-11-09 feat: update H7 BGA 201 footprint
2025-11-09 feat: update D_PowerDI-5.kicad_mod
2026-01-08 Add SSM3 low power P&N MOSFETs
2026-01-10 Add +1V8_LDO power symbol
2026-01-10 Add TXU 1- and 2-bit voltage translators
2026-01-10 Add INA229 power sensor and TS5A3359 SP3T switch
2026-01-13 Add power symbols
2026-01-14 Add PTS815 button
2026-01-28 Add TI VQFN-24 and wQFN-16, move TI footprints to vhrd_ti
    [BQB0016A.stp, RHL0024A.STEP]
2026-01-28 Add FH28K STEP
    [FH28K-60S-0.5SH.STEP]
2026-05-02 Add TMUX1204 and TXU0204+correct footprint and model
2026-07-15 MSD-1 (SD card), rPI QFN80, SOT-762, X2QFN-14, SOD-882D, 0.15mm spark gap
2026-08-11 adjust footprints
2026-10-17 The VHRD look from vhrd-kicad: new drawing sheets, vhrd_power colours, Vhrd Default adopted; dev rules and justfile
2026-10-31 vhrd_power colours and PWR_FLAG, vhrd_sim ammeter, drawing sheets from vhrd_brand 0.9.9
    - vhrd_power: GND green, PWR_LOCAL and PWR_FLAG in vhrd orange (colour pairs against power wires)
    - vhrd_sim (new): AMMETER, 0 V DC source drawn as a circle with an arrow + to -, and simulation-only sources
    - vhrd_a3 / vhrd_a4 and the Vhrd Default copies regenerated by vhrd-kicad 0.9.9: no title-block accent bar, SIZE column, A2 fills the frame
2026-11-04 kilib: a Rust CLI that checks boards resolve their libraries, and sets up KiCad's config
    kilib check reads the global and project library tables, kicad_common.json's path
    variables and the environment, and resolves every lib_id, Footprint field, footprint
    id and 3D model like KiCad does (versioned KICADn_3DMODEL_DIR fall back to the newest,
    .kicad_symdir stock libraries, nested tables). kilib setup plans the VHRD rows through
    ${VHRD_LIBRARY_DIR} and the path variables. Pure-Rust deps, default features off.
2026-11-04 kilib: setup and CLI tests on synthetic fixtures; absolute project folders; KiCad 10 row spacing
    Tests run against a temporary KiCad config folder and a fixture tree the test code
    writes, with a cleared environment: nothing on this PC is read or written. A relative
    PATH made KIPRJMOD relative, so project tables joined it twice; paths are now absolute.
    Rows are written with KiCad 10's spacing. Footprints without a library link and pasted
    ones are reported as not checked; a .wrl whose .step exists says so.
2026-11-04 just check-boards, kilib in test, lint and install; README, AGENTS.md, FEATURES LIB-6, CHANGELOG
    check-boards runs kilib check on ../hw (or VHRD_BOARDS_DIR) and skips with a note
    without it. test runs kilib's tests (--changed through tpm test changed), lint adds fmt
    and clippy, install builds kilib and puts it on PATH. install does not call kilib setup
    yet: that waits for the new library layout.
2026-11-04 kilib setup: rows from a rename map or the folders found; VHRD_VENDOR_LIBRARY_DIR and VHRD_3DMODEL_DIR
    With the layout agreed, the library rows come from --map's [libraries.symbol] and
    [libraries.footprint] tables (or else from the library folders of the checkout and the
    vendor library), through ${VHRD_LIBRARY_DIR} and ${VHRD_VENDOR_LIBRARY_DIR}; nothing is
    hard-coded. Every vhrd_*/VHRD_* row is replaced. --vendor-dir and --models-dir set
    VHRD_VENDOR_LIBRARY_DIR and VHRD_3DMODEL_DIR, each left alone when not given. A row whose
    folder does not exist yet, or whose variable this run does not set, gets a note. The
    template variables stay: 11 hw projects use ${VHRD_TEMPLATE_DIR} for their sheet.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
2026-11-04 migrate/2026-11.toml: the rename map for the kind-first layout
    Every symbol (176), footprint (173) and 3D model path (106) of today's
    library mapped to its VHRD_<KiCad library> home. Third-party footprints
    and symbols (Ultra Librarian and SamacSys exports, unclear DigiKey-sourced
    ones) go to the private VHRD_Vendor library; models to own/ or vendor/
    under VHRD_3DMODEL_DIR.
2026-11-04 migrate/2026-11.toml: old library names only boards still use
    vhrd_connector_abracon and vhrd_connector_battery (symbols) and the
    vhrd_cristal typo (footprints) exist only in hw boards; they now map to
    VHRD_Connector and VHRD_Crystal.
2026-11-04 kilib migrate and kilib restructure: the new library layout, byte for byte
    kilib migrate --map FILE PATH... rewrites boards through the rename map and changes only the strings it matches:
    symbol ids (lib_id, lib_name, the lib_symbols cache), Footprint fields, ki_fp_filters entries, footprint ids,
    ${VHRD_3DMODEL_DIR} model paths and the old vhrd_* rows of project library tables. Edits are byte ranges in the
    original text (for an id only the library part), so every other byte stays; the unified diff is made from the same
    edits and applies with git apply. A dropped footprint in use or a cache name clash is an error and blocks --write.
    kilib restructure --map FILE --vendor-dir DIR builds VHRD_*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
2026-11-04 VHRD_Connector: ARJM11D7-114-AB and BAT-HLD-001-THM recovered from the boards' symbol caches, map rows for them and vhrd_connector_debug:TC2050-IDC-NL
    Boards use vhrd_connector_abracon:ARJM11D7-114-AB and vhrd_connector_battery:BAT-HLD-001-THM, which no library had: they existed only in the schematics' lib_symbols caches (b125a/b, b196a; one version each). They differ from the library's 'Abracon ARJM11D7-114-AB' and 'TE BAT-HLD-001-THM' in graphics, pin placement and fields, so they come back as symbols of their own under their cache names. vhrd_connector_debug:TC2050-IDC-NL (7 sheets, three cached versions) has the same pins as vhrd_connector:TC2050-IDC-NL and differs only in its descriptio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
2026-11-04 Footprints: no C:/Users model paths
    B0505MT-1WR4's second model pointed at a copy in a Windows checkout; it now goes through ${VHRD_3DMODEL_DIR} like the first, so the map moves it with the rest. Harting 09551667812741 pointed at a download that never reached the library or the model folder, and no board uses the footprint: the model line goes. TEST keeps its path; the map drops that footprint.
2026-11-04 The library in the new layout: kilib restructure with migrate/2026-11.toml
    Symbols are KiCad 10 .kicad_symdir libraries (one file per symbol), footprints VHRD_*.pretty, both sorted by kind like KiCad's own libraries. The 37 third-party footprints and 8 symbols went to the private VHRD_Vendor library (VHRD_VENDOR_LIBRARY_DIR); the unused TEST and _TEMPLATE footprints are dropped. Model paths and Footprint fields are rewritten by the map; every other byte is as it was.
2026-11-04 3dmodels/ and keymaps/ out of the repo
    Every 3D model is in the models folder VHRD_3DMODEL_DIR points at (own/ and vendor/, under the paths the map gives); the four SolidWorks sources KiCad cannot read are dropped. keymaps/ was someone else's hotkey set.
2026-11-04 Templates: KiCad's stock copies and the sheet copies out, the kept ones on the new library names
    RaspberryPi-HAT, RaspberryPi-uHAT and STM32_Nucleo-64_Morpho were byte-identical to KiCad 9.0.0's stock templates, which KiCad ships. templates/default, default/ and the vhrd_a4/vhrd_a3 sheet copies go: vhrd-kicad is the only source of the look, and the kept templates embed their sheets. kilib migrate --write moved Vhrd Default, IO30 and Hammond-1455C801 to the VHRD_* libraries; kilib check resolves all 130 of their references.
2026-11-04 justfile: look adopts the three kept templates and colours VHRD_power, test checks the templates' embedded sheets
    No sheet copies any more: look runs vhrd-kicad power-colours on VHRD_power.kicad_symdir and adopt --power on Vhrd Default, IO30 and Hammond-1455C801. test exports each of them, schematic and board, and wants the VHRD sheet in the PDF.
2026-11-04 LICENSE.md: CC-BY-SA 4.0 with KiCad's library exception
    The same licence and exception as KiCad's own libraries: anyone can use
    the parts in closed or commercial designs; the library itself stays
    share-alike, as the footprints adapted from KiCad's libraries must. Evgeniy
    Isaikin, who made 14 of the commits on Roman's behalf, agrees.
2026-11-04 just look: the three templates and VHRD_power from vhrd-kicad 0.9.9 (ee2c041), boards with the embedded A4 sheet
    adopt --power embeds the A3 sheet in each schematic and sets the net class colours; adopt does not touch the board, so look also embeds the A4 sheet from vhrd-kicad gen (written to /tmp, never into the repo) into each .kicad_pcb. Hammond's project had no board sheet set: its pcbnew page_layout_descr_file now names the embedded sheet, as IO30's and Vhrd Default's already did. IO30's board lost its old 'veryhard.tech' sheet. A second look changes nothing.
2026-11-04 README for outside users, VHRD branding, LIB-9 done
    README.md: what the library is, the VHRD_<KiCad library> layout, setting
    it up (kilib setup or by hand), migrating an older board, and the
    licence. Templates' meta/info.html titles and copyright say VHRD and
    vhrd.tech, not Vhrd.Tech (and IO30's info page gets its own title and a
    fixed <body> tag). just deploy is a plain git pull instead of a tpm
    command. kilib's test fixtures use a generic C:/Users/someone path. The
    CHANGELOG's ticket-id parenthetical is gone. FEATURES LIB-9 done.
2026-11-05 just look: VHRD_power and the templates in the rail colours of vhrd-kicad 0.9.10
2026-11-05 VHRD_TestPoint: TestPoint_Pad_D1.2mm footprint, used by B153A
2026-11-06 VHRD_Power_Protection:TPD6S300A from KiCad's stock symbol, regrouped, Mpn1 / Mpn2
    Each connector-side pin faces its system-side pin on one row; the pins come
    in groups by kind (CC, SBU, D, RPD) with a free row between them. Pins 16 /
    17 are visible as NC/D3 and NC/D4: N.C. on the TPD6S300A, the D4 / D3 ESD
    channels on the pin-to-pin TPD8S300A (Mpn2, VPWR at most 3.6 V). Only the
    grounds and the pad are stacked under one GND pin.
2026-11-06 VHRD_Connector_USB: USB4105 shield pads numbered SH instead of S1, saved with KiCad 10
2026-11-06 VHRD_Connector:USB_C_Receptacle_USB2.0_16P, KiCad 10's stock symbol with the USB4105 footprint and Mpn1
    KiCad 10 renumbered the shield pin S1 -> SH in its stock symbol and
    footprints; a copy here keeps the symbol in step with the VHRD USB4105
    footprint (SH since c193f37). Geometry unchanged from stock.
2026-11-06 VHRD_Logic_LevelTranslator: LSF0102DCUR (VSSOP-8) and NVT2002DP (TSSOP-8) with PCA9306 alternates
    All four parts (TI LSF0102, TI and NXP PCA9306, NXP NVT2002) share pinout 1 GND,
    2 VREF_A, 3 A1, 4 A2, 5 B2, 6 B1, 7 VREF_B, 8 EN, but NVT2002 comes in no
    package LSF0102 does, so there are two symbols with one drawing:
    LSF0102DCUR on VSSOP-8 (LSF0102DCUR, PCA9306DCUR, PCA9306DC1Z) and NVT2002DP
    on TSSOP-8 (NVT2002DP,118, PCA9306DP,118). Stock footprints with KiCad's 3D
    models. PCA9306DC1Z, not PCA9306DC1,125, which NXP discontinued.
2026-11-06 VHRD_Logic_LevelTranslator: SN74LXC2T45DCUR with SN74LVC2T45DCUR and 74LVC2T45DC alternates
    One VSSOP-8 pinout (1 VCCA, 2 A1, 3 A2, 4 GND, 5 DIR, 6 B2, 7 B1, 8 VCCB)
    across TI LXC/LVC/AVC/AXC 2T45 and Nexperia LVC/AVC 2T45, checked in each
    datasheet. Listed as MPNs: the 5.5 V parts (LXC 1.1 V up, TI LVC 1.65 V,
    Nexperia LVC 1.2 V); the LVC parts lack the LXC's pull-downs, so DIR must be
    driven. AVC and AXC (3.6 V max) only in the Description.
2026-11-06 VHRD_Logic_LevelTranslator: SN74LXC2T45DCUR, SN74LVC2T45DCUR and 74LVC2T45DC as separate symbols
    Their lowest supply differs (1.1, 1.65 and 1.2 V) and only the LXC has
    pull-downs on DIR, so they are not alternates of one part: one MPN each.
2026-11-06 VHRD_Logic_LevelTranslator: SN74AVC2T45DCUR and SN74AXC2T45DCUR
    The 2T45 family on VSSOP-8, one symbol per part like LXC and LVC:
    AVC 1.2-3.6 V (I/Os 4.6 V tolerant, DIR must be driven), AXC 0.65-3.6 V
    (71 kOhm pull-downs on the data I/Os).
2026-11-06 VHRD_Logic_LevelTranslator: LSF0102, PCA9306 (TI, NXP VSSOP and TSSOP) and NVT2002 as five symbols
    Their reference voltage ranges differ (TI PCA9306 VREF1 1.2 V to VREF2 - 0.6 V,
    NXP PCA9306 all pins up to 5 V with VREF1 at least 1 V below VREF2, NVT2002
    VREFA up to 5.4 V, LSF0102 0-5.5 V), so they are not alternates of one part:
    one MPN each, and each symbol with its datasheet's pin names.
2026-11-07 VHRD_TestPoint: TestPoint_Pad_0.8x0.8mm, a square 0.8 x 0.8 mm SMD test pad
2026-11-07 Side-pin symbols for B153 and VHRD_Vendor folded into the library
    - Every pin on the left or right edge: TPD6S300A, USB_C_Plug,
    USB_C_Receptacle_USB2.0_16P, LSF0102DCUR, SN74LXC2T45DCUR and AP64060 in
    place; side-pin copies of the stock STM32G0B1CETx, USB2514B_Bi, INA181,
    TS5A3160DCK, TXS0102DCU, D3V3XA4B10LP and TLV70233_SOT23-5.
    - STM32G0B1CETx names its pins as DS13560 Table 12 prints them (PF2-NRST,
    PA14-BOOT0, PA11[PA9], OSC and VDDA/VSSA), with the UCPD dead-battery
    CC/DBCC pins and the N part's VSS/VDDIO2 on pins 30/31.
    - The private VHRD_Vendor library is gone: its footprints and symbols sit in
    the library their kind belongs to (new VHRD_Button_Switch_THT), cleaned of
    v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
2026-11-07 Footprints follow the board's mask and paste rules; b135 tweaks moved in
    - Drop the vendor-export 0.102 mm solder mask margin (128 pads on 13
    footprints), the 0.2 / -0.01 mm margins on 009155005741006 and AXF382700
    and the forced 0 paste ratio on SOT-723 and SOT-883. Deliberate overrides
    stay (Tag-Connect, BGA and module mask, paste windows, fine pitch).
    - From b135: paste ratio +1 % on the Kemet relay, +5 % on 750315125, -5 % on
    pad 1 of D_SMA_BIDIR, 0.4 mm clearance on ID09P33E4GV00LF shell and pin 5.
2026-11-07 Footprints re-saved by KiCad 10 (kicad-cli fp upgrade), format only
    So later edits made by tools show only their own changes.
2026-11-07 Courtyards from the STEP models, one pin-1 mark per polarized footprint
    - F.CrtYd of the 128 footprints with a STEP model rebuilt from the model's
    top view plus pads, grown by the KLC F5.3 clearance; mating room kept on
    the sides where the old courtyard reached further. Connectors get their
    full top view on User.2. VHRD_Mechanical and VHRD_Module keep theirs.
    - A filled silk triangle next to pin 1 on every polarized footprint (KLC
    F5.1); diodes and LEDs keep cathode bars and arrows, bidirectional TVS
    get no mark. Made by hw/tools/footprint_tools.
2026-11-07 Fab layer shows only the reference
    Value hidden on F.Fab (still a property for BOMs); one ${REFERENCE} at the
    body's centre sized to fit (0.25 to 1.0 mm), turned along tall bodies.
    Made by hw/tools/footprint_tools/fabref.py.
2026-11-07 STM32G0B1CETx: alternate pin functions named with their port pin (PA9/USART1_TX)
2026-11-07 STM32G0B1CETx: GPIO modes as alternates on every port pin (PP, OD, IN, FX)
2026-11-07 STM32G0B1CETx: bootloader pin states (H, OD, PU, PD, I) beside the pins; reset-time pins (BOOT0, NRST, SWDIO, dead-battery DB/DBC) named in every alternate
2026-11-07 STM32G0B1CETx: Rd marker on PA8 and PB15, the ROM bootloader's UCPD1 sink Rd; legend credits the ROM
2026-11-08 STM32G0B1CETx: PC13-PC15 marked SK, sink only through the VBAT switch; legend notes LSE survives resets
2026-11-08 USB2514B_Bi: reset-time pin markers (S, PD, PU, RC, !) and a legend of the hub's gotchas; pins regrouped by port
2026-11-08 TS3USB221A, USB3315, USB4604-1080HN-TR: resaved by KiCad 10's symbol editor (format only)
2026-11-08 CHANGELOG: Unreleased cut to the facts (164 to 85 lines)
2026-11-08 VHRD_Diode:BAS40-02L on a new D_TSLP-2-1 footprint from Infineon's land pattern
2026-11-08 VHRD_power:+3V8_DCDC; INA181 back to KiCad's stock drawing
2026-11-09 VHRD_Logic_LevelTranslator:SN74LXC1T45DCKR: Mpn2 SN74AXC1T45DCKR dropped (I/O abs max 4.2 V, io_protection s23 lets 4.35 V through)
2026-11-09 VHRD_Logic_LevelTranslator: A↔B arrows and DIR / EN meaning on SN74LXC1T45DCKR and LSF0102DCUR, VREF_B bound on LSF0102DCUR
2026-11-09 Add BZX585 Zeners, PESD ESD diodes and NX3020NAKS
    VHRD_Diode on D_SOD-523: BZX585-C5V1/C5V6 (Mpn2 BZT52C5V1T-7/BZT52C5V6T-7),
    PESD3V3S1UB/PESD5V0S1UB unidirectional ESD (Mpn2 ESD5Z3.3T1G/ESD5Z5.0T1G),
    PESD3V3U1UB 2.6 pF. VHRD_Transistor_FET: NX3020NAKS dual N-MOSFET from stock
    Q_Dual_NMOS_S1G1D2S2G2D1 on stock SOT-363_SC-70-6. Pinouts checked against
    the datasheets.
2026-11-09 Add PESD2CANFD24V-T dual CAN FD TVS
    VHRD_Power_Protection from stock NUP2105L (SOT-23, pins 1/2 IO, 3 GND).
    Mpn1 PESD2CANFD24V-TR (Nexperia), Mpn2 ESD2CANFD24DBZRQ1, Mpn3
    ESD2CANFD24DBZR (TI, same pinout, VRWM and VBR window; 2.5 pF typ).
2026-11-09 Add RB751S40 Schottky
    VHRD_Diode on D_SOD-523, from the BAS40-02L symbol. Mpn1 RB751S40,115
    (Nexperia, 120 mA), Mpn2 RB751S40T1G (onsemi, 30 mA DC). Pin 1 cathode
    in both datasheets.
2026-11-10 SOIC4_DFG_TEX: larger pin-1 mark with a "1"
    ISOM8600 footprint: pin-1 triangle 0.87 x 0.6 mm (was 0.48 x 0.33), a
    0.8 mm "1" on F.SilkS next to it, courtyard grown to cover both.
2026-11-10 kilib fab-designators: designator on the fab layer only, clear of every pad
    Checks each footprint's Reference: on F.Fab (B.Fab for bottom parts), visible, unlocked, no ${REFERENCE}
    on silk and no second one on fab. Sizes it (0.25-1 mm) from the ink box of a four-character designator in
    KiCad's stroke font, as pcbnew measures it (off-centre from the anchor), so it stays 0.1 mm off every pad:
    inside the body at 0 or 90 degrees, else next to it, level and centred above where it can. A footprint
    that already follows the rules is left alone; --write rewrites only the Reference and the ${REFERENCE}
    texts, in KiCad's own format.
2026-11-10 Footprints: designator only on F.Fab, never over a pad
    kilib fab-designators --write over all 174 footprints: 172 changed, 2 skipped (HAMMOND_1455C801 and
    RoHS-Logo_6mm_SilkScreen have no fab outline, courtyard or pads). 26 have no room inside the body clear
    of the pads and carry it next to the body. Checked with pcbnew's own text and pad boxes (all 172 at least
    0.09 mm off every pad), every library loads in kicad-cli fp upgrade, and KiCad re-saves the files byte
    for byte. Silkscreen, pin-1 marks and Value untouched.
2026-11-10 docs: [Unreleased] entries after landing
2026-11-10 kilib fab-designators: never over a pad or across the fab outline; library re-swept
    The text box is now a five-character designator (R1234, the library's
    REF**) with its stroke, as kicad-cli plots it; inside the body it stays
    within the stroke of the outline's lines; a body within the pads' box
    (chip passives, QFNs) puts it outside the pads, shrinking where needed.
    72 of 174 footprints moved their designator.
2026-11-10 Stock footprints copied in: kilib stock import/diff, B153's 21 footprints, migrate/2026-11-stock.toml
    KiCad stock footprints a board uses now live in VHRD_* libraries of the
    same name, designator on F.Fab and Value hidden, all else as in KiCad
    10.0.8, so a KiCad update never changes them unannounced. kilib stock
    diff shows what a fresh import of the current stock would change.
    New libraries VHRD_Resistor_SMD and VHRD_Connector_PinSocket_2.54mm get
    rows in 2026-11.toml; 2026-11-stock.toml re-points boards (only
    footprint lib ids). The body-within-pads rule now counts only pads over
    the body, so QFPs keep their designator inside (STM32H7R3V8T6,
    TI-PFB0048A back inside). LIB-11.
    Co-Authored-By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
2026-11-10 kilib fab-designators: a pad counts as over the body only when it reaches 0.1 mm in
    Stock LQFP pins reach a hair into the fab outline, which sent LQFP-48's
    designator outside; QFP and SOIC text stays inside again, chip passives
    and QFNs keep it outside the pads.
2026-11-10 kilib fab-designators: designator centred on the body, clear of the fab drawing; fab lines 0.05 mm; Value hidden
    Pads no longer push the designator outside: KiCad draws the selected fab
    layer on top. It shrinks (1 to 0.3 mm), turns 90°, else moves to the
    largest free spot in the body; where nothing fits it stays centred at
    0.3 mm and is reported as no clean fit.
2026-11-10 Library re-swept: designators centred on the body, fab lines 0.05 mm, Values hidden
    kilib fab-designators --write: 185 of 195 footprints changed (112 moved,
    101 resized, 54 turned); 21 have no clean fit, 2 skipped (no outline).
2026-11-10 kilib: designators measured in KiCad's stroke font, board mode, designator layers
    - stroke: glyph advances and ink of KiCad's newstroke font (printable ASCII) and pcbnew's line layout; the ink box of
    R806, U1004, REF** and others matches kicad-cli fp export svg to 0.5 um.
    - fab-designators: the ink (not the anchor) centred on the body; a library footprint sized for the longest designator
    of its kind (R1004, C1001, TP526, JP104, U1004); 0.02 mm free beyond the strokes; sizes down to 0.2 mm (0.01 steps
    below 0.3), 0.15 mm for the smallest parts (reported as tiny); strokes 15 % of the size, at least 0.025 mm; the size
    distribution in the report.
    - fab-designators --board PCB: each footp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
2026-11-10 Library re-swept: designators measured in the stroke font, sized for five characters, 0.2 mm floor; test points, net ties and mechanical parts on their own layers
2026-11-10 docs, extended test: board designators and layers (LIB-12, LIB-13), LIB-10 updated
    The extended test fits every board's designators and names the layers on a temporary copy of the boards: only the
    Reference's at/size/thickness and the layer table change, and a second run changes nothing.
2026-11-10 kilib lint: footprint rules for pin-1 marks, attributes, courtyards, 3D models and silkscreen
    One command, a report by default and the fixes with --write. footprint.rs reads a
    .kicad_mod into pads (as copper shapes), drawing per layer, texts, attributes and
    models, with byte spans so a fix rewrites only its items. Stock imports and
    stock diff apply the same fixes, so diff still shows only upstream changes.
2026-11-10 docs: kilib lint in README, AGENTS, FEATURES LIB-14..18, CHANGELOG; just check-footprints
2026-11-10 kilib lint silk: pin numbers on the silkscreen named as such
2026-11-10 Footprints swept by kilib lint: silkscreen, courtyards, attributes, model paths, pin-1 marks
    121 of 195 footprints; 7 designators refitted by kilib fab-designators after it.
    Both tools now find nothing to change; every changed library exports with kicad-cli.
2026-11-10 Reference layers drawn: kilib lint ref-outline; fab-designators fits the designator to that drawing
    Test points get a circle on the pad outline (+0.05 mm), or a rectangle for a pad that
    is not round; net ties, spark gaps and jumpers a rectangle round their pads; 0.05 mm
    strokes on their Ref.Test / Ref.Tie layer. fab-designators takes that drawing as the
    body (centred inside, smaller, else 0.3 or 0.2 mm beside it, nearest).
2026-11-10 kilib stock: symbols too: import --symbols (standalone, VHRD fields), diff compares them under our fields
    Stock symbols a board uses become VHRD_Lib:Name copies like the footprints:
    a derived symbol gets its parent's pins, units and graphics under its own
    name and fields, the Footprint field points at our copy where the library
    has one, library parts of ki_fp_filters get VHRD_, an empty Mpn1 is added.
    stock diff lays a copy's fields and flags over a fresh import, so it shows
    only what stock changes in pins, units, graphics and new fields; a kind
    whose stock folder is missing is skipped with a note.
2026-11-10 Stock symbols copied in: b153a's 19 stock symbols, Mpns and flags; R, C, Conn_02x03_Odd_Even, PWR_FLAG mapped to our own
    kilib stock import --symbols from KiCad 10.0.8: Device (SparkGap, NetTie_2,
    D_Schottky, D_Zener, L_Iron, Crystal_GND24), Connector (TestPoint,
    TestPoint_Probe, Conn_01x12_Pin), Diode (BAS16TW, BAT54CW, BAT54S, SMF22A),
    Mechanical:MountingHole, Regulator_Linear:TLV75533PDBV and the new
    VHRD_Transistor_BJT (BC847BS, BC847BPN), VHRD_Amplifier_Operational
    (TLV9061xDCK) and VHRD_74xGxx (74LVC1G17). Derived symbols are standalone.
    The specific parts carry b153a's Mpns; 74LVC1G17 defaults to the DCK
    footprint. Test points, net tie, spark gap and mounting hole are out of
    BOM and s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
2026-11-10 kilib layers: Value, Pins, Centroid pairs (User.17-22), Dimensions, Fab.Notes, Body.F names; refuse KiCad 8 numbering (LIB-20)
    KiCad 8 boards number the layers otherwise (B.Cu 31): matching by number renamed
    User.6 to a second User.9. User.2 keeps its plain name where a board draws on it.
2026-11-10 kilib fab-designators: the Value on Value.F/B, shown, fitted beside the designator; --board fits each real value (LIB-21)
    The Value is laid out like the designator for a long value of its kind (100k,
    4.7uF, TPS54202DDC), the designator's ink one more obstacle; a body too small for
    both puts it just outside (0.3/0.2 mm), crossing the designator is the last resort.
    Stock imports no longer hide the Value.
2026-11-10 Footprints: Value on Value.F/B, shown, fitted beside the designator (193 of 195, kilib fab-designators --write)
2026-11-10 kilib lint: pins (numbers beside the pads on Pins.F/B) and centroid (a cross on the origin on Centroid.F/B) (LIB-22, LIB-23)
    Pins: every pin of a connector, pin 1 and every 5th (10th past 40) of other parts
    with three or more pins; level text 0.1 mm clear of pads and each other, one size
    per footprint, never between two pads in line. Centroid: 0.5 mm cross, 0.05 mm,
    for parts and fiducials.
2026-11-10 kilib lint pins: holes kept clear, a pad on numbered copper (USB-C B12 on A1) gets no number of its own
2026-11-10 Footprints: pin numbers on Pins.F (125) and a centroid cross on Centroid.F (163), kilib lint --write --rule pins,centroid
    Three numbers sets have no room (USB4110 B pins, SQFN-48 pin 25, TI-BQA0014A pin 15): kilib lint lists them.
2026-11-10 docs: Value, Pins, Centroid layers and the renamed KiCad layers (LIB-20..23): AGENTS, README, FEATURES, CHANGELOG
    The footprints left without room for some pin numbers are PLUG-USBC-241SMT-TH-4BC2LS,
    QFN24_MICROCHIP and TI-BQA0014A (the sweep commit named them wrongly).
2026-11-11 Photorelay_1A_SOP-4 symbol and SOP-4_4.4x4.3mm_P2.54mm footprint for B153B's U701
    One 1 Form A MOSFET photorelay that several makers build, to replace the
    single-source ISOM8600: Mpn1 VO1400AEFTR, Mpn2 AQY282SX, Mpn3 G3VM-61VY2(TR),
    Mpn4 AB37S, Mpn5/6 ISOM8600DFGR/ISOM8610DFGR, a datasheet field each. The symbol
    comes from stock AQY282S (kilib stock import --symbols), made standalone.
    The footprint takes stock SO-4_4.4x4.3mm_P2.54mm's body, silkscreen and 3D model
    with pads that serve every maker's land pattern, TI's DFG included: 1.4 x 0.8 at
    x +-3.2, 5.0 mm input-output gap. Stock's 1.2 mm pads end at 3.6 mm, short of the
    Vishay and TI lead tips (up to 3.65). kilib lint and fab-designator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
2026-11-11 Fix RUK0020B EP mask bridge; move stock footprints off KiCad's 3D package
    The thermal pad's F.Mask opening matched its copper exactly (no margin),
    bridging the solder mask to every perimeter pad at this part's 0.4 mm
    pitch (33 DRC findings across U401/U501 on b153a). solder_mask_margin
    -0.05 shrinks the opening 0.05 mm inside copper, TI's own "solder mask
    defined" option for this land pattern (RUK0020B package drawing);
    confirmed 0 bridges left against a scratch copy of the board.
    Every stock-imported footprint's 3D model moved from
    ${KICAD10_3DMODEL_DIR} to ${VHRD_3DMODEL_DIR}/vendor/... (54
    footprints, 47 distinct models), so no footprint depends on KiCad's
    stock 3D package, which isn't i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
2026-11-11 kilib: Ref.Des layer (User.23/24) for real parts' designators, Value centred on its own; kilib designators
    F.Fab/B.Fab keep only the drawing. A real part's designator moves from the fab layer to Ref.Des, its Value is
    centred on the body like the designator (sized for the longest typical value of its kind) instead of beside it;
    test points, net ties and mechanical footprints keep their Value hidden on the fab layer. --board fits both, each
    to its own text. fab-designators is renamed designators, the old name kept as an alias.
2026-11-11 kilib designators: mechanical footprints without a body keep their texts where they are
    A logo or enclosure without fab outline, courtyard or pads was skipped; its designator and Value only move to
    their layer, hidden, so no body is needed.
2026-11-11 Library: designators of real parts on Ref.Des, values centred on Value, Fab carries the drawing alone
    kilib designators --write footprints (196); the three templates name User.23/24 Ref.Des.F/B (kilib layers
    --write). L77SDE09SA4CH's "PCB Edge" note moves from F.Fab to Fab.Notes.
2026-11-12 Oscillator_SMD_ECS-4Pin_3.2x2.5mm_1: no pin-1 mark, the crystal is symmetric under 180°
2026-11-12 CHANGELOG: crystal footprint without pin-1 mark
2026-11-12 VHRD_Transistor_FET:BSS138W, multi-source N-MOSFET in SOT-323
2026-11-12 kilib check --only PREFIX: flag symbols, footprints, embedded symbols and filters from other libraries
2026-11-12 Stock footprints the symbols named, imported; stock import takes models from the vendor folder
    The 13 stock footprints VHRD symbols still named, VSSOP-10 from the last stock
    version (it left KiCad in Jan 2026), and b153a's solder jumper with its symbol.
    kilib stock import and stock diff write the model path the library uses for
    its copies of KiCad's models (${VHRD_3DMODEL_DIR}/vendor/VHRD_<Lib>.3dshapes).
2026-11-12 Symbols name only VHRD footprints and filter libraries; a test keeps it so
    37 Footprint fields moved from stock to the VHRD copies with the stock map,
    43 ki_fp_filters patterns prefixed VHRD_, 14 Footprint fields of TI parts
    fixed to the footprints that exist. tests/decoupled.rs runs check --only
    VHRD_ over symbols/ and footprints/ against the checkout's own rows.
2026-11-12 Rename maps: [filter_lib] for ki_fp_filters libraries; LIB-25 stock-decoupled
    The stock map moves Connector*, LED_SMD and LED_THT filters, which b153a's
    embedded symbols still had. README, AGENTS and FEATURES say the library
    names no stock library and how that is checked.
2026-11-13 switch: review
2026-11-13 kilib: [per_package] map tables, kilib per-package, migrate by placed footprint
    A generic symbol (Footprint empty) placed with a footprint moves to the
    symbol made for that package, so whatever is keyed by the library symbol
    (berc's footprint review) covers it. kilib per-package makes the derived
    symbols a map names and lists a board's placed generics by footprint;
    kilib migrate moves the placed symbols and gives the schematic's cache a
    copy of the generic under the new name. A map without [model] no longer
    warns about every model path.
2026-11-13 Per-package symbols for b153a's generic parts (LIB-26)
    22 symbols derived from VHRD_Device and VHRD_Connector generics, each with
    its footprint set, named in migrate/2026-11-packages.toml; README, AGENTS,
    FEATURES and CHANGELOG say how they are made and used.
2026-11-13 kilib per-package: the derived symbol takes its generic's file header
    KiCad reads a symbol file's fields by its version: a derived file that
    said 10.0 while carrying 9.0-style fields (hide inside effects) read
    differently from the generic, and ERC flagged every moved R, C and LED as
    lib_symbol_mismatch. The 10 symbols of KiCad 9 generics are made again.
2026-11-13 LQFP-48 / UFQFPN-48 combined footprint, LQFP and UFQFPN paste variants
2026-11-13 kilib model chip: STEP models of chip passives from data (LIB-27)
    kilib::step writes AP214 STEP files of coloured convex prisms (closed B-rep,
    one STYLED_ITEM per solid, as KiCad reads its own models); kilib::chip holds
    the table types for generate/chip-passives.toml and generate/power-inductors.toml,
    the footprint names (C_0805_2012Metric_H1.25, L_Shielded_4.0x4.0mm_H2.0) and
    the model shapes per body style. Checked with kicad-cli pcb render: KiCad
    reads the solids and their colours.
2026-11-13 kilib footprint chip: footprints per size and height from the chip tables (LIB-28)
    A chip part's footprint is its size's base (checkout copy, else a fresh stock
    import) renamed, with descr and the generated model; a power inductor's is
    drawn from its table row and finished by stock::import_into (lint fixes,
    designator and Value). Only new files are written.
2026-11-13 VHRD_Device:L from stock; chip tables kept in step with footprints and the packages map
    The generic inductor symbol for chip inductors' per-package symbols (Footprint
    empty, mapped in 2026-11-stock.toml). tests/chip_tables.rs checks that every
    size and height of generate/*.toml has its footprint with the generated model
    and its per-package symbol line, and prints the missing lines.
2026-11-13 Chip R, C and L footprints per size and height, with per-package symbols (LIB-28)
    34 footprints from generate/chip-passives.toml (kilib footprint chip, stock
    IPC-7351 nominal lands) and their 34 per-package symbols (VHRD_Device:C_0805_H1.25
    ...) in migrate/2026-11-packages.toml. 1210 C gets 1.25 too (TDK and Yageo);
    wire-wound chip inductors take the row's colour (LQH/NLV are ferrite).
2026-11-13 FEATURES LIB-28 and CHANGELOG for the chip footprints
2026-11-13 generate/power-inductors.toml: power-inductor bodies and lands (LIB-29)
    Seven Shielded bodies (2.0x1.6 to 8.0x8.0) and ten Molded ones (2.0x1.6 to
    7.1x6.5), each with the heights sold, the bottom electrode for the 3D model,
    the land it takes from one maker's datasheet and the series that fit it.
    Read from Sunlord, Taiyo Yuden, Bourns, TDK, Murata, Coilcraft, Würth and
    Cyntec datasheets; the table for kilib chip footprints and models.
2026-11-13 Power-inductor footprints, models and per-package symbols (LIB-29)
    68 footprints over 17 shielded and moulded bodies from
    generate/power-inductors.toml (power-l-table's research, makers' lands),
    drawn by kilib footprint chip and finished by the lint fixes and designators;
    their per-package symbols on VHRD_Device:L_Iron. LIB-27/28/29 done.
2026-11-13 kilib 0.2.0 for the kicad-library 0.2.0 release
2026-11-13 kilib: current-sense shunts from generate/current-sense.toml: maker's land, shunt model style
    A [[shunt]] row is one size, one land (pad length, width, gap) and its heights;
    the footprint is drawn from the row like a power inductor's (both now go through
    one two-pad drawer) and the model shows the metal element under a black coat
    between long terminations.
2026-11-13 kilib: shunt lands computed with IPC-7351B nominal rules, kilib footprint shunts
    The makers' long lands carry heat-spreading copper out past the part, which a
    board's own pour does better. A [[shunt]] row now gives the body and the
    termination length of one series and resistance range (nominal and
    tolerances), and kilib::ipc computes the land the way KiCad's generator makes
    the stock chip lands (it reproduces R_0805 and R_1206). Rows of one size whose
    lands are within 0.05 mm share one; heights within 0.1 mm merge upwards. The
    maker's land goes into the description. kilib footprint shunts prints the table.
2026-11-13 generate/current-sense.toml: shunt bodies and terminations per range
    Vishay WSL/WSLP/WSLT/WSLS, Yageo PE, PE_L and PA, Bourns CRF/CRA, TT LRMAP,
    Rohm GMR100 and Isabellenhütte SMS, 0603 to 2512, with each maker's land for
    reference.
2026-11-13 Current-sense resistor footprints, models and per-package symbols (LIB-30)
    42 footprints from generate/current-sense.toml with IPC-7351B nominal lands
    (gap at least 0.30 mm; Vishay's 0.635 mm height written 0.64), their
    per-package symbols on VHRD_Device:R and the map lines. Models written into
    ${VHRD_3DMODEL_DIR}/generated/VHRD_Resistor_SMD.3dshapes/ (new files only).
2026-11-13 kilib 0.3.0 for the kicad-library 0.3.0 release
2026-11-13 kilib lint pin1: footprints tagged symmetric want no pin-1 mark; the ECS crystal and the BIDIR diodes tagged
2026-11-13 kilib chip::led: chip LEDs in the LED's colour, see-through lens solids in kilib step
    chip::led (own module) reads [[led]] rows of generate/chip-leds.toml: a size in one height and its colours.
    Each colour becomes a footprint (the stock IPC land with the _Arrow silkscreen) and a model: a white board
    with gold ends, a die, and a lens in the emission colour. A water-clear lens is see-through
    (SURFACE_STYLE_TRANSPARENT, which KiCad 10 renders); a white LED's phosphor lens is opaque yellow.
    kilib::step::Solid gains a transparency field.
2026-11-13 VHRD_Device: LED_Yellow, LED_Blue and LED_White generics, as LED_Red with their colour
2026-11-13 kilib chip: the led table defaults to empty, as after the merge with the shunts it did not
2026-11-13 Chip LED footprints, models and per-package symbols, 0402 and 0603 in six colours (LIB-31)
    generate/chip-leds.toml: eight heights from LiteOn, Kingbright, OSRAM and Würth drawings, each in red, orange,
    yellow, green, blue and white: 48 footprints (the stock land with the _Arrow silkscreen) and per-package
    symbols on VHRD_Device:LED_<Colour>. The models went to ${VHRD_3DMODEL_DIR}/generated/VHRD_LED_SMD.3dshapes.
    LED_Red_0603 and LED_Green_0603 are removed; b153a moves LD201/LD202 by hand.
2026-11-13 kilib 0.4.0 for the kicad-library release with the chip LEDs
2026-11-13 Footprint review fixes: STM32G0 LQFP-48 lands, AOZ DFN-12 corner pads, RUK0020B pad length, SOT-23_CANFD-ESD for PESD2CANFD24V-T / ESD2CANFD24
2026-11-13 CHANGELOG: footprint review fixes
2026-11-14 kilib migrate: [footprint_rename] renames a footprint, [symbol_footprint] gives a symbol's placed parts another footprint; kilib 0.5.0
2026-11-14 TI footprints named TI_<designator>_<generic>, new TI lands for TI parts on generic footprints, migrate/2026-11-ti.toml
    Renames 15 TI footprints (Texas_UQFN-10 merged into TI_RSE0010A), fixes the PW0008A,
    RUC0014A and DCK0005A lands against TI's drawings, adds DBV0005A, DCU0008A, RGT0016A,
    DDA0008B and DFG0004A from TI's example board layouts, and points the TI symbols at them.
2026-11-14 AGENTS.md: how TI footprints are named and built
2026-11-14 kilib lint --rule layout: empty Layout_Critical/Layout_Important properties on Crit/Imp for every real part, written across footprints/
2026-11-14 kilib designators --board: a Layout_Critical or Layout_Important note that is set is fitted to its own text on Crit/Imp
2026-11-14 kilib layout-fields: empty, hidden Layout_Critical/Layout_Important on library symbols and placed schematic symbols; written across symbols/ (power symbols excepted), stock symbol imports get them
2026-11-14 kilib designators --board: a set layout note KiCad left hidden on the fab layer moves to Crit/Imp, shown
    Update PCB from Schematic creates a field the footprint lacks hidden on F.Fab, and Update Footprints from Library
    keeps the board's layer, so such a note would never show.
2026-11-14 kilib presets: PCB Editor layer presets from generate/layer-presets.toml into board.layer_presets
    Layout.F/B, Assembly.F/B, Pins.F/B, Silk.F/B; replaces a same-named preset, keeps the rest, checks the
    sibling board has the named user layers first. The three templates have them. FEATURES LIB-33, CHANGELOG.
    Also: a missing period and newline at the end of FEATURES.md's LIB-32 entry.
2026-11-14 Layout notes may go down to 0.05 mm, not just the designator's 0.15 mm floor
    A Layout_Critical/Layout_Important note reads fine much smaller than a designator; fitting it on
    the body matters more than its size. fab::layout_note (NOTE_TINY_SIZE), used by kilib lint --rule
    layout (library placeholder) and kilib designators --board (a set note). Designators and Values
    keep their 0.2/0.15 mm floors (fab::layout unchanged). 30 footprints regenerated (kilib lint
    --rule layout --write); kilib designators confirms nothing else moves.
2026-11-14 Layer presets: show footprints, their text, tracks, zones and the board outline area
2026-11-14 Layer presets: Floorplan, Assembly.Ref/Value split, Layout without notes, Pins without routing, no outline shadow
2026-11-14 Layer presets: Floorplan with designators and Body.F, Assembly without Centroid, Layout with Crit/Imp
2026-11-14 Layout notes hug the courtyard's edge, clear of the designator
    Layout_Critical and Layout_Important sat centred on the body like the
    designator, so the two overlapped on the new Floorplan preset (courtyard,
    fab, Ref.Des and Crit/Imp together). Each now hugs the courtyard's longer
    edge pair (Critical one side, Important the other), clear of the
    designator's own ink and of each other; falls back to the centre, reported,
    where the footprint draws no courtyard (none in the library do: 0 fallbacks
    across 410 footprints).
    kilib lint --rule layout --write regenerated every footprint's notes;
    kilib designators confirms the designator and Value are untouched.
    Tested: cargo nextest run --workspace (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
2026-11-14 Layer presets: Silk shows silkscreen and mask only
2026-11-14 Footprints: layout notes refitted, turned where larger
    Tested: kilib designators: nothing to change; just test --changed
2026-11-14 Body.F/B: a front/back pair on User.5/6
    User.2 is a plain layer, so a bottom part's body stayed on it unflipped.
    KiCad flips user layers only in odd/even pairs; User.5/6 is free in every
    board and template. kilib layers names the pair, moves footprint bodies off
    User.2 by side, drops User.2's old name. Floorplan.B shows Body.B.
    Tested: cargo nextest (177 pass); pcbnew flip of User.5 lands on User.6.
2026-11-14 kilib footprint chip: the table body on Body.F
    Each generated footprint draws its body from the table on User.5 (a
    rectangle; chamfered or round inductor corners as a polygon), replacing
    any body the base drew. The 192 generated footprints are made again.
    Tested: cargo nextest -p kilib chip; regenerated files differ only by the body.
2026-11-14 Footprints: Body.F from the STEP models for 121 parts
    Every real part with a model and no body gets its model's top view on
    User.5, drawn by hw footprint_tools body.py; nothing else in the files
    changes. 15 parts without a found model are left without one.
    Tested: kilib lint and designators on the library: same output as main;
    kicad-cli renders of 0402, SOT-23-6, QFN-12, LMLP07A7, pin socket, LQFP-48.
2026-11-14 Pin numbers inside the part, reading left to right or down
    Inside the fab outline at the pad's inner end, 0° or 270°; outside only as last resort, reported. designators --board turns a placed part's numbers.
    Tested: just test --changed, just lint; kicad-cli fp and pcb svg renders of SOT-23-5, QFN-36, TSSOP-8, 2x3 header, a rotated board part.
2026-11-14 Footprints: pin numbers regenerated inside the body
    kilib lint --rule pins --write: 138 footprints; 37 keep some numbers outside.
    Tested: kilib lint and kilib designators report nothing new.
2026-11-14 Every text reads left to right or top to bottom
    Shared kilib::reading: 0° or 270° on the front, 0° or 90° on the back, a part's rotation included. Designators, Values, notes and pin numbers use it.
    Tested: just test --changed, just lint; kicad-cli renders of rotated and mirrored texts; designators --board on a copy of b153a.
2026-11-14 Footprints: texts regenerated to read top to bottom
    kilib designators --write, kilib lint --write: turned designators, Values and notes at 270°; pin numbers a glyph apart.
    Tested: kilib lint and kilib designators report nothing to change.
2026-11-14 Footprints: pins and texts regenerated on main's bodies
    Conflicts with 0.5.5 took main's files; kilib lint --write and designators --write rerun.
    Tested: kilib lint and kilib designators report nothing to change; just test --changed, just lint.
2026-11-14 Layers: Xray.F/B on User.7/8, Pins presets show it
    Xray.F/B carry every edge of a part's 3D model seen from above, hidden
    ones included. kilib layers names the pair; the templates have it and
    their Pins presets show Xray in place of Body. Footprints follow.
    Tested: cargo nextest run --workspace (186 passed).
2026-11-14 kilib footprint chip: x-ray view of the model on Xray.F
    Every edge of the generated model's solids seen from above goes on
    Xray.F as fp_lines: terminations, bottom electrodes, overcoat, LED die
    and lens. Lines on one line merge; parallel lines 0.02 mm apart are one.
    Tested: cargo nextest run --workspace (188 passed), clippy clean.
2026-11-14 Footprints: chip parts draw their x-ray view on Xray.F
    The 192 footprints of kilib footprint chip, made again; only the
    Xray.F lines are new (6 to 28 per part).
    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
2026-11-14 Footprints: the 48 connector bodies of 7 Nov drawn again
    The Body.F outlines the courtyard run drew had up to 448 corners and
    slivers. hw footprint_tools body.py --redo draws them as the other
    bodies: one outline per piece, at most 64 corners.
    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
2026-11-14 Footprints: Xray.F from the STEP models
    169 footprints draw every edge of their STEP model seen from above,
    hidden ones included, on Xray.F (hw footprint_tools fc_xray.py and
    xray.py): median 52 items, at most 600.
    Tested: kilib lint, lint --rule pins, designators: nothing to change;
    kicad-cli fp upgrade reads every library.
2026-11-14 Footprints: Xray.F redrawn with closed curves, nothing dropped
    The 169 STEP-model x-ray views come from hw footprint_tools 6caf3ab:
    rounds as arcs and circles, short edges kept, only duplicates removed.
    Fixes: b22b595a86a7 ("Footprints: Xray.F from the STEP models")
    Tested: kilib lint/designators output unchanged; KiCad loads all 145.
2026-11-14 kilib: Pin1.F/B layers and lint rule pin1-body
    A filled pin-1 dot on User.29/30 by pin 1, inside the body outline
    or just outside it, never ambiguous under the turns the pads allow.
    Tested: just test --changed, just lint.
2026-11-14 Footprints: pin-1 dot on Pin1.F (171 footprints)
    kilib lint --rule pin1-body --write footprints. 3 reversible
    connectors are left: A1 and B12 share one spot.
    Tested: kilib lint --rule pin1-body footprints reports nothing to fix; kicad-cli SVG renders.
2026-11-14 Layer presets: Assembly shows Body and Pin1, Floorplan Pin1
    kilib layers --write and kilib presets --write on the 3 templates.
    Tested: just test --changed (tests/layer_presets.rs).
2026-11-14 Docs: pin-1 dot count is 198 footprints
2026-11-14 kilib: rework pin1-body (bar for polar parts, no search, skip asymmetric)
    The dot sits exactly on pin 1's own pad (its anchor), not searched
    for a free spot, with no overlap check. A polar two-pin part (diode,
    LED, polarised capacitor, battery) gets a bar across the cathode or
    plus pad instead, square to the part's axis. A part of three or more
    pins whose pads already tell pin 1 apart (no turn the pads allow,
    pin1's own turns, lands pin 1 on another pad: SOT-23, SOT-323,
    SOT-89, SOT-223...) gets no mark; a symmetric part (QFN, QFP, SOIC,
    SOT-23-6, SOT-363, a symmetric connector) keeps the dot.
    Tested: cargo nextest run -p kilib (lint::pin1, lint::pin1_body).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
2026-11-14 Footprints: Pin1.F/B regenerated (198 footprints)
    kilib lint --rule pin1-body --write footprints. 99 dots (on pad 1's
    own centre), 58 bars (polar two-pin parts), 41 asymmetric parts lost
    their dot (the pads already tell pin 1 apart). Nothing left for a
    person.
    Tested: kilib lint and kilib designators report nothing else new.
2026-11-14 kilib: no pin-1 marks on parts that work turned half round
    Symbols using a footprint decide: same-named pins and generate/connected-pins.toml
    groups are one node; a non-polar part may swap its two. SOT-23-class parts and these
    lose silk, fab and Xray pin-1 marks; Pin1 dot only where a wrong turn matters.
2026-11-14 Footprints: pin-1 marks off 15 symmetric or self-telling parts
2026-11-14 kilib: no pin-1 marks on keyed connectors
    A connector, switch or mechanical part that no turn fits (pads incl.
    holes, shape, side, body) loses silk, fab and Pin1 marks, incl. KiCad's
    fab notch and silk tick. A counted row of 4+ pads keeps marks and dot.
2026-11-14 Footprints: pin-1 marks off keyed connectors (28 footprints)
    Generated with kilib lint --rule pin1,pin1-body --write; L77SDE09SA4CH's
    designator and Layout fields moved after it.
