vhrdtech/kicad-library/(notices)

Notices in the files:
3dmodels/connectors/samtec/QTH-030-02-F-D-A.step:
author */ ('License CC BY-ND 4.0'),
